gmaxdragon/Seizo-Screen/pcb-front.png

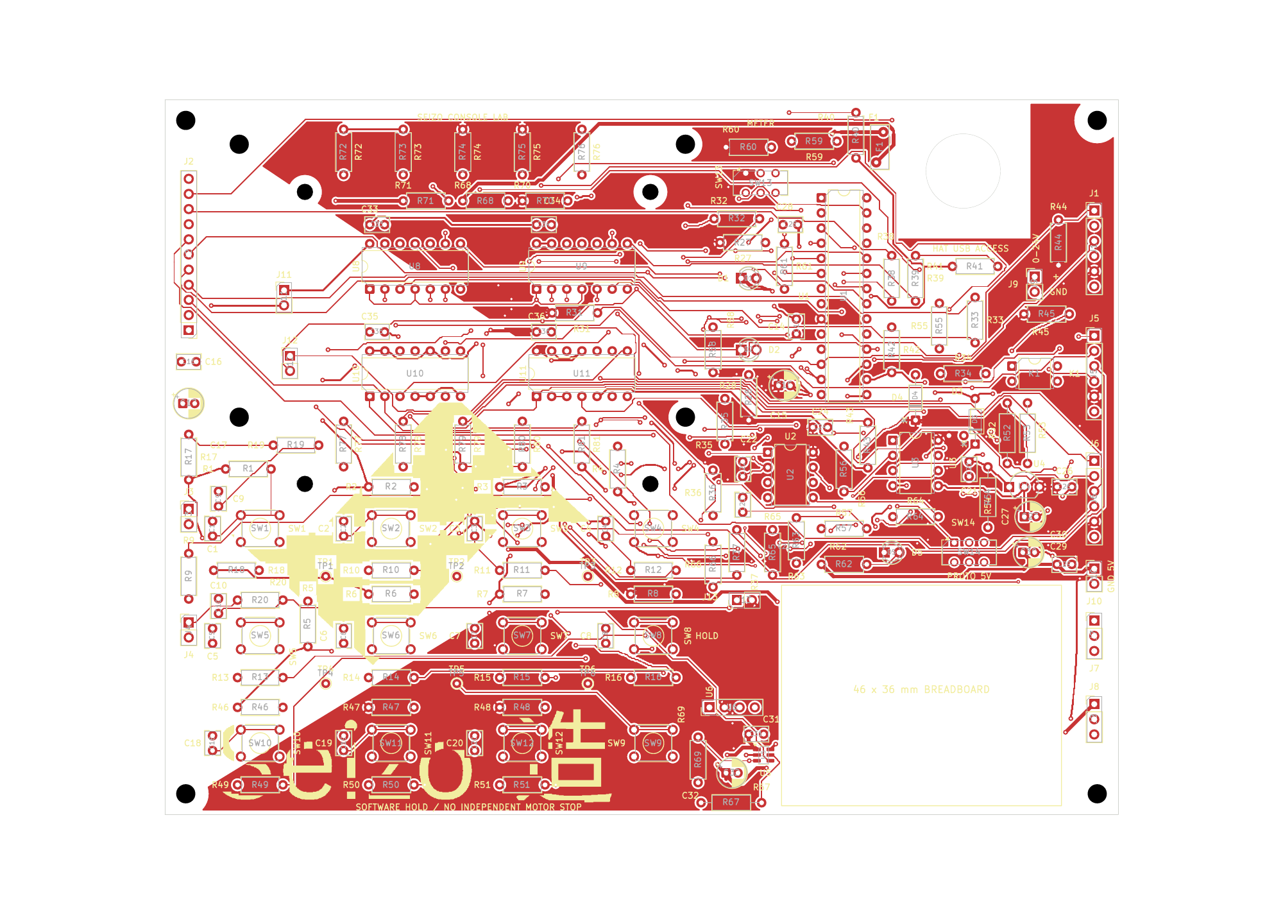
pcb-front.png
