gmaxdragon/Seizo-Screen/quotes/pcbway/preliminary-calculator.png

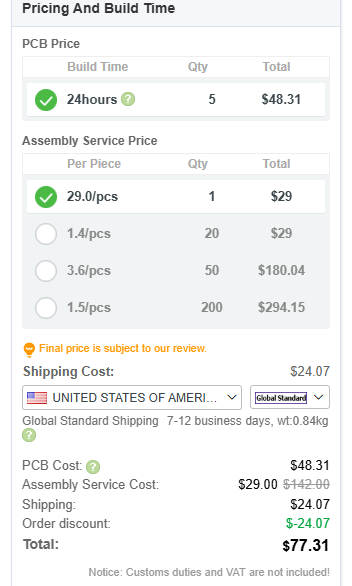
quotes/pcbway/preliminary-calculator.png
