gmaxdragon/Seizo-Screen/schematic-preview.png

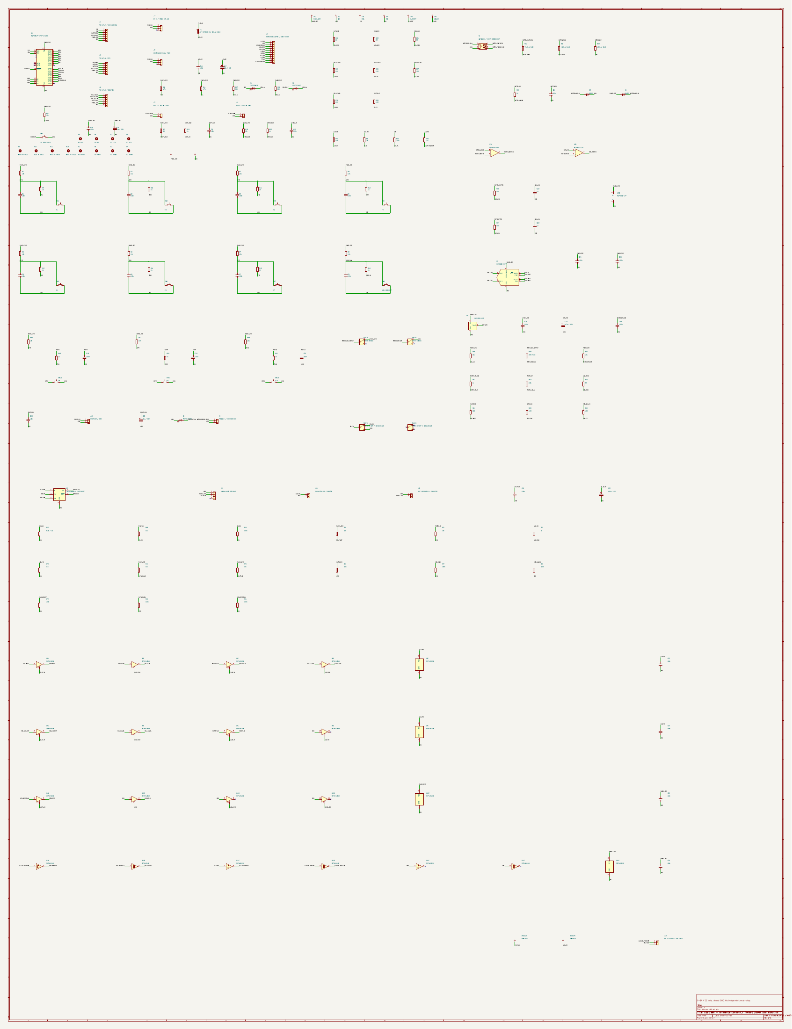
schematic-preview.png
