gmaxdragon/Seizo-Screen/Real_BOM.csv

NOTICE | Created because Half-Life's parts list had an 80-item (row) limit. Real_BOM.csv gives the complete ungrouped details; 00-bom-halflife.csv is the grouped 27-row submission import.
SCOPE | One assembled revision-23 panel: all 150 fitted components individually listed. The 48 fitted matching-HAT parts are separately identified dependencies outside the current panel quotation.
USE | Detailed reviewer/reference BOM. Keep assembly/BOM-PCBWay-panel.csv as the supplier assembly BOM. Do not import this detailed file into the 80-row funding form.
PRICES | Blank factory-price cells mean UNQUOTED. Historical references are dated 2026-10-31, not current offers. Preliminary PCB batch $48.31 plus assembly $29.00 excludes component supply. Shipping/tax go in the separate funding fields.
STATUS | Actual PCBWay panel RFQ submitted; supplier audit, exact cable/hardware sourcing, LCD tap qualification and physical tests pending. Independent arm stopping/gravity retention is a separate unresolved system.
QUANTITIES | Fitted-component quantities are for one board. Bare-PCB batch quantity is five; assembled-panel quantity is one. Zero-quantity features/DNP/owned-service checks are not new component orders.
Line | Section | Board | Reference | Description | Value | Quantity | Unit | Procurement scope | Manufacturer | Manufacturer part number | Distributor part number | KiCad footprint | Assembly process | PCB side | Factory quoted unit USD | Factory quoted line USD | Price status | Historical reference unit USD | Historical reference line USD | Price checked date | Product or reference source | Primary datasheet | Fit and assembly notes | Remaining confirmation | Source record
1 | Fitted component | Panel | C1 | 100n | 100n | 1 | piece | Panel assembly: new component supply | KEMET | C315C104K5R5TA | 399-C315C104K5R5TA-ND | Capacitor_THT:C_Rect_L4.0mm_W2.5mm_P2.50mm | THT | Top |  |  | Factory component price unquoted; historical price is a reference only | 0.488 | 0.488 | 2026-10-31 | https://www.digikey.com/en/products/detail/kemet/C315C104K5R5TA/12701330 | https://search.kemet.com/component-documentation/download/specsheet/C315C104K5R5TA | X7R 50V +/-10%; do not replace with large 5.08 mm-pitch discs. C25 is BACK; exact maximum envelope must be included in final opposite-side solder clearance check. No unapproved substitutions. L<=3.81 mm; T<=2.54 mm; H<=3.14 mm; coating below body<=1.52 mm; seated envelope<=4.66 mm; lead 0.51 +0.10/-0.025 mm; spacing 2.54 +/-0.78 mm; formed to PCB 2.50 mm | Final supplier sourcing/price and physical assembly/functional tests pending. | assembly/BOM-PCBWay-panel.csv; group 1; reports/panel-netlist.xml
2 | Fitted component | Panel | C2 | 100n | 100n | 1 | piece | Panel assembly: new component supply | KEMET | C315C104K5R5TA | 399-C315C104K5R5TA-ND | Capacitor_THT:C_Rect_L4.0mm_W2.5mm_P2.50mm | THT | Top |  |  | Factory component price unquoted; historical price is a reference only | 0.488 | 0.488 | 2026-10-31 | https://www.digikey.com/en/products/detail/kemet/C315C104K5R5TA/12701330 | https://search.kemet.com/component-documentation/download/specsheet/C315C104K5R5TA | X7R 50V +/-10%; do not replace with large 5.08 mm-pitch discs. C25 is BACK; exact maximum envelope must be included in final opposite-side solder clearance check. No unapproved substitutions. L<=3.81 mm; T<=2.54 mm; H<=3.14 mm; coating below body<=1.52 mm; seated envelope<=4.66 mm; lead 0.51 +0.10/-0.025 mm; spacing 2.54 +/-0.78 mm; formed to PCB 2.50 mm | Final supplier sourcing/price and physical assembly/functional tests pending. | assembly/BOM-PCBWay-panel.csv; group 1; reports/panel-netlist.xml
3 | Fitted component | Panel | C3 | 100n | 100n | 1 | piece | Panel assembly: new component supply | KEMET | C315C104K5R5TA | 399-C315C104K5R5TA-ND | Capacitor_THT:C_Rect_L4.0mm_W2.5mm_P2.50mm | THT | Top |  |  | Factory component price unquoted; historical price is a reference only | 0.488 | 0.488 | 2026-10-31 | https://www.digikey.com/en/products/detail/kemet/C315C104K5R5TA/12701330 | https://search.kemet.com/component-documentation/download/specsheet/C315C104K5R5TA | X7R 50V +/-10%; do not replace with large 5.08 mm-pitch discs. C25 is BACK; exact maximum envelope must be included in final opposite-side solder clearance check. No unapproved substitutions. L<=3.81 mm; T<=2.54 mm; H<=3.14 mm; coating below body<=1.52 mm; seated envelope<=4.66 mm; lead 0.51 +0.10/-0.025 mm; spacing 2.54 +/-0.78 mm; formed to PCB 2.50 mm | Final supplier sourcing/price and physical assembly/functional tests pending. | assembly/BOM-PCBWay-panel.csv; group 1; reports/panel-netlist.xml
4 | Fitted component | Panel | C4 | 100n | 100n | 1 | piece | Panel assembly: new component supply | KEMET | C315C104K5R5TA | 399-C315C104K5R5TA-ND | Capacitor_THT:C_Rect_L4.0mm_W2.5mm_P2.50mm | THT | Top |  |  | Factory component price unquoted; historical price is a reference only | 0.488 | 0.488 | 2026-10-31 | https://www.digikey.com/en/products/detail/kemet/C315C104K5R5TA/12701330 | https://search.kemet.com/component-documentation/download/specsheet/C315C104K5R5TA | X7R 50V +/-10%; do not replace with large 5.08 mm-pitch discs. C25 is BACK; exact maximum envelope must be included in final opposite-side solder clearance check. No unapproved substitutions. L<=3.81 mm; T<=2.54 mm; H<=3.14 mm; coating below body<=1.52 mm; seated envelope<=4.66 mm; lead 0.51 +0.10/-0.025 mm; spacing 2.54 +/-0.78 mm; formed to PCB 2.50 mm | Final supplier sourcing/price and physical assembly/functional tests pending. | assembly/BOM-PCBWay-panel.csv; group 1; reports/panel-netlist.xml
5 | Fitted component | Panel | C5 | 100n | 100n | 1 | piece | Panel assembly: new component supply | KEMET | C315C104K5R5TA | 399-C315C104K5R5TA-ND | Capacitor_THT:C_Rect_L4.0mm_W2.5mm_P2.50mm | THT | Top |  |  | Factory component price unquoted; historical price is a reference only | 0.488 | 0.488 | 2026-10-31 | https://www.digikey.com/en/products/detail/kemet/C315C104K5R5TA/12701330 | https://search.kemet.com/component-documentation/download/specsheet/C315C104K5R5TA | X7R 50V +/-10%; do not replace with large 5.08 mm-pitch discs. C25 is BACK; exact maximum envelope must be included in final opposite-side solder clearance check. No unapproved substitutions. L<=3.81 mm; T<=2.54 mm; H<=3.14 mm; coating below body<=1.52 mm; seated envelope<=4.66 mm; lead 0.51 +0.10/-0.025 mm; spacing 2.54 +/-0.78 mm; formed to PCB 2.50 mm | Final supplier sourcing/price and physical assembly/functional tests pending. | assembly/BOM-PCBWay-panel.csv; group 1; reports/panel-netlist.xml
6 | Fitted component | Panel | C6 | 100n | 100n | 1 | piece | Panel assembly: new component supply | KEMET | C315C104K5R5TA | 399-C315C104K5R5TA-ND | Capacitor_THT:C_Rect_L4.0mm_W2.5mm_P2.50mm | THT | Top |  |  | Factory component price unquoted; historical price is a reference only | 0.488 | 0.488 | 2026-10-31 | https://www.digikey.com/en/products/detail/kemet/C315C104K5R5TA/12701330 | https://search.kemet.com/component-documentation/download/specsheet/C315C104K5R5TA | X7R 50V +/-10%; do not replace with large 5.08 mm-pitch discs. C25 is BACK; exact maximum envelope must be included in final opposite-side solder clearance check. No unapproved substitutions. L<=3.81 mm; T<=2.54 mm; H<=3.14 mm; coating below body<=1.52 mm; seated envelope<=4.66 mm; lead 0.51 +0.10/-0.025 mm; spacing 2.54 +/-0.78 mm; formed to PCB 2.50 mm | Final supplier sourcing/price and physical assembly/functional tests pending. | assembly/BOM-PCBWay-panel.csv; group 1; reports/panel-netlist.xml
7 | Fitted component | Panel | C7 | 100n | 100n | 1 | piece | Panel assembly: new component supply | KEMET | C315C104K5R5TA | 399-C315C104K5R5TA-ND | Capacitor_THT:C_Rect_L4.0mm_W2.5mm_P2.50mm | THT | Top |  |  | Factory component price unquoted; historical price is a reference only | 0.488 | 0.488 | 2026-10-31 | https://www.digikey.com/en/products/detail/kemet/C315C104K5R5TA/12701330 | https://search.kemet.com/component-documentation/download/specsheet/C315C104K5R5TA | X7R 50V +/-10%; do not replace with large 5.08 mm-pitch discs. C25 is BACK; exact maximum envelope must be included in final opposite-side solder clearance check. No unapproved substitutions. L<=3.81 mm; T<=2.54 mm; H<=3.14 mm; coating below body<=1.52 mm; seated envelope<=4.66 mm; lead 0.51 +0.10/-0.025 mm; spacing 2.54 +/-0.78 mm; formed to PCB 2.50 mm | Final supplier sourcing/price and physical assembly/functional tests pending. | assembly/BOM-PCBWay-panel.csv; group 1; reports/panel-netlist.xml
8 | Fitted component | Panel | C8 | 100n | 100n | 1 | piece | Panel assembly: new component supply | KEMET | C315C104K5R5TA | 399-C315C104K5R5TA-ND | Capacitor_THT:C_Rect_L4.0mm_W2.5mm_P2.50mm | THT | Top |  |  | Factory component price unquoted; historical price is a reference only | 0.488 | 0.488 | 2026-10-31 | https://www.digikey.com/en/products/detail/kemet/C315C104K5R5TA/12701330 | https://search.kemet.com/component-documentation/download/specsheet/C315C104K5R5TA | X7R 50V +/-10%; do not replace with large 5.08 mm-pitch discs. C25 is BACK; exact maximum envelope must be included in final opposite-side solder clearance check. No unapproved substitutions. L<=3.81 mm; T<=2.54 mm; H<=3.14 mm; coating below body<=1.52 mm; seated envelope<=4.66 mm; lead 0.51 +0.10/-0.025 mm; spacing 2.54 +/-0.78 mm; formed to PCB 2.50 mm | Final supplier sourcing/price and physical assembly/functional tests pending. | assembly/BOM-PCBWay-panel.csv; group 1; reports/panel-netlist.xml
9 | Fitted component | Panel | C9 | 100n | 100n | 1 | piece | Panel assembly: new component supply | KEMET | C315C104K5R5TA | 399-C315C104K5R5TA-ND | Capacitor_THT:C_Rect_L4.0mm_W2.5mm_P2.50mm | THT | Top |  |  | Factory component price unquoted; historical price is a reference only | 0.488 | 0.488 | 2026-10-31 | https://www.digikey.com/en/products/detail/kemet/C315C104K5R5TA/12701330 | https://search.kemet.com/component-documentation/download/specsheet/C315C104K5R5TA | X7R 50V +/-10%; do not replace with large 5.08 mm-pitch discs. C25 is BACK; exact maximum envelope must be included in final opposite-side solder clearance check. No unapproved substitutions. L<=3.81 mm; T<=2.54 mm; H<=3.14 mm; coating below body<=1.52 mm; seated envelope<=4.66 mm; lead 0.51 +0.10/-0.025 mm; spacing 2.54 +/-0.78 mm; formed to PCB 2.50 mm | Final supplier sourcing/price and physical assembly/functional tests pending. | assembly/BOM-PCBWay-panel.csv; group 1; reports/panel-netlist.xml
10 | Fitted component | Panel | C10 | 100n | 100n | 1 | piece | Panel assembly: new component supply | KEMET | C315C104K5R5TA | 399-C315C104K5R5TA-ND | Capacitor_THT:C_Rect_L4.0mm_W2.5mm_P2.50mm | THT | Top |  |  | Factory component price unquoted; historical price is a reference only | 0.488 | 0.488 | 2026-10-31 | https://www.digikey.com/en/products/detail/kemet/C315C104K5R5TA/12701330 | https://search.kemet.com/component-documentation/download/specsheet/C315C104K5R5TA | X7R 50V +/-10%; do not replace with large 5.08 mm-pitch discs. C25 is BACK; exact maximum envelope must be included in final opposite-side solder clearance check. No unapproved substitutions. L<=3.81 mm; T<=2.54 mm; H<=3.14 mm; coating below body<=1.52 mm; seated envelope<=4.66 mm; lead 0.51 +0.10/-0.025 mm; spacing 2.54 +/-0.78 mm; formed to PCB 2.50 mm | Final supplier sourcing/price and physical assembly/functional tests pending. | assembly/BOM-PCBWay-panel.csv; group 1; reports/panel-netlist.xml
11 | Fitted component | Panel | C14 | 100n | 100n | 1 | piece | Panel assembly: new component supply | KEMET | C315C104K5R5TA | 399-C315C104K5R5TA-ND | Capacitor_THT:C_Rect_L4.0mm_W2.5mm_P2.50mm | THT | Top |  |  | Factory component price unquoted; historical price is a reference only | 0.488 | 0.488 | 2026-10-31 | https://www.digikey.com/en/products/detail/kemet/C315C104K5R5TA/12701330 | https://search.kemet.com/component-documentation/download/specsheet/C315C104K5R5TA | X7R 50V +/-10%; do not replace with large 5.08 mm-pitch discs. C25 is BACK; exact maximum envelope must be included in final opposite-side solder clearance check. No unapproved substitutions. L<=3.81 mm; T<=2.54 mm; H<=3.14 mm; coating below body<=1.52 mm; seated envelope<=4.66 mm; lead 0.51 +0.10/-0.025 mm; spacing 2.54 +/-0.78 mm; formed to PCB 2.50 mm | Final supplier sourcing/price and physical assembly/functional tests pending. | assembly/BOM-PCBWay-panel.csv; group 1; reports/panel-netlist.xml
12 | Fitted component | Panel | C16 | 100n | 100n | 1 | piece | Panel assembly: new component supply | KEMET | C315C104K5R5TA | 399-C315C104K5R5TA-ND | Capacitor_THT:C_Rect_L4.0mm_W2.5mm_P2.50mm | THT | Top |  |  | Factory component price unquoted; historical price is a reference only | 0.488 | 0.488 | 2026-10-31 | https://www.digikey.com/en/products/detail/kemet/C315C104K5R5TA/12701330 | https://search.kemet.com/component-documentation/download/specsheet/C315C104K5R5TA | X7R 50V +/-10%; do not replace with large 5.08 mm-pitch discs. C25 is BACK; exact maximum envelope must be included in final opposite-side solder clearance check. No unapproved substitutions. L<=3.81 mm; T<=2.54 mm; H<=3.14 mm; coating below body<=1.52 mm; seated envelope<=4.66 mm; lead 0.51 +0.10/-0.025 mm; spacing 2.54 +/-0.78 mm; formed to PCB 2.50 mm | Final supplier sourcing/price and physical assembly/functional tests pending. | assembly/BOM-PCBWay-panel.csv; group 1; reports/panel-netlist.xml
13 | Fitted component | Panel | C18 | 100n | 100n | 1 | piece | Panel assembly: new component supply | KEMET | C315C104K5R5TA | 399-C315C104K5R5TA-ND | Capacitor_THT:C_Rect_L4.0mm_W2.5mm_P2.50mm | THT | Top |  |  | Factory component price unquoted; historical price is a reference only | 0.488 | 0.488 | 2026-10-31 | https://www.digikey.com/en/products/detail/kemet/C315C104K5R5TA/12701330 | https://search.kemet.com/component-documentation/download/specsheet/C315C104K5R5TA | X7R 50V +/-10%; do not replace with large 5.08 mm-pitch discs. C25 is BACK; exact maximum envelope must be included in final opposite-side solder clearance check. No unapproved substitutions. L<=3.81 mm; T<=2.54 mm; H<=3.14 mm; coating below body<=1.52 mm; seated envelope<=4.66 mm; lead 0.51 +0.10/-0.025 mm; spacing 2.54 +/-0.78 mm; formed to PCB 2.50 mm | Final supplier sourcing/price and physical assembly/functional tests pending. | assembly/BOM-PCBWay-panel.csv; group 1; reports/panel-netlist.xml
14 | Fitted component | Panel | C19 | 100n | 100n | 1 | piece | Panel assembly: new component supply | KEMET | C315C104K5R5TA | 399-C315C104K5R5TA-ND | Capacitor_THT:C_Rect_L4.0mm_W2.5mm_P2.50mm | THT | Top |  |  | Factory component price unquoted; historical price is a reference only | 0.488 | 0.488 | 2026-10-31 | https://www.digikey.com/en/products/detail/kemet/C315C104K5R5TA/12701330 | https://search.kemet.com/component-documentation/download/specsheet/C315C104K5R5TA | X7R 50V +/-10%; do not replace with large 5.08 mm-pitch discs. C25 is BACK; exact maximum envelope must be included in final opposite-side solder clearance check. No unapproved substitutions. L<=3.81 mm; T<=2.54 mm; H<=3.14 mm; coating below body<=1.52 mm; seated envelope<=4.66 mm; lead 0.51 +0.10/-0.025 mm; spacing 2.54 +/-0.78 mm; formed to PCB 2.50 mm | Final supplier sourcing/price and physical assembly/functional tests pending. | assembly/BOM-PCBWay-panel.csv; group 1; reports/panel-netlist.xml
15 | Fitted component | Panel | C20 | 100n | 100n | 1 | piece | Panel assembly: new component supply | KEMET | C315C104K5R5TA | 399-C315C104K5R5TA-ND | Capacitor_THT:C_Rect_L4.0mm_W2.5mm_P2.50mm | THT | Top |  |  | Factory component price unquoted; historical price is a reference only | 0.488 | 0.488 | 2026-10-31 | https://www.digikey.com/en/products/detail/kemet/C315C104K5R5TA/12701330 | https://search.kemet.com/component-documentation/download/specsheet/C315C104K5R5TA | X7R 50V +/-10%; do not replace with large 5.08 mm-pitch discs. C25 is BACK; exact maximum envelope must be included in final opposite-side solder clearance check. No unapproved substitutions. L<=3.81 mm; T<=2.54 mm; H<=3.14 mm; coating below body<=1.52 mm; seated envelope<=4.66 mm; lead 0.51 +0.10/-0.025 mm; spacing 2.54 +/-0.78 mm; formed to PCB 2.50 mm | Final supplier sourcing/price and physical assembly/functional tests pending. | assembly/BOM-PCBWay-panel.csv; group 1; reports/panel-netlist.xml
16 | Fitted component | Panel | C21 | 100n | 100n | 1 | piece | Panel assembly: new component supply | KEMET | C315C104K5R5TA | 399-C315C104K5R5TA-ND | Capacitor_THT:C_Rect_L4.0mm_W2.5mm_P2.50mm | THT | Top |  |  | Factory component price unquoted; historical price is a reference only | 0.488 | 0.488 | 2026-10-31 | https://www.digikey.com/en/products/detail/kemet/C315C104K5R5TA/12701330 | https://search.kemet.com/component-documentation/download/specsheet/C315C104K5R5TA | X7R 50V +/-10%; do not replace with large 5.08 mm-pitch discs. C25 is BACK; exact maximum envelope must be included in final opposite-side solder clearance check. No unapproved substitutions. L<=3.81 mm; T<=2.54 mm; H<=3.14 mm; coating below body<=1.52 mm; seated envelope<=4.66 mm; lead 0.51 +0.10/-0.025 mm; spacing 2.54 +/-0.78 mm; formed to PCB 2.50 mm | Final supplier sourcing/price and physical assembly/functional tests pending. | assembly/BOM-PCBWay-panel.csv; group 1; reports/panel-netlist.xml
17 | Fitted component | Panel | C24 | 100n | 100n | 1 | piece | Panel assembly: new component supply | KEMET | C315C104K5R5TA | 399-C315C104K5R5TA-ND | Capacitor_THT:C_Rect_L4.0mm_W2.5mm_P2.50mm | THT | Top |  |  | Factory component price unquoted; historical price is a reference only | 0.488 | 0.488 | 2026-10-31 | https://www.digikey.com/en/products/detail/kemet/C315C104K5R5TA/12701330 | https://search.kemet.com/component-documentation/download/specsheet/C315C104K5R5TA | X7R 50V +/-10%; do not replace with large 5.08 mm-pitch discs. C25 is BACK; exact maximum envelope must be included in final opposite-side solder clearance check. No unapproved substitutions. L<=3.81 mm; T<=2.54 mm; H<=3.14 mm; coating below body<=1.52 mm; seated envelope<=4.66 mm; lead 0.51 +0.10/-0.025 mm; spacing 2.54 +/-0.78 mm; formed to PCB 2.50 mm | Final supplier sourcing/price and physical assembly/functional tests pending. | assembly/BOM-PCBWay-panel.csv; group 1; reports/panel-netlist.xml
18 | Fitted component | Panel | C26 | 100n | 100n | 1 | piece | Panel assembly: new component supply | KEMET | C315C104K5R5TA | 399-C315C104K5R5TA-ND | Capacitor_THT:C_Rect_L4.0mm_W2.5mm_P2.50mm | THT | Top |  |  | Factory component price unquoted; historical price is a reference only | 0.488 | 0.488 | 2026-10-31 | https://www.digikey.com/en/products/detail/kemet/C315C104K5R5TA/12701330 | https://search.kemet.com/component-documentation/download/specsheet/C315C104K5R5TA | X7R 50V +/-10%; do not replace with large 5.08 mm-pitch discs. C25 is BACK; exact maximum envelope must be included in final opposite-side solder clearance check. No unapproved substitutions. L<=3.81 mm; T<=2.54 mm; H<=3.14 mm; coating below body<=1.52 mm; seated envelope<=4.66 mm; lead 0.51 +0.10/-0.025 mm; spacing 2.54 +/-0.78 mm; formed to PCB 2.50 mm | Final supplier sourcing/price and physical assembly/functional tests pending. | assembly/BOM-PCBWay-panel.csv; group 1; reports/panel-netlist.xml
19 | Fitted component | Panel | C28 | 100n | 100n | 1 | piece | Panel assembly: new component supply | KEMET | C315C104K5R5TA | 399-C315C104K5R5TA-ND | Capacitor_THT:C_Rect_L4.0mm_W2.5mm_P2.50mm | THT | Top |  |  | Factory component price unquoted; historical price is a reference only | 0.488 | 0.488 | 2026-10-31 | https://www.digikey.com/en/products/detail/kemet/C315C104K5R5TA/12701330 | https://search.kemet.com/component-documentation/download/specsheet/C315C104K5R5TA | X7R 50V +/-10%; do not replace with large 5.08 mm-pitch discs. C25 is BACK; exact maximum envelope must be included in final opposite-side solder clearance check. No unapproved substitutions. L<=3.81 mm; T<=2.54 mm; H<=3.14 mm; coating below body<=1.52 mm; seated envelope<=4.66 mm; lead 0.51 +0.10/-0.025 mm; spacing 2.54 +/-0.78 mm; formed to PCB 2.50 mm | Final supplier sourcing/price and physical assembly/functional tests pending. | assembly/BOM-PCBWay-panel.csv; group 1; reports/panel-netlist.xml
20 | Fitted component | Panel | C29 | 100n | 100n | 1 | piece | Panel assembly: new component supply | KEMET | C315C104K5R5TA | 399-C315C104K5R5TA-ND | Capacitor_THT:C_Rect_L4.0mm_W2.5mm_P2.50mm | THT | Top |  |  | Factory component price unquoted; historical price is a reference only | 0.488 | 0.488 | 2026-10-31 | https://www.digikey.com/en/products/detail/kemet/C315C104K5R5TA/12701330 | https://search.kemet.com/component-documentation/download/specsheet/C315C104K5R5TA | X7R 50V +/-10%; do not replace with large 5.08 mm-pitch discs. C25 is BACK; exact maximum envelope must be included in final opposite-side solder clearance check. No unapproved substitutions. L<=3.81 mm; T<=2.54 mm; H<=3.14 mm; coating below body<=1.52 mm; seated envelope<=4.66 mm; lead 0.51 +0.10/-0.025 mm; spacing 2.54 +/-0.78 mm; formed to PCB 2.50 mm | Final supplier sourcing/price and physical assembly/functional tests pending. | assembly/BOM-PCBWay-panel.csv; group 1; reports/panel-netlist.xml
21 | Fitted component | Panel | C31 | 100n | 100n | 1 | piece | Panel assembly: new component supply | KEMET | C315C104K5R5TA | 399-C315C104K5R5TA-ND | Capacitor_THT:C_Rect_L4.0mm_W2.5mm_P2.50mm | THT | Top |  |  | Factory component price unquoted; historical price is a reference only | 0.488 | 0.488 | 2026-10-31 | https://www.digikey.com/en/products/detail/kemet/C315C104K5R5TA/12701330 | https://search.kemet.com/component-documentation/download/specsheet/C315C104K5R5TA | X7R 50V +/-10%; do not replace with large 5.08 mm-pitch discs. C25 is BACK; exact maximum envelope must be included in final opposite-side solder clearance check. No unapproved substitutions. L<=3.81 mm; T<=2.54 mm; H<=3.14 mm; coating below body<=1.52 mm; seated envelope<=4.66 mm; lead 0.51 +0.10/-0.025 mm; spacing 2.54 +/-0.78 mm; formed to PCB 2.50 mm | Final supplier sourcing/price and physical assembly/functional tests pending. | assembly/BOM-PCBWay-panel.csv; group 1; reports/panel-netlist.xml
22 | Fitted component | Panel | C33 | 100n | 100n | 1 | piece | Panel assembly: new component supply | KEMET | C315C104K5R5TA | 399-C315C104K5R5TA-ND | Capacitor_THT:C_Rect_L4.0mm_W2.5mm_P2.50mm | THT | Top |  |  | Factory component price unquoted; historical price is a reference only | 0.488 | 0.488 | 2026-10-31 | https://www.digikey.com/en/products/detail/kemet/C315C104K5R5TA/12701330 | https://search.kemet.com/component-documentation/download/specsheet/C315C104K5R5TA | X7R 50V +/-10%; do not replace with large 5.08 mm-pitch discs. C25 is BACK; exact maximum envelope must be included in final opposite-side solder clearance check. No unapproved substitutions. L<=3.81 mm; T<=2.54 mm; H<=3.14 mm; coating below body<=1.52 mm; seated envelope<=4.66 mm; lead 0.51 +0.10/-0.025 mm; spacing 2.54 +/-0.78 mm; formed to PCB 2.50 mm | Final supplier sourcing/price and physical assembly/functional tests pending. | assembly/BOM-PCBWay-panel.csv; group 1; reports/panel-netlist.xml
23 | Fitted component | Panel | C34 | 100n | 100n | 1 | piece | Panel assembly: new component supply | KEMET | C315C104K5R5TA | 399-C315C104K5R5TA-ND | Capacitor_THT:C_Rect_L4.0mm_W2.5mm_P2.50mm | THT | Top |  |  | Factory component price unquoted; historical price is a reference only | 0.488 | 0.488 | 2026-10-31 | https://www.digikey.com/en/products/detail/kemet/C315C104K5R5TA/12701330 | https://search.kemet.com/component-documentation/download/specsheet/C315C104K5R5TA | X7R 50V +/-10%; do not replace with large 5.08 mm-pitch discs. C25 is BACK; exact maximum envelope must be included in final opposite-side solder clearance check. No unapproved substitutions. L<=3.81 mm; T<=2.54 mm; H<=3.14 mm; coating below body<=1.52 mm; seated envelope<=4.66 mm; lead 0.51 +0.10/-0.025 mm; spacing 2.54 +/-0.78 mm; formed to PCB 2.50 mm | Final supplier sourcing/price and physical assembly/functional tests pending. | assembly/BOM-PCBWay-panel.csv; group 1; reports/panel-netlist.xml
24 | Fitted component | Panel | C35 | 100n | 100n | 1 | piece | Panel assembly: new component supply | KEMET | C315C104K5R5TA | 399-C315C104K5R5TA-ND | Capacitor_THT:C_Rect_L4.0mm_W2.5mm_P2.50mm | THT | Top |  |  | Factory component price unquoted; historical price is a reference only | 0.488 | 0.488 | 2026-10-31 | https://www.digikey.com/en/products/detail/kemet/C315C104K5R5TA/12701330 | https://search.kemet.com/component-documentation/download/specsheet/C315C104K5R5TA | X7R 50V +/-10%; do not replace with large 5.08 mm-pitch discs. C25 is BACK; exact maximum envelope must be included in final opposite-side solder clearance check. No unapproved substitutions. L<=3.81 mm; T<=2.54 mm; H<=3.14 mm; coating below body<=1.52 mm; seated envelope<=4.66 mm; lead 0.51 +0.10/-0.025 mm; spacing 2.54 +/-0.78 mm; formed to PCB 2.50 mm | Final supplier sourcing/price and physical assembly/functional tests pending. | assembly/BOM-PCBWay-panel.csv; group 1; reports/panel-netlist.xml
25 | Fitted component | Panel | C36 | 100n | 100n | 1 | piece | Panel assembly: new component supply | KEMET | C315C104K5R5TA | 399-C315C104K5R5TA-ND | Capacitor_THT:C_Rect_L4.0mm_W2.5mm_P2.50mm | THT | Top |  |  | Factory component price unquoted; historical price is a reference only | 0.488 | 0.488 | 2026-10-31 | https://www.digikey.com/en/products/detail/kemet/C315C104K5R5TA/12701330 | https://search.kemet.com/component-documentation/download/specsheet/C315C104K5R5TA | X7R 50V +/-10%; do not replace with large 5.08 mm-pitch discs. C25 is BACK; exact maximum envelope must be included in final opposite-side solder clearance check. No unapproved substitutions. L<=3.81 mm; T<=2.54 mm; H<=3.14 mm; coating below body<=1.52 mm; seated envelope<=4.66 mm; lead 0.51 +0.10/-0.025 mm; spacing 2.54 +/-0.78 mm; formed to PCB 2.50 mm | Final supplier sourcing/price and physical assembly/functional tests pending. | assembly/BOM-PCBWay-panel.csv; group 1; reports/panel-netlist.xml
26 | Fitted component | Panel | C25 | 100n | 100n | 1 | piece | Panel assembly: new component supply | KEMET | C315C104K5R5TA | 399-C315C104K5R5TA-ND | Capacitor_THT:C_Rect_L4.0mm_W2.5mm_P2.50mm | THT | Bottom |  |  | Factory component price unquoted; historical price is a reference only | 0.488 | 0.488 | 2026-10-31 | https://www.digikey.com/en/products/detail/kemet/C315C104K5R5TA/12701330 | https://search.kemet.com/component-documentation/download/specsheet/C315C104K5R5TA | X7R 50V +/-10%; do not replace with large 5.08 mm-pitch discs. C25 is BACK; exact maximum envelope must be included in final opposite-side solder clearance check. Install body at least 1.5mm above rear PCB face; nearby clipped rear lead ends at most 1.0mm; no solder spikes. No unapproved substitutions. L<=3.81 mm; T<=2.54 mm; H<=3.14 mm; coating below body<=1.52 mm; seated envelope<=4.66 mm; lead 0.51 +0.10/-0.025 mm; spacing 2.54 +/-0.78 mm; formed to PCB 2.50 mm | Final supplier sourcing/price and physical assembly/functional tests pending. Check rear body clearance >=1.5 mm and clipped adjacent leads <=1.0 mm. | assembly/BOM-PCBWay-panel.csv; group 2; reports/panel-netlist.xml
27 | Fitted component | Panel | C22 | 1n | 1n | 1 | piece | Panel assembly: new component supply | KEMET | C315C102J1G5TA | 399-4143-ND | Capacitor_THT:C_Rect_L4.0mm_W2.5mm_P2.50mm | THT | Top |  |  | Factory component price unquoted; historical price is a reference only | 0.77 | 0.77 | 2026-10-31 | https://www.digikey.com/en/products/detail/kemet/C315C102J1G5TA/817919 | https://yageogroup.com/content/datasheet/asset/file/KEM_C1049_GOLDMAX_C0G | C0G 100V +/-5%; retain low-loss dielectric. No unapproved substitutions. L<=3.81 mm; T<=2.54 mm; H<=3.14 mm; coating below body<=1.52 mm; seated envelope<=4.66 mm; lead 0.51 +0.10/-0.025 mm; spacing 2.54 +/-0.78 mm; formed to PCB 2.50 mm | Final supplier sourcing/price and physical assembly/functional tests pending. | assembly/BOM-PCBWay-panel.csv; group 3; reports/panel-netlist.xml
28 | Fitted component | Panel | C23 | 1n | 1n | 1 | piece | Panel assembly: new component supply | KEMET | C315C102J1G5TA | 399-4143-ND | Capacitor_THT:C_Rect_L4.0mm_W2.5mm_P2.50mm | THT | Top |  |  | Factory component price unquoted; historical price is a reference only | 0.77 | 0.77 | 2026-10-31 | https://www.digikey.com/en/products/detail/kemet/C315C102J1G5TA/817919 | https://yageogroup.com/content/datasheet/asset/file/KEM_C1049_GOLDMAX_C0G | C0G 100V +/-5%; retain low-loss dielectric. No unapproved substitutions. L<=3.81 mm; T<=2.54 mm; H<=3.14 mm; coating below body<=1.52 mm; seated envelope<=4.66 mm; lead 0.51 +0.10/-0.025 mm; spacing 2.54 +/-0.78 mm; formed to PCB 2.50 mm | Final supplier sourcing/price and physical assembly/functional tests pending. | assembly/BOM-PCBWay-panel.csv; group 3; reports/panel-netlist.xml
29 | Fitted component | Panel | C15 | 10u / 50V | 10u / 50V | 1 | piece | Panel assembly: new component supply | Panasonic | EEU-FR1H100 | P124233-ND | Capacitor_THT:CP_Radial_D5.0mm_P2.00mm | THT | Top |  |  | Factory component price unquoted; historical price is a reference only | 0.41 | 0.41 | 2026-10-31 | https://www.digikey.com/en/products/detail/panasonic-industry/EEU-FR1H100/9921028 | https://industrial.panasonic.com/cdbs/www-data/pdf/RDF0000/ABA0000C1259.pdf | Polarized; lead pitch is 2 mm, not 2.5 mm. Manufacturer model dimensions also available at Panasonic product page. No unapproved substitutions. Body sleeveD5.0+/-0.5=>5.5MAX, L11+/-1.5=>12.5MAX mm; P2.0+/-0.5 mm; lead0.50+/-0.05=>0.55MAX mm | Final supplier sourcing/price and physical assembly/functional tests pending. | assembly/BOM-PCBWay-panel.csv; group 4; reports/panel-netlist.xml
30 | Fitted component | Panel | C17 | 10u / 50V | 10u / 50V | 1 | piece | Panel assembly: new component supply | Panasonic | EEU-FR1H100 | P124233-ND | Capacitor_THT:CP_Radial_D5.0mm_P2.00mm | THT | Top |  |  | Factory component price unquoted; historical price is a reference only | 0.41 | 0.41 | 2026-10-31 | https://www.digikey.com/en/products/detail/panasonic-industry/EEU-FR1H100/9921028 | https://industrial.panasonic.com/cdbs/www-data/pdf/RDF0000/ABA0000C1259.pdf | Polarized; lead pitch is 2 mm, not 2.5 mm. Manufacturer model dimensions also available at Panasonic product page. No unapproved substitutions. Body sleeveD5.0+/-0.5=>5.5MAX, L11+/-1.5=>12.5MAX mm; P2.0+/-0.5 mm; lead0.50+/-0.05=>0.55MAX mm | Final supplier sourcing/price and physical assembly/functional tests pending. | assembly/BOM-PCBWay-panel.csv; group 4; reports/panel-netlist.xml
31 | Fitted component | Panel | C30 | 10u / 50V | 10u / 50V | 1 | piece | Panel assembly: new component supply | Panasonic | EEU-FR1H100 | P124233-ND | Capacitor_THT:CP_Radial_D5.0mm_P2.00mm | THT | Top |  |  | Factory component price unquoted; historical price is a reference only | 0.41 | 0.41 | 2026-10-31 | https://www.digikey.com/en/products/detail/panasonic-industry/EEU-FR1H100/9921028 | https://industrial.panasonic.com/cdbs/www-data/pdf/RDF0000/ABA0000C1259.pdf | Polarized; lead pitch is 2 mm, not 2.5 mm. Manufacturer model dimensions also available at Panasonic product page. No unapproved substitutions. Body sleeveD5.0+/-0.5=>5.5MAX, L11+/-1.5=>12.5MAX mm; P2.0+/-0.5 mm; lead0.50+/-0.05=>0.55MAX mm | Final supplier sourcing/price and physical assembly/functional tests pending. | assembly/BOM-PCBWay-panel.csv; group 4; reports/panel-netlist.xml
32 | Fitted component | Panel | C27 | 4.7u / 50V | 4.7u / 50V | 1 | piece | Panel assembly: new component supply | Rubycon | 50YXJ4.7M5X11 | 50YXJ4.7M5X11-ND | Capacitor_THT:CP_Radial_D5.0mm_P2.00mm | THT | Top |  |  | Factory component price unquoted; historical price is a reference only | 0.28 | 0.28 | 2026-10-31 | https://www.digikey.com/en/products/detail/rubycon/50YXJ4-7M5X11/3562902 | https://www.rubycon.co.jp/wp-content/uploads/catalog-aluminum/YXJ.pdf | Selected replacement removes separate Mouser shipment. 4.7u+/-20%=3.76..5.64u meets MCP1525 CL1..10u. 50V rating exceeds2.5V rail;5000h105C; leakage<=3uA; impedance1.9ohmMAX@100kHz/20C. MCP1525 datasheet states no numericESRwindow; assembledstartup/noise/stabilityremainprototypechecks. Matchstripe/minus to pad2/GND, positivepad1/REF_2V5. No unapproved substitutions. SleeveD5+0.5=>5.5MAX mm; seatedL11+1.5=>12.5MAX mm; pitch2.0+/-0.5mm; leadD0.5nominal (seriesdrawingdoesnotstateabsolutemax); nativeP2.0/drill0.8mm | Final supplier sourcing/price and physical assembly/functional tests pending. | assembly/BOM-PCBWay-panel.csv; group 5; reports/panel-netlist.xml
33 | Fitted component | Panel | R35 | 100 | 100 | 1 | piece | Panel assembly: new component supply | Yageo | MFR-12FTF52-100R | 13-MFR-12FTF52-100RCT-ND | Resistor_THT:R_Axial_DIN0207_L6.3mm_D2.5mm_P7.62mm_Horizontal | THT | Top |  |  | Factory component price unquoted; historical price is a reference only | 0.038 | 0.038 | 2026-10-31 | https://www.digikey.com/en/products/detail/yageo/MFR-12FTF52-100R/9133808 | https://yageogroup.com/content/Resource%20Library/Datasheet/YAGEO-MFR_DATASHEET.pdf | 100ohm1%,1/6W@70C,100ppm/K; FTF means box-packed straight leads, not preformed M-type. Same logic-series resistance.8mA continuous design current dissipates6.4mW; not a fuse or independent stop. Slightly wider body than oldMRS16 passed independent native max-envelope audit without any PCB movement. No unapproved substitutions. MFR-12 bodyL3.4+/-0.3=>3.7MAX xD1.9+/-0.2=>2.1MAX mm; leadD0.45+/-0.05=>0.50MAX; straight52.4mm tape spacing, manually formed to native7.62mm lead pitch | Final supplier sourcing/price and physical assembly/functional tests pending. | assembly/BOM-PCBWay-panel.csv; group 6; reports/panel-netlist.xml
34 | Fitted component | Panel | R36 | 100 | 100 | 1 | piece | Panel assembly: new component supply | Yageo | MFR-12FTF52-100R | 13-MFR-12FTF52-100RCT-ND | Resistor_THT:R_Axial_DIN0207_L6.3mm_D2.5mm_P7.62mm_Horizontal | THT | Top |  |  | Factory component price unquoted; historical price is a reference only | 0.038 | 0.038 | 2026-10-31 | https://www.digikey.com/en/products/detail/yageo/MFR-12FTF52-100R/9133808 | https://yageogroup.com/content/Resource%20Library/Datasheet/YAGEO-MFR_DATASHEET.pdf | 100ohm1%,1/6W@70C,100ppm/K; FTF means box-packed straight leads, not preformed M-type. Same logic-series resistance.8mA continuous design current dissipates6.4mW; not a fuse or independent stop. Slightly wider body than oldMRS16 passed independent native max-envelope audit without any PCB movement. No unapproved substitutions. MFR-12 bodyL3.4+/-0.3=>3.7MAX xD1.9+/-0.2=>2.1MAX mm; leadD0.45+/-0.05=>0.50MAX; straight52.4mm tape spacing, manually formed to native7.62mm lead pitch | Final supplier sourcing/price and physical assembly/functional tests pending. | assembly/BOM-PCBWay-panel.csv; group 6; reports/panel-netlist.xml
35 | Fitted component | Panel | R37 | 100 | 100 | 1 | piece | Panel assembly: new component supply | Yageo | MFR-12FTF52-100R | 13-MFR-12FTF52-100RCT-ND | Resistor_THT:R_Axial_DIN0207_L6.3mm_D2.5mm_P7.62mm_Horizontal | THT | Top |  |  | Factory component price unquoted; historical price is a reference only | 0.038 | 0.038 | 2026-10-31 | https://www.digikey.com/en/products/detail/yageo/MFR-12FTF52-100R/9133808 | https://yageogroup.com/content/Resource%20Library/Datasheet/YAGEO-MFR_DATASHEET.pdf | 100ohm1%,1/6W@70C,100ppm/K; FTF means box-packed straight leads, not preformed M-type. Same logic-series resistance.8mA continuous design current dissipates6.4mW; not a fuse or independent stop. Slightly wider body than oldMRS16 passed independent native max-envelope audit without any PCB movement. No unapproved substitutions. MFR-12 bodyL3.4+/-0.3=>3.7MAX xD1.9+/-0.2=>2.1MAX mm; leadD0.45+/-0.05=>0.50MAX; straight52.4mm tape spacing, manually formed to native7.62mm lead pitch | Final supplier sourcing/price and physical assembly/functional tests pending. | assembly/BOM-PCBWay-panel.csv; group 6; reports/panel-netlist.xml
36 | Fitted component | Panel | R38 | 100 | 100 | 1 | piece | Panel assembly: new component supply | Yageo | MFR-12FTF52-100R | 13-MFR-12FTF52-100RCT-ND | Resistor_THT:R_Axial_DIN0207_L6.3mm_D2.5mm_P7.62mm_Horizontal | THT | Top |  |  | Factory component price unquoted; historical price is a reference only | 0.038 | 0.038 | 2026-10-31 | https://www.digikey.com/en/products/detail/yageo/MFR-12FTF52-100R/9133808 | https://yageogroup.com/content/Resource%20Library/Datasheet/YAGEO-MFR_DATASHEET.pdf | 100ohm1%,1/6W@70C,100ppm/K; FTF means box-packed straight leads, not preformed M-type. Same logic-series resistance.8mA continuous design current dissipates6.4mW; not a fuse or independent stop. Slightly wider body than oldMRS16 passed independent native max-envelope audit without any PCB movement. No unapproved substitutions. MFR-12 bodyL3.4+/-0.3=>3.7MAX xD1.9+/-0.2=>2.1MAX mm; leadD0.45+/-0.05=>0.50MAX; straight52.4mm tape spacing, manually formed to native7.62mm lead pitch | Final supplier sourcing/price and physical assembly/functional tests pending. | assembly/BOM-PCBWay-panel.csv; group 6; reports/panel-netlist.xml
37 | Fitted component | Panel | R39 | 100 | 100 | 1 | piece | Panel assembly: new component supply | Yageo | MFR-12FTF52-100R | 13-MFR-12FTF52-100RCT-ND | Resistor_THT:R_Axial_DIN0207_L6.3mm_D2.5mm_P7.62mm_Horizontal | THT | Top |  |  | Factory component price unquoted; historical price is a reference only | 0.038 | 0.038 | 2026-10-31 | https://www.digikey.com/en/products/detail/yageo/MFR-12FTF52-100R/9133808 | https://yageogroup.com/content/Resource%20Library/Datasheet/YAGEO-MFR_DATASHEET.pdf | 100ohm1%,1/6W@70C,100ppm/K; FTF means box-packed straight leads, not preformed M-type. Same logic-series resistance.8mA continuous design current dissipates6.4mW; not a fuse or independent stop. Slightly wider body than oldMRS16 passed independent native max-envelope audit without any PCB movement. No unapproved substitutions. MFR-12 bodyL3.4+/-0.3=>3.7MAX xD1.9+/-0.2=>2.1MAX mm; leadD0.45+/-0.05=>0.50MAX; straight52.4mm tape spacing, manually formed to native7.62mm lead pitch | Final supplier sourcing/price and physical assembly/functional tests pending. | assembly/BOM-PCBWay-panel.csv; group 6; reports/panel-netlist.xml
38 | Fitted component | Panel | R56 | 100 | 100 | 1 | piece | Panel assembly: new component supply | Yageo | MFR-12FTF52-100R | 13-MFR-12FTF52-100RCT-ND | Resistor_THT:R_Axial_DIN0207_L6.3mm_D2.5mm_P7.62mm_Horizontal | THT | Top |  |  | Factory component price unquoted; historical price is a reference only | 0.038 | 0.038 | 2026-10-31 | https://www.digikey.com/en/products/detail/yageo/MFR-12FTF52-100R/9133808 | https://yageogroup.com/content/Resource%20Library/Datasheet/YAGEO-MFR_DATASHEET.pdf | 100ohm1%,1/6W@70C,100ppm/K; FTF means box-packed straight leads, not preformed M-type. Same logic-series resistance.8mA continuous design current dissipates6.4mW; not a fuse or independent stop. Slightly wider body than oldMRS16 passed independent native max-envelope audit without any PCB movement. No unapproved substitutions. MFR-12 bodyL3.4+/-0.3=>3.7MAX xD1.9+/-0.2=>2.1MAX mm; leadD0.45+/-0.05=>0.50MAX; straight52.4mm tape spacing, manually formed to native7.62mm lead pitch | Final supplier sourcing/price and physical assembly/functional tests pending. | assembly/BOM-PCBWay-panel.csv; group 6; reports/panel-netlist.xml
39 | Fitted component | Panel | R57 | 100 | 100 | 1 | piece | Panel assembly: new component supply | Yageo | MFR-12FTF52-100R | 13-MFR-12FTF52-100RCT-ND | Resistor_THT:R_Axial_DIN0207_L6.3mm_D2.5mm_P7.62mm_Horizontal | THT | Top |  |  | Factory component price unquoted; historical price is a reference only | 0.038 | 0.038 | 2026-10-31 | https://www.digikey.com/en/products/detail/yageo/MFR-12FTF52-100R/9133808 | https://yageogroup.com/content/Resource%20Library/Datasheet/YAGEO-MFR_DATASHEET.pdf | 100ohm1%,1/6W@70C,100ppm/K; FTF means box-packed straight leads, not preformed M-type. Same logic-series resistance.8mA continuous design current dissipates6.4mW; not a fuse or independent stop. Slightly wider body than oldMRS16 passed independent native max-envelope audit without any PCB movement. No unapproved substitutions. MFR-12 bodyL3.4+/-0.3=>3.7MAX xD1.9+/-0.2=>2.1MAX mm; leadD0.45+/-0.05=>0.50MAX; straight52.4mm tape spacing, manually formed to native7.62mm lead pitch | Final supplier sourcing/price and physical assembly/functional tests pending. | assembly/BOM-PCBWay-panel.csv; group 6; reports/panel-netlist.xml
40 | Fitted component | Panel | R64 | 100 | 100 | 1 | piece | Panel assembly: new component supply | Yageo | MFR-12FTF52-100R | 13-MFR-12FTF52-100RCT-ND | Resistor_THT:R_Axial_DIN0207_L6.3mm_D2.5mm_P7.62mm_Horizontal | THT | Top |  |  | Factory component price unquoted; historical price is a reference only | 0.038 | 0.038 | 2026-10-31 | https://www.digikey.com/en/products/detail/yageo/MFR-12FTF52-100R/9133808 | https://yageogroup.com/content/Resource%20Library/Datasheet/YAGEO-MFR_DATASHEET.pdf | 100ohm1%,1/6W@70C,100ppm/K; FTF means box-packed straight leads, not preformed M-type. Same logic-series resistance.8mA continuous design current dissipates6.4mW; not a fuse or independent stop. Slightly wider body than oldMRS16 passed independent native max-envelope audit without any PCB movement. No unapproved substitutions. MFR-12 bodyL3.4+/-0.3=>3.7MAX xD1.9+/-0.2=>2.1MAX mm; leadD0.45+/-0.05=>0.50MAX; straight52.4mm tape spacing, manually formed to native7.62mm lead pitch | Final supplier sourcing/price and physical assembly/functional tests pending. | assembly/BOM-PCBWay-panel.csv; group 6; reports/panel-netlist.xml
41 | Fitted component | Panel | R65 | 100 | 100 | 1 | piece | Panel assembly: new component supply | Yageo | MFR-12FTF52-100R | 13-MFR-12FTF52-100RCT-ND | Resistor_THT:R_Axial_DIN0207_L6.3mm_D2.5mm_P7.62mm_Horizontal | THT | Top |  |  | Factory component price unquoted; historical price is a reference only | 0.038 | 0.038 | 2026-10-31 | https://www.digikey.com/en/products/detail/yageo/MFR-12FTF52-100R/9133808 | https://yageogroup.com/content/Resource%20Library/Datasheet/YAGEO-MFR_DATASHEET.pdf | 100ohm1%,1/6W@70C,100ppm/K; FTF means box-packed straight leads, not preformed M-type. Same logic-series resistance.8mA continuous design current dissipates6.4mW; not a fuse or independent stop. Slightly wider body than oldMRS16 passed independent native max-envelope audit without any PCB movement. No unapproved substitutions. MFR-12 bodyL3.4+/-0.3=>3.7MAX xD1.9+/-0.2=>2.1MAX mm; leadD0.45+/-0.05=>0.50MAX; straight52.4mm tape spacing, manually formed to native7.62mm lead pitch | Final supplier sourcing/price and physical assembly/functional tests pending. | assembly/BOM-PCBWay-panel.csv; group 6; reports/panel-netlist.xml
42 | Fitted component | Panel | R66 | 100 | 100 | 1 | piece | Panel assembly: new component supply | Yageo | MFR-12FTF52-100R | 13-MFR-12FTF52-100RCT-ND | Resistor_THT:R_Axial_DIN0207_L6.3mm_D2.5mm_P7.62mm_Horizontal | THT | Top |  |  | Factory component price unquoted; historical price is a reference only | 0.038 | 0.038 | 2026-10-31 | https://www.digikey.com/en/products/detail/yageo/MFR-12FTF52-100R/9133808 | https://yageogroup.com/content/Resource%20Library/Datasheet/YAGEO-MFR_DATASHEET.pdf | 100ohm1%,1/6W@70C,100ppm/K; FTF means box-packed straight leads, not preformed M-type. Same logic-series resistance.8mA continuous design current dissipates6.4mW; not a fuse or independent stop. Slightly wider body than oldMRS16 passed independent native max-envelope audit without any PCB movement. No unapproved substitutions. MFR-12 bodyL3.4+/-0.3=>3.7MAX xD1.9+/-0.2=>2.1MAX mm; leadD0.45+/-0.05=>0.50MAX; straight52.4mm tape spacing, manually formed to native7.62mm lead pitch | Final supplier sourcing/price and physical assembly/functional tests pending. | assembly/BOM-PCBWay-panel.csv; group 6; reports/panel-netlist.xml
43 | Fitted component | Panel | R32 | 33 | 33 | 1 | piece | Panel assembly: new component supply | Vishay | MRS16000C3309FCT00 | 56-MRS16000C3309FCT00CT-ND | Resistor_THT:R_Axial_DIN0207_L6.3mm_D2.5mm_P7.62mm_Horizontal | THT | Top |  |  | Factory component price unquoted; historical price is a reference only | 0.22 | 0.22 | 2026-10-31 | https://www.digikey.com/en/products/detail/vishay-beyschlag-draloric-bc-components/MRS16000C3309FCT00/5063865 | https://www.vishay.com/docs/28724/mrs16m25.pdf | 1%,0.4W,50ppm/K. Smaller body than existing DIN0207 outline; P7.62 exceeds specified Mmin5.0. Primary does not state lead diameter maximum, so do not claim fully bounded lead tolerance. Cut tape only; groups>=10 priced at quantity10 break. Exact values unchanged. No unapproved substitutions. L3.6 MAX x D1.6 MAX mm; lead0.50 nominal; manufacturer Mmin5.0mm; form horizontal to PCB P7.62mm | Final supplier sourcing/price and physical assembly/functional tests pending. | assembly/BOM-PCBWay-panel.csv; group 7; reports/panel-netlist.xml
44 | Fitted component | Panel | R33 | 33 | 33 | 1 | piece | Panel assembly: new component supply | Vishay | MRS16000C3309FCT00 | 56-MRS16000C3309FCT00CT-ND | Resistor_THT:R_Axial_DIN0207_L6.3mm_D2.5mm_P7.62mm_Horizontal | THT | Top |  |  | Factory component price unquoted; historical price is a reference only | 0.22 | 0.22 | 2026-10-31 | https://www.digikey.com/en/products/detail/vishay-beyschlag-draloric-bc-components/MRS16000C3309FCT00/5063865 | https://www.vishay.com/docs/28724/mrs16m25.pdf | 1%,0.4W,50ppm/K. Smaller body than existing DIN0207 outline; P7.62 exceeds specified Mmin5.0. Primary does not state lead diameter maximum, so do not claim fully bounded lead tolerance. Cut tape only; groups>=10 priced at quantity10 break. Exact values unchanged. No unapproved substitutions. L3.6 MAX x D1.6 MAX mm; lead0.50 nominal; manufacturer Mmin5.0mm; form horizontal to PCB P7.62mm | Final supplier sourcing/price and physical assembly/functional tests pending. | assembly/BOM-PCBWay-panel.csv; group 7; reports/panel-netlist.xml
45 | Fitted component | Panel | R34 | 33 | 33 | 1 | piece | Panel assembly: new component supply | Vishay | MRS16000C3309FCT00 | 56-MRS16000C3309FCT00CT-ND | Resistor_THT:R_Axial_DIN0207_L6.3mm_D2.5mm_P7.62mm_Horizontal | THT | Top |  |  | Factory component price unquoted; historical price is a reference only | 0.22 | 0.22 | 2026-10-31 | https://www.digikey.com/en/products/detail/vishay-beyschlag-draloric-bc-components/MRS16000C3309FCT00/5063865 | https://www.vishay.com/docs/28724/mrs16m25.pdf | 1%,0.4W,50ppm/K. Smaller body than existing DIN0207 outline; P7.62 exceeds specified Mmin5.0. Primary does not state lead diameter maximum, so do not claim fully bounded lead tolerance. Cut tape only; groups>=10 priced at quantity10 break. Exact values unchanged. No unapproved substitutions. L3.6 MAX x D1.6 MAX mm; lead0.50 nominal; manufacturer Mmin5.0mm; form horizontal to PCB P7.62mm | Final supplier sourcing/price and physical assembly/functional tests pending. | assembly/BOM-PCBWay-panel.csv; group 7; reports/panel-netlist.xml
46 | Fitted component | Panel | R63 | 33 | 33 | 1 | piece | Panel assembly: new component supply | Vishay | MRS16000C3309FCT00 | 56-MRS16000C3309FCT00CT-ND | Resistor_THT:R_Axial_DIN0207_L6.3mm_D2.5mm_P7.62mm_Horizontal | THT | Top |  |  | Factory component price unquoted; historical price is a reference only | 0.22 | 0.22 | 2026-10-31 | https://www.digikey.com/en/products/detail/vishay-beyschlag-draloric-bc-components/MRS16000C3309FCT00/5063865 | https://www.vishay.com/docs/28724/mrs16m25.pdf | 1%,0.4W,50ppm/K. Smaller body than existing DIN0207 outline; P7.62 exceeds specified Mmin5.0. Primary does not state lead diameter maximum, so do not claim fully bounded lead tolerance. Cut tape only; groups>=10 priced at quantity10 break. Exact values unchanged. No unapproved substitutions. L3.6 MAX x D1.6 MAX mm; lead0.50 nominal; manufacturer Mmin5.0mm; form horizontal to PCB P7.62mm | Final supplier sourcing/price and physical assembly/functional tests pending. | assembly/BOM-PCBWay-panel.csv; group 7; reports/panel-netlist.xml
47 | Fitted component | Panel | R27 | 2.2k | 2.2k | 1 | piece | Panel assembly: new component supply | Vishay | MRS16000C2201FCT00 | BC3931CT-ND | Resistor_THT:R_Axial_DIN0207_L6.3mm_D2.5mm_P7.62mm_Horizontal | THT | Top |  |  | Factory component price unquoted; historical price is a reference only | 0.22 | 0.22 | 2026-10-31 | https://www.digikey.com/en/products/detail/vishay-beyschlag-draloric-bc-components/MRS16000C2201FCT00/5063816 | https://www.vishay.com/docs/28724/mrs16m25.pdf | 1%,0.4W,50ppm/K. Smaller body than existing DIN0207 outline; P7.62 exceeds specified Mmin5.0. Primary does not state lead diameter maximum, so do not claim fully bounded lead tolerance. Cut tape only; groups>=10 priced at quantity10 break. Exact values unchanged. No unapproved substitutions. L3.6 MAX x D1.6 MAX mm; lead0.50 nominal; manufacturer Mmin5.0mm; form horizontal to PCB P7.62mm | Final supplier sourcing/price and physical assembly/functional tests pending. | assembly/BOM-PCBWay-panel.csv; group 8; reports/panel-netlist.xml
48 | Fitted component | Panel | R28 | 2.2k | 2.2k | 1 | piece | Panel assembly: new component supply | Vishay | MRS16000C2201FCT00 | BC3931CT-ND | Resistor_THT:R_Axial_DIN0207_L6.3mm_D2.5mm_P7.62mm_Horizontal | THT | Top |  |  | Factory component price unquoted; historical price is a reference only | 0.22 | 0.22 | 2026-10-31 | https://www.digikey.com/en/products/detail/vishay-beyschlag-draloric-bc-components/MRS16000C2201FCT00/5063816 | https://www.vishay.com/docs/28724/mrs16m25.pdf | 1%,0.4W,50ppm/K. Smaller body than existing DIN0207 outline; P7.62 exceeds specified Mmin5.0. Primary does not state lead diameter maximum, so do not claim fully bounded lead tolerance. Cut tape only; groups>=10 priced at quantity10 break. Exact values unchanged. No unapproved substitutions. L3.6 MAX x D1.6 MAX mm; lead0.50 nominal; manufacturer Mmin5.0mm; form horizontal to PCB P7.62mm | Final supplier sourcing/price and physical assembly/functional tests pending. | assembly/BOM-PCBWay-panel.csv; group 8; reports/panel-netlist.xml
49 | Fitted component | Panel | R62 | 2.2k | 2.2k | 1 | piece | Panel assembly: new component supply | Vishay | MRS16000C2201FCT00 | BC3931CT-ND | Resistor_THT:R_Axial_DIN0207_L6.3mm_D2.5mm_P7.62mm_Horizontal | THT | Top |  |  | Factory component price unquoted; historical price is a reference only | 0.22 | 0.22 | 2026-10-31 | https://www.digikey.com/en/products/detail/vishay-beyschlag-draloric-bc-components/MRS16000C2201FCT00/5063816 | https://www.vishay.com/docs/28724/mrs16m25.pdf | 1%,0.4W,50ppm/K. Smaller body than existing DIN0207 outline; P7.62 exceeds specified Mmin5.0. Primary does not state lead diameter maximum, so do not claim fully bounded lead tolerance. Cut tape only; groups>=10 priced at quantity10 break. Exact values unchanged. No unapproved substitutions. L3.6 MAX x D1.6 MAX mm; lead0.50 nominal; manufacturer Mmin5.0mm; form horizontal to PCB P7.62mm | Final supplier sourcing/price and physical assembly/functional tests pending. | assembly/BOM-PCBWay-panel.csv; group 8; reports/panel-netlist.xml
50 | Fitted component | Panel | R59 | 330 / 1% | 330 / 1% | 1 | piece | Panel assembly: new component supply | Vishay | MRS16000C3300FCT00 | BC3933CT-ND | Resistor_THT:R_Axial_DIN0207_L6.3mm_D2.5mm_P7.62mm_Horizontal | THT | Top |  |  | Factory component price unquoted; historical price is a reference only | 0.22 | 0.22 | 2026-10-31 | https://www.digikey.com/en/products/detail/vishay-beyschlag-draloric-bc-components/MRS16000C3300FCT00/5063859 | https://www.vishay.com/docs/28724/mrs16m25.pdf | 1%,0.4W,50ppm/K. Smaller body than existing DIN0207 outline; P7.62 exceeds specified Mmin5.0. Primary does not state lead diameter maximum, so do not claim fully bounded lead tolerance. Cut tape only; groups>=10 priced at quantity10 break. Exact values unchanged. No unapproved substitutions. L3.6 MAX x D1.6 MAX mm; lead0.50 nominal; manufacturer Mmin5.0mm; form horizontal to PCB P7.62mm | Final supplier sourcing/price and physical assembly/functional tests pending. | assembly/BOM-PCBWay-panel.csv; group 9; reports/panel-netlist.xml
51 | Fitted component | Panel | R52 | 49.9k / 0.1% | 49.9k / 0.1% | 1 | piece | Panel assembly: new component supply | Vishay | CMF5549K900BEEA | CMF49.9KHLCT-ND | Resistor_THT:R_Axial_DIN0207_L6.3mm_D2.5mm_P10.16mm_Horizontal | THT | Top |  |  | Factory component price unquoted; historical price is a reference only | 1.57 | 1.57 | 2026-10-31 | https://www.digikey.com/en/products/detail/vishay-dale/CMF5549K900BEEA/3622041 | https://www.vishay.com/doc?31018= | 49.9k +/-0.1%, 25ppm/C. Vendor nominal L6.10 x D2.29 is smaller than primary max; use primary max for clearance. Rev21 7.62 mm pitch was not qualified. Final rev22 stock 10.16 mm footprint and native routing/DRC were checked; no forced lead bends are needed. No unapproved substitutions. Primary CMF55 L6.5 MAX x D2.5 MAX mm; lead0.60 nominal; manufacturer Mmin10mm; final rev22 PCB P10.16mm meets manufacturer Mmin10mm | Final supplier sourcing/price and physical assembly/functional tests pending. | assembly/BOM-PCBWay-panel.csv; group 10; reports/panel-netlist.xml
52 | Fitted component | Panel | R53 | 49.9k / 0.1% | 49.9k / 0.1% | 1 | piece | Panel assembly: new component supply | Vishay | CMF5549K900BEEA | CMF49.9KHLCT-ND | Resistor_THT:R_Axial_DIN0207_L6.3mm_D2.5mm_P10.16mm_Horizontal | THT | Top |  |  | Factory component price unquoted; historical price is a reference only | 1.57 | 1.57 | 2026-10-31 | https://www.digikey.com/en/products/detail/vishay-dale/CMF5549K900BEEA/3622041 | https://www.vishay.com/doc?31018= | 49.9k +/-0.1%, 25ppm/C. Vendor nominal L6.10 x D2.29 is smaller than primary max; use primary max for clearance. Rev21 7.62 mm pitch was not qualified. Final rev22 stock 10.16 mm footprint and native routing/DRC were checked; no forced lead bends are needed. No unapproved substitutions. Primary CMF55 L6.5 MAX x D2.5 MAX mm; lead0.60 nominal; manufacturer Mmin10mm; final rev22 PCB P10.16mm meets manufacturer Mmin10mm | Final supplier sourcing/price and physical assembly/functional tests pending. | assembly/BOM-PCBWay-panel.csv; group 10; reports/panel-netlist.xml
53 | Fitted component | Panel | R54 | 10.0k / 0.1% | 10.0k / 0.1% | 1 | piece | Panel assembly: new component supply | Vishay | CMF5510K000BEEA | CMF10.0KHLCT-ND | Resistor_THT:R_Axial_DIN0207_L6.3mm_D2.5mm_P10.16mm_Horizontal | THT | Top |  |  | Factory component price unquoted; historical price is a reference only | 1.75 | 1.75 | 2026-10-31 | https://www.digikey.com/en/products/detail/vishay-dale/CMF5510K000BEEA/3622035 | https://www.vishay.com/doc?31018= | 10.0k +/-0.1%, 25ppm/C. Use cut tape. TE H8 alternatives are longer and not approved here. Rev21 7.62 mm pitch was not qualified. Final rev22 stock 10.16 mm footprint and native routing/DRC were checked; no forced lead bends are needed. No unapproved substitutions. Primary CMF55 L6.5 MAX x D2.5 MAX mm; lead0.60 nominal; manufacturer Mmin10mm; final rev22 PCB P10.16mm meets manufacturer Mmin10mm | Final supplier sourcing/price and physical assembly/functional tests pending. | assembly/BOM-PCBWay-panel.csv; group 11; reports/panel-netlist.xml
54 | Fitted component | Panel | D1 | 3V3 POWER / PROTO POWER | 3V3 POWER | 1 | piece | Panel assembly: new component supply | Kingbright | WP3A8GD | 754-1217-ND | LED_THT:LED_D3.0mm | THT | Top |  |  | Factory component price unquoted; historical price is a reference only | 0.25 | 0.25 | 2026-10-31 | https://www.digikey.com/en/products/detail/kingbright/WP3A8GD/1747616 | https://www.kingbrightusa.com/images/catalog/SPEC/WP3A8GD.pdf | Green diffused; exact shaft MAX0.50x0.45mm diagonal0.67268; native0.90mm hole minimum0.82mm at JLCPCB -0.08 tolerance. Keep0.7MAX stamping shoulders ABOVE PCB; do not force lens flush. Brightness is not hardware-tested. Match cathode K/pad1. No unapproved substitutions. T-1 lensD3+/-0.25 mm, flangeD4+/-0.25=>4.25MAX mm, height5+/-0.25=>5.25MAX; P2.54 mm; lead(0.45+/-0.05)x(0.4+/-0.05)=>0.673MAX diagonal fits0.9nativehole | Final supplier sourcing/price and physical assembly/functional tests pending. | assembly/BOM-PCBWay-panel.csv; group 12; reports/panel-netlist.xml
55 | Fitted component | Panel | D5 | 3V3 POWER / PROTO POWER | PROTO POWER | 1 | piece | Panel assembly: new component supply | Kingbright | WP3A8GD | 754-1217-ND | LED_THT:LED_D3.0mm | THT | Top |  |  | Factory component price unquoted; historical price is a reference only | 0.25 | 0.25 | 2026-10-31 | https://www.digikey.com/en/products/detail/kingbright/WP3A8GD/1747616 | https://www.kingbrightusa.com/images/catalog/SPEC/WP3A8GD.pdf | Green diffused; exact shaft MAX0.50x0.45mm diagonal0.67268; native0.90mm hole minimum0.82mm at JLCPCB -0.08 tolerance. Keep0.7MAX stamping shoulders ABOVE PCB; do not force lens flush. Brightness is not hardware-tested. Match cathode K/pad1. No unapproved substitutions. T-1 lensD3+/-0.25 mm, flangeD4+/-0.25=>4.25MAX mm, height5+/-0.25=>5.25MAX; P2.54 mm; lead(0.45+/-0.05)x(0.4+/-0.05)=>0.673MAX diagonal fits0.9nativehole | Final supplier sourcing/price and physical assembly/functional tests pending. | assembly/BOM-PCBWay-panel.csv; group 12; reports/panel-netlist.xml
56 | Fitted component | Panel | D2 | PROTO FAULT | PROTO FAULT | 1 | piece | Panel assembly: new component supply | Kingbright | WP3A8ID | 754-1219-ND | LED_THT:LED_D3.0mm | THT | Top |  |  | Factory component price unquoted; historical price is a reference only | 0.27 | 0.27 | 2026-10-31 | https://www.digikey.com/en/products/detail/kingbright/WP3A8ID/1747618 | https://www.kingbrightusa.com/images/catalog/SPEC/WP3A8ID.pdf | Red diffused. This exact current RED drawing differs from the older GREEN drawing: do not reuse green lead tolerances. Native D2 has an intentional local stock-footprint drill override. Manufacturer recommends0.9mm but that does not cover simultaneous rectangular maxima plus negative hole tolerance. Keep stamping shoulders abovePCB; match cathode K/pad1. Final native hash/DRC must include D2 correction. No unapproved substitutions. CURRENT Rev5A2026-02-26: leadwidth0.45+0.25/-0.10=>0.70MAX; thickness0.40+0.25/-0.10=>0.65MAX; rectangular diagonal0.95525mm. Root correction requires BOTH D2 drills1.10mm, finishedminimum1.02mm at JLCPCB -0.08 tolerance, margin0.06475mm. P2.54mm; lensD3+/-0.25/flangeD4+/-0.25/height5+/-0.25mm | Final supplier sourcing/price and physical assembly/functional tests pending. | assembly/BOM-PCBWay-panel.csv; group 13; reports/panel-netlist.xml
57 | Fitted component | Panel | D3 | BAT85 | BAT85 | 1 | piece | Panel assembly: new component supply | Vishay | BAT85S-TAP | BAT85S-TAPCT-ND | Diode_THT:D_DO-35_SOD27_P7.62mm_Horizontal | THT | Top |  |  | Factory component price unquoted; historical price is a reference only | 0.5 | 0.5 | 2026-10-31 | https://www.digikey.com/en/products/detail/vishay-general-semiconductor-diodes-division/BAT85S-TAP/3104127 | https://www.vishay.com/docs/85513/bat85s.pdf | BAT85 family single Schottky, 30V. Not BAT54 in SOT23. Reverse leakage is not zero; accuracy remains subject to calibration/temperature testing. No unapproved substitutions. DO-35 / DO-204AH; bodyL3.9MAX x D1.7MAX; leadD0.6MAX fits0.8nativehole; P7.62mm axial forming | Final supplier sourcing/price and physical assembly/functional tests pending. | assembly/BOM-PCBWay-panel.csv; group 14; reports/panel-netlist.xml
58 | Fitted component | Panel | D4 | BAT85 | BAT85 | 1 | piece | Panel assembly: new component supply | Vishay | BAT85S-TAP | BAT85S-TAPCT-ND | Diode_THT:D_DO-35_SOD27_P7.62mm_Horizontal | THT | Top |  |  | Factory component price unquoted; historical price is a reference only | 0.5 | 0.5 | 2026-10-31 | https://www.digikey.com/en/products/detail/vishay-general-semiconductor-diodes-division/BAT85S-TAP/3104127 | https://www.vishay.com/docs/85513/bat85s.pdf | BAT85 family single Schottky, 30V. Not BAT54 in SOT23. Reverse leakage is not zero; accuracy remains subject to calibration/temperature testing. No unapproved substitutions. DO-35 / DO-204AH; bodyL3.9MAX x D1.7MAX; leadD0.6MAX fits0.8nativehole; P7.62mm axial forming | Final supplier sourcing/price and physical assembly/functional tests pending. | assembly/BOM-PCBWay-panel.csv; group 14; reports/panel-netlist.xml
59 | Fitted component | Panel | F1 | MF-RHT050-0 / 500mA HOLD | MF-RHT050-0 / 500mA HOLD | 1 | piece | Panel assembly: new component supply | Bourns | MF-RHT050-0 | MF-RHT050-0-ND | Fuse:Fuse_Bourns_MF-RHT050 | THT | Top |  |  | Factory component price unquoted; historical price is a reference only | 0.89 | 0.89 | 2026-10-31 | https://www.digikey.com/en/products/detail/bourns-inc/MF-RHT050-0/6229412 | https://www.bourns.com/docs/product-datasheets/mf-rht.pdf | 500mA HOLD at23C only; at50C hold0.40A, at70C0.34A. Rinitial>=0.48ohm and posttrip<=1.10ohm. A PTC is slow and cannot guarantee no Pi reset on a short. No unapproved substitutions. A7.40 MAX, B12.7 MAX, T3.0 MAX mm; pitch5.1 +/-0.7 mm, lead0.51 nominal | Final supplier sourcing/price and physical assembly/functional tests pending. | assembly/BOM-PCBWay-panel.csv; group 15; reports/panel-netlist.xml
60 | Fitted component | Panel | SW1 | F1 / F10 / F2 / F3 / F4 / F5 / F6 / F7 / F8 / F9 / HOLD REQUEST / I/O RESET ONLY | F1 | 1 | piece | Panel assembly: new component supply | Omron | B3F-1000 | SW400-ND | Button_Switch_THT:SW_TH_Tactile_Omron_B3F-100x | THT | Top |  |  | Factory component price unquoted; historical price is a reference only | 0.299 | 0.299 | 2026-10-31 | https://www.digikey.com/en/products/detail/omron-electronics-inc-emc-div/B3F-1000/33150 | https://omronfs.omron.com/en_US/ecb/products/pdf/en-b3f.pdf | Tactile momentary. These are NOT latching emergency-stop switches. Do not buy side-actuated, 12mm or other pin-grid variants. No unapproved substitutions. Body6.0 +/-0.2 square mm; height4.3 +/-0.2 mm; PCB holegrid6.5 x4.5 mm, 1mm recommended hole | Final supplier sourcing/price and physical assembly/functional tests pending. | assembly/BOM-PCBWay-panel.csv; group 16; reports/panel-netlist.xml
61 | Fitted component | Panel | SW2 | F1 / F10 / F2 / F3 / F4 / F5 / F6 / F7 / F8 / F9 / HOLD REQUEST / I/O RESET ONLY | F2 | 1 | piece | Panel assembly: new component supply | Omron | B3F-1000 | SW400-ND | Button_Switch_THT:SW_TH_Tactile_Omron_B3F-100x | THT | Top |  |  | Factory component price unquoted; historical price is a reference only | 0.299 | 0.299 | 2026-10-31 | https://www.digikey.com/en/products/detail/omron-electronics-inc-emc-div/B3F-1000/33150 | https://omronfs.omron.com/en_US/ecb/products/pdf/en-b3f.pdf | Tactile momentary. These are NOT latching emergency-stop switches. Do not buy side-actuated, 12mm or other pin-grid variants. No unapproved substitutions. Body6.0 +/-0.2 square mm; height4.3 +/-0.2 mm; PCB holegrid6.5 x4.5 mm, 1mm recommended hole | Final supplier sourcing/price and physical assembly/functional tests pending. | assembly/BOM-PCBWay-panel.csv; group 16; reports/panel-netlist.xml
62 | Fitted component | Panel | SW3 | F1 / F10 / F2 / F3 / F4 / F5 / F6 / F7 / F8 / F9 / HOLD REQUEST / I/O RESET ONLY | F3 | 1 | piece | Panel assembly: new component supply | Omron | B3F-1000 | SW400-ND | Button_Switch_THT:SW_TH_Tactile_Omron_B3F-100x | THT | Top |  |  | Factory component price unquoted; historical price is a reference only | 0.299 | 0.299 | 2026-10-31 | https://www.digikey.com/en/products/detail/omron-electronics-inc-emc-div/B3F-1000/33150 | https://omronfs.omron.com/en_US/ecb/products/pdf/en-b3f.pdf | Tactile momentary. These are NOT latching emergency-stop switches. Do not buy side-actuated, 12mm or other pin-grid variants. No unapproved substitutions. Body6.0 +/-0.2 square mm; height4.3 +/-0.2 mm; PCB holegrid6.5 x4.5 mm, 1mm recommended hole | Final supplier sourcing/price and physical assembly/functional tests pending. | assembly/BOM-PCBWay-panel.csv; group 16; reports/panel-netlist.xml
63 | Fitted component | Panel | SW4 | F1 / F10 / F2 / F3 / F4 / F5 / F6 / F7 / F8 / F9 / HOLD REQUEST / I/O RESET ONLY | F4 | 1 | piece | Panel assembly: new component supply | Omron | B3F-1000 | SW400-ND | Button_Switch_THT:SW_TH_Tactile_Omron_B3F-100x | THT | Top |  |  | Factory component price unquoted; historical price is a reference only | 0.299 | 0.299 | 2026-10-31 | https://www.digikey.com/en/products/detail/omron-electronics-inc-emc-div/B3F-1000/33150 | https://omronfs.omron.com/en_US/ecb/products/pdf/en-b3f.pdf | Tactile momentary. These are NOT latching emergency-stop switches. Do not buy side-actuated, 12mm or other pin-grid variants. No unapproved substitutions. Body6.0 +/-0.2 square mm; height4.3 +/-0.2 mm; PCB holegrid6.5 x4.5 mm, 1mm recommended hole | Final supplier sourcing/price and physical assembly/functional tests pending. | assembly/BOM-PCBWay-panel.csv; group 16; reports/panel-netlist.xml
64 | Fitted component | Panel | SW5 | F1 / F10 / F2 / F3 / F4 / F5 / F6 / F7 / F8 / F9 / HOLD REQUEST / I/O RESET ONLY | F5 | 1 | piece | Panel assembly: new component supply | Omron | B3F-1000 | SW400-ND | Button_Switch_THT:SW_TH_Tactile_Omron_B3F-100x | THT | Top |  |  | Factory component price unquoted; historical price is a reference only | 0.299 | 0.299 | 2026-10-31 | https://www.digikey.com/en/products/detail/omron-electronics-inc-emc-div/B3F-1000/33150 | https://omronfs.omron.com/en_US/ecb/products/pdf/en-b3f.pdf | Tactile momentary. These are NOT latching emergency-stop switches. Do not buy side-actuated, 12mm or other pin-grid variants. No unapproved substitutions. Body6.0 +/-0.2 square mm; height4.3 +/-0.2 mm; PCB holegrid6.5 x4.5 mm, 1mm recommended hole | Final supplier sourcing/price and physical assembly/functional tests pending. | assembly/BOM-PCBWay-panel.csv; group 16; reports/panel-netlist.xml
65 | Fitted component | Panel | SW6 | F1 / F10 / F2 / F3 / F4 / F5 / F6 / F7 / F8 / F9 / HOLD REQUEST / I/O RESET ONLY | F6 | 1 | piece | Panel assembly: new component supply | Omron | B3F-1000 | SW400-ND | Button_Switch_THT:SW_TH_Tactile_Omron_B3F-100x | THT | Top |  |  | Factory component price unquoted; historical price is a reference only | 0.299 | 0.299 | 2026-10-31 | https://www.digikey.com/en/products/detail/omron-electronics-inc-emc-div/B3F-1000/33150 | https://omronfs.omron.com/en_US/ecb/products/pdf/en-b3f.pdf | Tactile momentary. These are NOT latching emergency-stop switches. Do not buy side-actuated, 12mm or other pin-grid variants. No unapproved substitutions. Body6.0 +/-0.2 square mm; height4.3 +/-0.2 mm; PCB holegrid6.5 x4.5 mm, 1mm recommended hole | Final supplier sourcing/price and physical assembly/functional tests pending. | assembly/BOM-PCBWay-panel.csv; group 16; reports/panel-netlist.xml
66 | Fitted component | Panel | SW7 | F1 / F10 / F2 / F3 / F4 / F5 / F6 / F7 / F8 / F9 / HOLD REQUEST / I/O RESET ONLY | F7 | 1 | piece | Panel assembly: new component supply | Omron | B3F-1000 | SW400-ND | Button_Switch_THT:SW_TH_Tactile_Omron_B3F-100x | THT | Top |  |  | Factory component price unquoted; historical price is a reference only | 0.299 | 0.299 | 2026-10-31 | https://www.digikey.com/en/products/detail/omron-electronics-inc-emc-div/B3F-1000/33150 | https://omronfs.omron.com/en_US/ecb/products/pdf/en-b3f.pdf | Tactile momentary. These are NOT latching emergency-stop switches. Do not buy side-actuated, 12mm or other pin-grid variants. No unapproved substitutions. Body6.0 +/-0.2 square mm; height4.3 +/-0.2 mm; PCB holegrid6.5 x4.5 mm, 1mm recommended hole | Final supplier sourcing/price and physical assembly/functional tests pending. | assembly/BOM-PCBWay-panel.csv; group 16; reports/panel-netlist.xml
67 | Fitted component | Panel | SW8 | F1 / F10 / F2 / F3 / F4 / F5 / F6 / F7 / F8 / F9 / HOLD REQUEST / I/O RESET ONLY | HOLD REQUEST | 1 | piece | Panel assembly: new component supply | Omron | B3F-1000 | SW400-ND | Button_Switch_THT:SW_TH_Tactile_Omron_B3F-100x | THT | Top |  |  | Factory component price unquoted; historical price is a reference only | 0.299 | 0.299 | 2026-10-31 | https://www.digikey.com/en/products/detail/omron-electronics-inc-emc-div/B3F-1000/33150 | https://omronfs.omron.com/en_US/ecb/products/pdf/en-b3f.pdf | Tactile momentary. These are NOT latching emergency-stop switches. Do not buy side-actuated, 12mm or other pin-grid variants. No unapproved substitutions. Body6.0 +/-0.2 square mm; height4.3 +/-0.2 mm; PCB holegrid6.5 x4.5 mm, 1mm recommended hole | Final supplier sourcing/price and physical assembly/functional tests pending. | assembly/BOM-PCBWay-panel.csv; group 16; reports/panel-netlist.xml
68 | Fitted component | Panel | SW9 | F1 / F10 / F2 / F3 / F4 / F5 / F6 / F7 / F8 / F9 / HOLD REQUEST / I/O RESET ONLY | I/O RESET ONLY | 1 | piece | Panel assembly: new component supply | Omron | B3F-1000 | SW400-ND | Button_Switch_THT:SW_TH_Tactile_Omron_B3F-100x | THT | Top |  |  | Factory component price unquoted; historical price is a reference only | 0.299 | 0.299 | 2026-10-31 | https://www.digikey.com/en/products/detail/omron-electronics-inc-emc-div/B3F-1000/33150 | https://omronfs.omron.com/en_US/ecb/products/pdf/en-b3f.pdf | Tactile momentary. These are NOT latching emergency-stop switches. Do not buy side-actuated, 12mm or other pin-grid variants. No unapproved substitutions. Body6.0 +/-0.2 square mm; height4.3 +/-0.2 mm; PCB holegrid6.5 x4.5 mm, 1mm recommended hole | Final supplier sourcing/price and physical assembly/functional tests pending. | assembly/BOM-PCBWay-panel.csv; group 16; reports/panel-netlist.xml
69 | Fitted component | Panel | SW10 | F1 / F10 / F2 / F3 / F4 / F5 / F6 / F7 / F8 / F9 / HOLD REQUEST / I/O RESET ONLY | F8 | 1 | piece | Panel assembly: new component supply | Omron | B3F-1000 | SW400-ND | Button_Switch_THT:SW_TH_Tactile_Omron_B3F-100x | THT | Top |  |  | Factory component price unquoted; historical price is a reference only | 0.299 | 0.299 | 2026-10-31 | https://www.digikey.com/en/products/detail/omron-electronics-inc-emc-div/B3F-1000/33150 | https://omronfs.omron.com/en_US/ecb/products/pdf/en-b3f.pdf | Tactile momentary. These are NOT latching emergency-stop switches. Do not buy side-actuated, 12mm or other pin-grid variants. No unapproved substitutions. Body6.0 +/-0.2 square mm; height4.3 +/-0.2 mm; PCB holegrid6.5 x4.5 mm, 1mm recommended hole | Final supplier sourcing/price and physical assembly/functional tests pending. | assembly/BOM-PCBWay-panel.csv; group 16; reports/panel-netlist.xml
70 | Fitted component | Panel | SW11 | F1 / F10 / F2 / F3 / F4 / F5 / F6 / F7 / F8 / F9 / HOLD REQUEST / I/O RESET ONLY | F9 | 1 | piece | Panel assembly: new component supply | Omron | B3F-1000 | SW400-ND | Button_Switch_THT:SW_TH_Tactile_Omron_B3F-100x | THT | Top |  |  | Factory component price unquoted; historical price is a reference only | 0.299 | 0.299 | 2026-10-31 | https://www.digikey.com/en/products/detail/omron-electronics-inc-emc-div/B3F-1000/33150 | https://omronfs.omron.com/en_US/ecb/products/pdf/en-b3f.pdf | Tactile momentary. These are NOT latching emergency-stop switches. Do not buy side-actuated, 12mm or other pin-grid variants. No unapproved substitutions. Body6.0 +/-0.2 square mm; height4.3 +/-0.2 mm; PCB holegrid6.5 x4.5 mm, 1mm recommended hole | Final supplier sourcing/price and physical assembly/functional tests pending. | assembly/BOM-PCBWay-panel.csv; group 16; reports/panel-netlist.xml
71 | Fitted component | Panel | SW12 | F1 / F10 / F2 / F3 / F4 / F5 / F6 / F7 / F8 / F9 / HOLD REQUEST / I/O RESET ONLY | F10 | 1 | piece | Panel assembly: new component supply | Omron | B3F-1000 | SW400-ND | Button_Switch_THT:SW_TH_Tactile_Omron_B3F-100x | THT | Top |  |  | Factory component price unquoted; historical price is a reference only | 0.299 | 0.299 | 2026-10-31 | https://www.digikey.com/en/products/detail/omron-electronics-inc-emc-div/B3F-1000/33150 | https://omronfs.omron.com/en_US/ecb/products/pdf/en-b3f.pdf | Tactile momentary. These are NOT latching emergency-stop switches. Do not buy side-actuated, 12mm or other pin-grid variants. No unapproved substitutions. Body6.0 +/-0.2 square mm; height4.3 +/-0.2 mm; PCB holegrid6.5 x4.5 mm, 1mm recommended hole | Final supplier sourcing/price and physical assembly/functional tests pending. | assembly/BOM-PCBWay-panel.csv; group 16; reports/panel-netlist.xml
72 | Fitted component | Panel | SW13 | METER ENABLE / PROTO 5V OFF / ON (100mA) | METER ENABLE | 1 | piece | Panel assembly: new component supply | C&K | JS202011CQN | 401-2001-ND | Button_Switch_THT:SW_CK_JS202011CQN_DPDT_Straight | THT | Top |  |  | Factory component price unquoted; historical price is a reference only | 0.84 | 0.84 | 2026-10-31 | https://www.digikey.com/en/products/detail/c-k/JS202011CQN/1640097 | https://www.littelfuse.com/assetdocs/littelfuse-c-k-slide-js-series-datasheet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 | DPDT through-hole. SW13 selects meter input disconnect/enable; SW14 drives TPS2553-1 EN only and provides manual OFF/ON fault reset. Old relay-coil description is superseded. No unapproved substitutions. Straight THT DPDT; pitch2.5mm columns x3.3mm rows, 6 holes0.9mm; body9x3.6mm | Final supplier sourcing/price and physical assembly/functional tests pending. | assembly/BOM-PCBWay-panel.csv; group 17; reports/panel-netlist.xml
73 | Fitted component | Panel | SW14 | METER ENABLE / PROTO 5V OFF / ON (100mA) | PROTO 5V OFF / ON (100mA) | 1 | piece | Panel assembly: new component supply | C&K | JS202011CQN | 401-2001-ND | Button_Switch_THT:SW_CK_JS202011CQN_DPDT_Straight | THT | Top |  |  | Factory component price unquoted; historical price is a reference only | 0.84 | 0.84 | 2026-10-31 | https://www.digikey.com/en/products/detail/c-k/JS202011CQN/1640097 | https://www.littelfuse.com/assetdocs/littelfuse-c-k-slide-js-series-datasheet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 | DPDT through-hole. SW13 selects meter input disconnect/enable; SW14 drives TPS2553-1 EN only and provides manual OFF/ON fault reset. Old relay-coil description is superseded. No unapproved substitutions. Straight THT DPDT; pitch2.5mm columns x3.3mm rows, 6 holes0.9mm; body9x3.6mm | Final supplier sourcing/price and physical assembly/functional tests pending. | assembly/BOM-PCBWay-panel.csv; group 17; reports/panel-netlist.xml
74 | Fitted component | Panel | K1 | AQY212EH / INPUT DISCONNECT | AQY212EH / INPUT DISCONNECT | 1 | piece | Panel assembly: new component supply | Panasonic | AQY212EH | 255-2963-ND | Package_DIP:DIP-4_W7.62mm | THT | Top |  |  | Factory component price unquoted; historical price is a reference only | 1.84 | 1.84 | 2026-10-31 | https://www.digikey.com/en/products/detail/panasonic-industry/AQY212EH/512405 | https://mediap.industry.panasonic.eu/assets/imported/industrial.panasonic.com/ac/cdn/e/control/relay/photomos/catalog/semi_eng_ge1a_aqy21_e.pdf | Order EH through-hole, not EHA surface mount. Stock symbol says AQY280EH but actual selected device is AQY212EH. 2026 manufacturer outline PDFpage7/printed6 visually checked; final board clearance must use maximum body dimensions. No unapproved substitutions. DIP4 P2.54mm x7.62mm rows; bodyL6.4+0.3/-0.1=>6.7MAX,W4.78+0.3/-0.1=>5.08MAX,H3.2+/-0.2=>3.4MAX mm; lead0.47x0.20 nominal withgeneral+/-0.1=>0.644MAX diagonal; manufacturerrecommended0.8mm holes | Final supplier sourcing/price and physical assembly/functional tests pending. | assembly/BOM-PCBWay-panel.csv; group 18; reports/panel-netlist.xml
75 | Fitted component | Panel | U1 | MCP23017-E/SP / 0x20 | MCP23017-E/SP / 0x20 | 1 | piece | Panel assembly: new component supply | Microchip | MCP23017-E/SP | MCP23017-E/SP-ND | Package_DIP:DIP-28_W7.62mm | THT | Top |  |  | Factory component price unquoted; historical price is a reference only | 1.69 | 1.69 | 2026-10-31 | https://www.digikey.com/en/products/detail/microchip-technology/MCP23017-E-SP/894272 | https://ww1.microchip.com/downloads/aemDocuments/documents/APID/ProductDocuments/DataSheets/MCP23017-Data-Sheet-DS20001952.pdf | Current DS20001952D: GPA7/GPB7 are output-only and NC in corrected panel. Firmware must use IODIRA/B0x7F and zero output latches. LCD_VIO_PRESENT/BB_FAULT are direct ESP GPIO6/7 through panelJ12/revisedHATJ4, not expander inputs. Exact SP28package/pin1 required; physical assembly/test remains pending. No unapproved substitutions. SPDIP28P2.54mm/W7.62mm;maxbodyL35.56/W7.493mm plus0.254mmflashperend=>36.068x8.001MAXenvelope;maxheight5.08mm;lowerlead0.5588x0.381MAX,diagonal0.6762fits0.8hole;formrowsgentlyto7.62. NOTMCP23S17SPI | Final supplier sourcing/price and physical assembly/functional tests pending. | assembly/BOM-PCBWay-panel.csv; group 19; reports/panel-netlist.xml
76 | Fitted component | Panel | U2 | MCP3202-BI/P | MCP3202-BI/P | 1 | piece | Panel assembly: new component supply | Microchip | MCP3202-BI/P | MCP3202-BI/P-ND | Package_DIP:DIP-8_W7.62mm | THT | Top |  |  | Factory component price unquoted; historical price is a reference only | 4.12 | 4.12 | 2026-10-31 | https://www.digikey.com/en/products/detail/microchip-technology/MCP3202-BI-P/319431 | https://ww1.microchip.com/downloads/en/DeviceDoc/21034F.pdf | Match exact suffix/package and pin1. U4 pin1GND/pin2VOUT/pin3VIN; mount per actual component markings, not generic transistor pinout. IC socket procurement/added height is optional and excluded. No unapproved substitutions. PDIP8P2.54mm/W7.62mm;maxbodyL10.16/W7.112mm plus0.254flashperend=>10.668x7.620MAXenvelope;maxheight5.334mm;lowerlead0.5588x0.381MAX,diagonal0.6762fits0.8hole;formrowsgentlyto7.62;Bgrade | Final supplier sourcing/price and physical assembly/functional tests pending. | assembly/BOM-PCBWay-panel.csv; group 20; reports/panel-netlist.xml
77 | Fitted component | Panel | U3 | MCP6002-I/P | MCP6002-I/P | 1 | piece | Panel assembly: new component supply | Microchip | MCP6002-I/P | MCP6002-I/P-ND | Package_DIP:DIP-8_W7.62mm | THT | Top |  |  | Factory component price unquoted; historical price is a reference only | 0.45 | 0.45 | 2026-10-31 | https://www.digikey.com/en/products/detail/microchip-technology/MCP6002-I-P/500875 | https://ww1.microchip.com/downloads/en/DeviceDoc/MCP6001-1R-1U-2-4-1-MHz-Low-Power-Op-Amp-DS20001733L.pdf | Match exact suffix/package and pin1. U4 pin1GND/pin2VOUT/pin3VIN; mount per actual component markings, not generic transistor pinout. IC socket procurement/added height is optional and excluded. No unapproved substitutions. PDIP8P2.54mm/W7.62mm;maxbodyL10.16/W7.112mm plus0.254flashperend=>10.668x7.620MAXenvelope;maxheight5.334mm;lowerlead0.5588x0.381MAX,diagonal0.6762fits0.8hole;formrowsgentlyto7.62 | Final supplier sourcing/price and physical assembly/functional tests pending. | assembly/BOM-PCBWay-panel.csv; group 21; reports/panel-netlist.xml
78 | Fitted component | Panel | U4 | MCP1525-I/TO | MCP1525-I/TO | 1 | piece | Panel assembly: new component supply | Microchip | MCP1525-I/TO | MCP1525-I/TO-ND | Package_TO_SOT_THT:TO-92_Inline_Wide | THT | Top |  |  | Factory component price unquoted; historical price is a reference only | 1.15 | 1.15 | 2026-10-31 | https://www.digikey.com/en/products/detail/microchip-technology/MCP1525-I-TO/443708 | https://ww1.microchip.com/downloads/en/DeviceDoc/21653C.pdf | Match exact suffix/package and pin1. U4 pin1GND/pin2VOUT/pin3VIN; mount per actual component markings, not generic transistor pinout. IC socket procurement/added height is optional and excluded. No unapproved substitutions. TO92: bodywidth/height4.95MAX excluding0.254flashperside=>5.458MAX; depth3.94MAX; lead0.56x0.51MAX diagonal0.758mm fitsnative1.0drill; originalpitch1.27formedto2.54mm; heightrequiresleadformingstandoff | Final supplier sourcing/price and physical assembly/functional tests pending. | assembly/BOM-PCBWay-panel.csv; group 22; reports/panel-netlist.xml
79 | Fitted component | Panel | R1 | 10k | 10k | 1 | piece | Panel assembly: new component supply | Yageo | MFR-12FRF52-10K | 13-MFR-12FRF52-10KCT-ND | Resistor_THT:R_Axial_DIN0207_L6.3mm_D2.5mm_P7.62mm_Horizontal | THT | Top |  |  | Factory component price unquoted; historical price is a reference only | 0.038 | 0.038 | 2026-10-31 | https://www.digikey.com/en/products/detail/yageo/MFR-12FRF52-10K/9133128 | https://yageogroup.com/content/Resource%20Library/Datasheet/YAGEO-MFR_DATASHEET.pdf | 1%,1/6W,100ppm/K; replaces MRS16 only at ordinary logic resistors, never precision R52–R54. At5.25V the1k dissipation27.6mW is below1/6W. Final placement envelopes must use MFR12 maximum, not the smaller old MRS16 body. No unapproved substitutions. MAX body L3.7xD2.1mm; MAX leadD0.50mm; straight FRF52 cut-tape leads manually formed to native7.62mm pitch. Do not buy preformed M-type6mm pitch. | Final supplier sourcing/price and physical assembly/functional tests pending. | assembly/BOM-PCBWay-panel.csv; group 23; reports/panel-netlist.xml
80 | Fitted component | Panel | R2 | 10k | 10k | 1 | piece | Panel assembly: new component supply | Yageo | MFR-12FRF52-10K | 13-MFR-12FRF52-10KCT-ND | Resistor_THT:R_Axial_DIN0207_L6.3mm_D2.5mm_P7.62mm_Horizontal | THT | Top |  |  | Factory component price unquoted; historical price is a reference only | 0.038 | 0.038 | 2026-10-31 | https://www.digikey.com/en/products/detail/yageo/MFR-12FRF52-10K/9133128 | https://yageogroup.com/content/Resource%20Library/Datasheet/YAGEO-MFR_DATASHEET.pdf | 1%,1/6W,100ppm/K; replaces MRS16 only at ordinary logic resistors, never precision R52–R54. At5.25V the1k dissipation27.6mW is below1/6W. Final placement envelopes must use MFR12 maximum, not the smaller old MRS16 body. No unapproved substitutions. MAX body L3.7xD2.1mm; MAX leadD0.50mm; straight FRF52 cut-tape leads manually formed to native7.62mm pitch. Do not buy preformed M-type6mm pitch. | Final supplier sourcing/price and physical assembly/functional tests pending. | assembly/BOM-PCBWay-panel.csv; group 23; reports/panel-netlist.xml
81 | Fitted component | Panel | R3 | 10k | 10k | 1 | piece | Panel assembly: new component supply | Yageo | MFR-12FRF52-10K | 13-MFR-12FRF52-10KCT-ND | Resistor_THT:R_Axial_DIN0207_L6.3mm_D2.5mm_P7.62mm_Horizontal | THT | Top |  |  | Factory component price unquoted; historical price is a reference only | 0.038 | 0.038 | 2026-10-31 | https://www.digikey.com/en/products/detail/yageo/MFR-12FRF52-10K/9133128 | https://yageogroup.com/content/Resource%20Library/Datasheet/YAGEO-MFR_DATASHEET.pdf | 1%,1/6W,100ppm/K; replaces MRS16 only at ordinary logic resistors, never precision R52–R54. At5.25V the1k dissipation27.6mW is below1/6W. Final placement envelopes must use MFR12 maximum, not the smaller old MRS16 body. No unapproved substitutions. MAX body L3.7xD2.1mm; MAX leadD0.50mm; straight FRF52 cut-tape leads manually formed to native7.62mm pitch. Do not buy preformed M-type6mm pitch. | Final supplier sourcing/price and physical assembly/functional tests pending. | assembly/BOM-PCBWay-panel.csv; group 23; reports/panel-netlist.xml
82 | Fitted component | Panel | R4 | 10k | 10k | 1 | piece | Panel assembly: new component supply | Yageo | MFR-12FRF52-10K | 13-MFR-12FRF52-10KCT-ND | Resistor_THT:R_Axial_DIN0207_L6.3mm_D2.5mm_P7.62mm_Horizontal | THT | Top |  |  | Factory component price unquoted; historical price is a reference only | 0.038 | 0.038 | 2026-10-31 | https://www.digikey.com/en/products/detail/yageo/MFR-12FRF52-10K/9133128 | https://yageogroup.com/content/Resource%20Library/Datasheet/YAGEO-MFR_DATASHEET.pdf | 1%,1/6W,100ppm/K; replaces MRS16 only at ordinary logic resistors, never precision R52–R54. At5.25V the1k dissipation27.6mW is below1/6W. Final placement envelopes must use MFR12 maximum, not the smaller old MRS16 body. No unapproved substitutions. MAX body L3.7xD2.1mm; MAX leadD0.50mm; straight FRF52 cut-tape leads manually formed to native7.62mm pitch. Do not buy preformed M-type6mm pitch. | Final supplier sourcing/price and physical assembly/functional tests pending. | assembly/BOM-PCBWay-panel.csv; group 23; reports/panel-netlist.xml
83 | Fitted component | Panel | R5 | 10k | 10k | 1 | piece | Panel assembly: new component supply | Yageo | MFR-12FRF52-10K | 13-MFR-12FRF52-10KCT-ND | Resistor_THT:R_Axial_DIN0207_L6.3mm_D2.5mm_P7.62mm_Horizontal | THT | Top |  |  | Factory component price unquoted; historical price is a reference only | 0.038 | 0.038 | 2026-10-31 | https://www.digikey.com/en/products/detail/yageo/MFR-12FRF52-10K/9133128 | https://yageogroup.com/content/Resource%20Library/Datasheet/YAGEO-MFR_DATASHEET.pdf | 1%,1/6W,100ppm/K; replaces MRS16 only at ordinary logic resistors, never precision R52–R54. At5.25V the1k dissipation27.6mW is below1/6W. Final placement envelopes must use MFR12 maximum, not the smaller old MRS16 body. No unapproved substitutions. MAX body L3.7xD2.1mm; MAX leadD0.50mm; straight FRF52 cut-tape leads manually formed to native7.62mm pitch. Do not buy preformed M-type6mm pitch. | Final supplier sourcing/price and physical assembly/functional tests pending. | assembly/BOM-PCBWay-panel.csv; group 23; reports/panel-netlist.xml
84 | Fitted component | Panel | R6 | 10k | 10k | 1 | piece | Panel assembly: new component supply | Yageo | MFR-12FRF52-10K | 13-MFR-12FRF52-10KCT-ND | Resistor_THT:R_Axial_DIN0207_L6.3mm_D2.5mm_P7.62mm_Horizontal | THT | Top |  |  | Factory component price unquoted; historical price is a reference only | 0.038 | 0.038 | 2026-10-31 | https://www.digikey.com/en/products/detail/yageo/MFR-12FRF52-10K/9133128 | https://yageogroup.com/content/Resource%20Library/Datasheet/YAGEO-MFR_DATASHEET.pdf | 1%,1/6W,100ppm/K; replaces MRS16 only at ordinary logic resistors, never precision R52–R54. At5.25V the1k dissipation27.6mW is below1/6W. Final placement envelopes must use MFR12 maximum, not the smaller old MRS16 body. No unapproved substitutions. MAX body L3.7xD2.1mm; MAX leadD0.50mm; straight FRF52 cut-tape leads manually formed to native7.62mm pitch. Do not buy preformed M-type6mm pitch. | Final supplier sourcing/price and physical assembly/functional tests pending. | assembly/BOM-PCBWay-panel.csv; group 23; reports/panel-netlist.xml
85 | Fitted component | Panel | R7 | 10k | 10k | 1 | piece | Panel assembly: new component supply | Yageo | MFR-12FRF52-10K | 13-MFR-12FRF52-10KCT-ND | Resistor_THT:R_Axial_DIN0207_L6.3mm_D2.5mm_P7.62mm_Horizontal | THT | Top |  |  | Factory component price unquoted; historical price is a reference only | 0.038 | 0.038 | 2026-10-31 | https://www.digikey.com/en/products/detail/yageo/MFR-12FRF52-10K/9133128 | https://yageogroup.com/content/Resource%20Library/Datasheet/YAGEO-MFR_DATASHEET.pdf | 1%,1/6W,100ppm/K; replaces MRS16 only at ordinary logic resistors, never precision R52–R54. At5.25V the1k dissipation27.6mW is below1/6W. Final placement envelopes must use MFR12 maximum, not the smaller old MRS16 body. No unapproved substitutions. MAX body L3.7xD2.1mm; MAX leadD0.50mm; straight FRF52 cut-tape leads manually formed to native7.62mm pitch. Do not buy preformed M-type6mm pitch. | Final supplier sourcing/price and physical assembly/functional tests pending. | assembly/BOM-PCBWay-panel.csv; group 23; reports/panel-netlist.xml
86 | Fitted component | Panel | R8 | 10k | 10k | 1 | piece | Panel assembly: new component supply | Yageo | MFR-12FRF52-10K | 13-MFR-12FRF52-10KCT-ND | Resistor_THT:R_Axial_DIN0207_L6.3mm_D2.5mm_P7.62mm_Horizontal | THT | Top |  |  | Factory component price unquoted; historical price is a reference only | 0.038 | 0.038 | 2026-10-31 | https://www.digikey.com/en/products/detail/yageo/MFR-12FRF52-10K/9133128 | https://yageogroup.com/content/Resource%20Library/Datasheet/YAGEO-MFR_DATASHEET.pdf | 1%,1/6W,100ppm/K; replaces MRS16 only at ordinary logic resistors, never precision R52–R54. At5.25V the1k dissipation27.6mW is below1/6W. Final placement envelopes must use MFR12 maximum, not the smaller old MRS16 body. No unapproved substitutions. MAX body L3.7xD2.1mm; MAX leadD0.50mm; straight FRF52 cut-tape leads manually formed to native7.62mm pitch. Do not buy preformed M-type6mm pitch. | Final supplier sourcing/price and physical assembly/functional tests pending. | assembly/BOM-PCBWay-panel.csv; group 23; reports/panel-netlist.xml
87 | Fitted component | Panel | R17 | 10k | 10k | 1 | piece | Panel assembly: new component supply | Yageo | MFR-12FRF52-10K | 13-MFR-12FRF52-10KCT-ND | Resistor_THT:R_Axial_DIN0207_L6.3mm_D2.5mm_P7.62mm_Horizontal | THT | Top |  |  | Factory component price unquoted; historical price is a reference only | 0.038 | 0.038 | 2026-10-31 | https://www.digikey.com/en/products/detail/yageo/MFR-12FRF52-10K/9133128 | https://yageogroup.com/content/Resource%20Library/Datasheet/YAGEO-MFR_DATASHEET.pdf | 1%,1/6W,100ppm/K; replaces MRS16 only at ordinary logic resistors, never precision R52–R54. At5.25V the1k dissipation27.6mW is below1/6W. Final placement envelopes must use MFR12 maximum, not the smaller old MRS16 body. No unapproved substitutions. MAX body L3.7xD2.1mm; MAX leadD0.50mm; straight FRF52 cut-tape leads manually formed to native7.62mm pitch. Do not buy preformed M-type6mm pitch. | Final supplier sourcing/price and physical assembly/functional tests pending. | assembly/BOM-PCBWay-panel.csv; group 23; reports/panel-netlist.xml
88 | Fitted component | Panel | R18 | 10k | 10k | 1 | piece | Panel assembly: new component supply | Yageo | MFR-12FRF52-10K | 13-MFR-12FRF52-10KCT-ND | Resistor_THT:R_Axial_DIN0207_L6.3mm_D2.5mm_P7.62mm_Horizontal | THT | Top |  |  | Factory component price unquoted; historical price is a reference only | 0.038 | 0.038 | 2026-10-31 | https://www.digikey.com/en/products/detail/yageo/MFR-12FRF52-10K/9133128 | https://yageogroup.com/content/Resource%20Library/Datasheet/YAGEO-MFR_DATASHEET.pdf | 1%,1/6W,100ppm/K; replaces MRS16 only at ordinary logic resistors, never precision R52–R54. At5.25V the1k dissipation27.6mW is below1/6W. Final placement envelopes must use MFR12 maximum, not the smaller old MRS16 body. No unapproved substitutions. MAX body L3.7xD2.1mm; MAX leadD0.50mm; straight FRF52 cut-tape leads manually formed to native7.62mm pitch. Do not buy preformed M-type6mm pitch. | Final supplier sourcing/price and physical assembly/functional tests pending. | assembly/BOM-PCBWay-panel.csv; group 23; reports/panel-netlist.xml
89 | Fitted component | Panel | R31 | 10k | 10k | 1 | piece | Panel assembly: new component supply | Yageo | MFR-12FRF52-10K | 13-MFR-12FRF52-10KCT-ND | Resistor_THT:R_Axial_DIN0207_L6.3mm_D2.5mm_P7.62mm_Horizontal | THT | Top |  |  | Factory component price unquoted; historical price is a reference only | 0.038 | 0.038 | 2026-10-31 | https://www.digikey.com/en/products/detail/yageo/MFR-12FRF52-10K/9133128 | https://yageogroup.com/content/Resource%20Library/Datasheet/YAGEO-MFR_DATASHEET.pdf | 1%,1/6W,100ppm/K; replaces MRS16 only at ordinary logic resistors, never precision R52–R54. At5.25V the1k dissipation27.6mW is below1/6W. Final placement envelopes must use MFR12 maximum, not the smaller old MRS16 body. No unapproved substitutions. MAX body L3.7xD2.1mm; MAX leadD0.50mm; straight FRF52 cut-tape leads manually formed to native7.62mm pitch. Do not buy preformed M-type6mm pitch. | Final supplier sourcing/price and physical assembly/functional tests pending. | assembly/BOM-PCBWay-panel.csv; group 23; reports/panel-netlist.xml
90 | Fitted component | Panel | R40 | 10k | 10k | 1 | piece | Panel assembly: new component supply | Yageo | MFR-12FRF52-10K | 13-MFR-12FRF52-10KCT-ND | Resistor_THT:R_Axial_DIN0207_L6.3mm_D2.5mm_P7.62mm_Horizontal | THT | Top |  |  | Factory component price unquoted; historical price is a reference only | 0.038 | 0.038 | 2026-10-31 | https://www.digikey.com/en/products/detail/yageo/MFR-12FRF52-10K/9133128 | https://yageogroup.com/content/Resource%20Library/Datasheet/YAGEO-MFR_DATASHEET.pdf | 1%,1/6W,100ppm/K; replaces MRS16 only at ordinary logic resistors, never precision R52–R54. At5.25V the1k dissipation27.6mW is below1/6W. Final placement envelopes must use MFR12 maximum, not the smaller old MRS16 body. No unapproved substitutions. MAX body L3.7xD2.1mm; MAX leadD0.50mm; straight FRF52 cut-tape leads manually formed to native7.62mm pitch. Do not buy preformed M-type6mm pitch. | Final supplier sourcing/price and physical assembly/functional tests pending. | assembly/BOM-PCBWay-panel.csv; group 23; reports/panel-netlist.xml
91 | Fitted component | Panel | R41 | 10k | 10k | 1 | piece | Panel assembly: new component supply | Yageo | MFR-12FRF52-10K | 13-MFR-12FRF52-10KCT-ND | Resistor_THT:R_Axial_DIN0207_L6.3mm_D2.5mm_P7.62mm_Horizontal | THT | Top |  |  | Factory component price unquoted; historical price is a reference only | 0.038 | 0.038 | 2026-10-31 | https://www.digikey.com/en/products/detail/yageo/MFR-12FRF52-10K/9133128 | https://yageogroup.com/content/Resource%20Library/Datasheet/YAGEO-MFR_DATASHEET.pdf | 1%,1/6W,100ppm/K; replaces MRS16 only at ordinary logic resistors, never precision R52–R54. At5.25V the1k dissipation27.6mW is below1/6W. Final placement envelopes must use MFR12 maximum, not the smaller old MRS16 body. No unapproved substitutions. MAX body L3.7xD2.1mm; MAX leadD0.50mm; straight FRF52 cut-tape leads manually formed to native7.62mm pitch. Do not buy preformed M-type6mm pitch. | Final supplier sourcing/price and physical assembly/functional tests pending. | assembly/BOM-PCBWay-panel.csv; group 23; reports/panel-netlist.xml
92 | Fitted component | Panel | R46 | 10k | 10k | 1 | piece | Panel assembly: new component supply | Yageo | MFR-12FRF52-10K | 13-MFR-12FRF52-10KCT-ND | Resistor_THT:R_Axial_DIN0207_L6.3mm_D2.5mm_P7.62mm_Horizontal | THT | Top |  |  | Factory component price unquoted; historical price is a reference only | 0.038 | 0.038 | 2026-10-31 | https://www.digikey.com/en/products/detail/yageo/MFR-12FRF52-10K/9133128 | https://yageogroup.com/content/Resource%20Library/Datasheet/YAGEO-MFR_DATASHEET.pdf | 1%,1/6W,100ppm/K; replaces MRS16 only at ordinary logic resistors, never precision R52–R54. At5.25V the1k dissipation27.6mW is below1/6W. Final placement envelopes must use MFR12 maximum, not the smaller old MRS16 body. No unapproved substitutions. MAX body L3.7xD2.1mm; MAX leadD0.50mm; straight FRF52 cut-tape leads manually formed to native7.62mm pitch. Do not buy preformed M-type6mm pitch. | Final supplier sourcing/price and physical assembly/functional tests pending. | assembly/BOM-PCBWay-panel.csv; group 23; reports/panel-netlist.xml
93 | Fitted component | Panel | R47 | 10k | 10k | 1 | piece | Panel assembly: new component supply | Yageo | MFR-12FRF52-10K | 13-MFR-12FRF52-10KCT-ND | Resistor_THT:R_Axial_DIN0207_L6.3mm_D2.5mm_P7.62mm_Horizontal | THT | Top |  |  | Factory component price unquoted; historical price is a reference only | 0.038 | 0.038 | 2026-10-31 | https://www.digikey.com/en/products/detail/yageo/MFR-12FRF52-10K/9133128 | https://yageogroup.com/content/Resource%20Library/Datasheet/YAGEO-MFR_DATASHEET.pdf | 1%,1/6W,100ppm/K; replaces MRS16 only at ordinary logic resistors, never precision R52–R54. At5.25V the1k dissipation27.6mW is below1/6W. Final placement envelopes must use MFR12 maximum, not the smaller old MRS16 body. No unapproved substitutions. MAX body L3.7xD2.1mm; MAX leadD0.50mm; straight FRF52 cut-tape leads manually formed to native7.62mm pitch. Do not buy preformed M-type6mm pitch. | Final supplier sourcing/price and physical assembly/functional tests pending. | assembly/BOM-PCBWay-panel.csv; group 23; reports/panel-netlist.xml
94 | Fitted component | Panel | R48 | 10k | 10k | 1 | piece | Panel assembly: new component supply | Yageo | MFR-12FRF52-10K | 13-MFR-12FRF52-10KCT-ND | Resistor_THT:R_Axial_DIN0207_L6.3mm_D2.5mm_P7.62mm_Horizontal | THT | Top |  |  | Factory component price unquoted; historical price is a reference only | 0.038 | 0.038 | 2026-10-31 | https://www.digikey.com/en/products/detail/yageo/MFR-12FRF52-10K/9133128 | https://yageogroup.com/content/Resource%20Library/Datasheet/YAGEO-MFR_DATASHEET.pdf | 1%,1/6W,100ppm/K; replaces MRS16 only at ordinary logic resistors, never precision R52–R54. At5.25V the1k dissipation27.6mW is below1/6W. Final placement envelopes must use MFR12 maximum, not the smaller old MRS16 body. No unapproved substitutions. MAX body L3.7xD2.1mm; MAX leadD0.50mm; straight FRF52 cut-tape leads manually formed to native7.62mm pitch. Do not buy preformed M-type6mm pitch. | Final supplier sourcing/price and physical assembly/functional tests pending. | assembly/BOM-PCBWay-panel.csv; group 23; reports/panel-netlist.xml
95 | Fitted component | Panel | R58 | 10k | 10k | 1 | piece | Panel assembly: new component supply | Yageo | MFR-12FRF52-10K | 13-MFR-12FRF52-10KCT-ND | Resistor_THT:R_Axial_DIN0207_L6.3mm_D2.5mm_P7.62mm_Horizontal | THT | Top |  |  | Factory component price unquoted; historical price is a reference only | 0.038 | 0.038 | 2026-10-31 | https://www.digikey.com/en/products/detail/yageo/MFR-12FRF52-10K/9133128 | https://yageogroup.com/content/Resource%20Library/Datasheet/YAGEO-MFR_DATASHEET.pdf | 1%,1/6W,100ppm/K; replaces MRS16 only at ordinary logic resistors, never precision R52–R54. At5.25V the1k dissipation27.6mW is below1/6W. Final placement envelopes must use MFR12 maximum, not the smaller old MRS16 body. No unapproved substitutions. MAX body L3.7xD2.1mm; MAX leadD0.50mm; straight FRF52 cut-tape leads manually formed to native7.62mm pitch. Do not buy preformed M-type6mm pitch. | Final supplier sourcing/price and physical assembly/functional tests pending. | assembly/BOM-PCBWay-panel.csv; group 23; reports/panel-netlist.xml
96 | Fitted component | Panel | R60 | 10k | 10k | 1 | piece | Panel assembly: new component supply | Yageo | MFR-12FRF52-10K | 13-MFR-12FRF52-10KCT-ND | Resistor_THT:R_Axial_DIN0207_L6.3mm_D2.5mm_P7.62mm_Horizontal | THT | Top |  |  | Factory component price unquoted; historical price is a reference only | 0.038 | 0.038 | 2026-10-31 | https://www.digikey.com/en/products/detail/yageo/MFR-12FRF52-10K/9133128 | https://yageogroup.com/content/Resource%20Library/Datasheet/YAGEO-MFR_DATASHEET.pdf | 1%,1/6W,100ppm/K; replaces MRS16 only at ordinary logic resistors, never precision R52–R54. At5.25V the1k dissipation27.6mW is below1/6W. Final placement envelopes must use MFR12 maximum, not the smaller old MRS16 body. No unapproved substitutions. MAX body L3.7xD2.1mm; MAX leadD0.50mm; straight FRF52 cut-tape leads manually formed to native7.62mm pitch. Do not buy preformed M-type6mm pitch. | Final supplier sourcing/price and physical assembly/functional tests pending. | assembly/BOM-PCBWay-panel.csv; group 23; reports/panel-netlist.xml
97 | Fitted component | Panel | R68 | 10k | 10k | 1 | piece | Panel assembly: new component supply | Yageo | MFR-12FRF52-10K | 13-MFR-12FRF52-10KCT-ND | Resistor_THT:R_Axial_DIN0207_L6.3mm_D2.5mm_P7.62mm_Horizontal | THT | Top |  |  | Factory component price unquoted; historical price is a reference only | 0.038 | 0.038 | 2026-10-31 | https://www.digikey.com/en/products/detail/yageo/MFR-12FRF52-10K/9133128 | https://yageogroup.com/content/Resource%20Library/Datasheet/YAGEO-MFR_DATASHEET.pdf | 1%,1/6W,100ppm/K; replaces MRS16 only at ordinary logic resistors, never precision R52–R54. At5.25V the1k dissipation27.6mW is below1/6W. Final placement envelopes must use MFR12 maximum, not the smaller old MRS16 body. No unapproved substitutions. MAX body L3.7xD2.1mm; MAX leadD0.50mm; straight FRF52 cut-tape leads manually formed to native7.62mm pitch. Do not buy preformed M-type6mm pitch. | Final supplier sourcing/price and physical assembly/functional tests pending. | assembly/BOM-PCBWay-panel.csv; group 23; reports/panel-netlist.xml
98 | Fitted component | Panel | R70 | 10k | 10k | 1 | piece | Panel assembly: new component supply | Yageo | MFR-12FRF52-10K | 13-MFR-12FRF52-10KCT-ND | Resistor_THT:R_Axial_DIN0207_L6.3mm_D2.5mm_P7.62mm_Horizontal | THT | Top |  |  | Factory component price unquoted; historical price is a reference only | 0.038 | 0.038 | 2026-10-31 | https://www.digikey.com/en/products/detail/yageo/MFR-12FRF52-10K/9133128 | https://yageogroup.com/content/Resource%20Library/Datasheet/YAGEO-MFR_DATASHEET.pdf | 1%,1/6W,100ppm/K; replaces MRS16 only at ordinary logic resistors, never precision R52–R54. At5.25V the1k dissipation27.6mW is below1/6W. Final placement envelopes must use MFR12 maximum, not the smaller old MRS16 body. No unapproved substitutions. MAX body L3.7xD2.1mm; MAX leadD0.50mm; straight FRF52 cut-tape leads manually formed to native7.62mm pitch. Do not buy preformed M-type6mm pitch. | Final supplier sourcing/price and physical assembly/functional tests pending. | assembly/BOM-PCBWay-panel.csv; group 23; reports/panel-netlist.xml
99 | Fitted component | Panel | R71 | 10k | 10k | 1 | piece | Panel assembly: new component supply | Yageo | MFR-12FRF52-10K | 13-MFR-12FRF52-10KCT-ND | Resistor_THT:R_Axial_DIN0207_L6.3mm_D2.5mm_P7.62mm_Horizontal | THT | Top |  |  | Factory component price unquoted; historical price is a reference only | 0.038 | 0.038 | 2026-10-31 | https://www.digikey.com/en/products/detail/yageo/MFR-12FRF52-10K/9133128 | https://yageogroup.com/content/Resource%20Library/Datasheet/YAGEO-MFR_DATASHEET.pdf | 1%,1/6W,100ppm/K; replaces MRS16 only at ordinary logic resistors, never precision R52–R54. At5.25V the1k dissipation27.6mW is below1/6W. Final placement envelopes must use MFR12 maximum, not the smaller old MRS16 body. No unapproved substitutions. MAX body L3.7xD2.1mm; MAX leadD0.50mm; straight FRF52 cut-tape leads manually formed to native7.62mm pitch. Do not buy preformed M-type6mm pitch. | Final supplier sourcing/price and physical assembly/functional tests pending. | assembly/BOM-PCBWay-panel.csv; group 23; reports/panel-netlist.xml
100 | Fitted component | Panel | R74 | 10k | 10k | 1 | piece | Panel assembly: new component supply | Yageo | MFR-12FRF52-10K | 13-MFR-12FRF52-10KCT-ND | Resistor_THT:R_Axial_DIN0207_L6.3mm_D2.5mm_P7.62mm_Horizontal | THT | Top |  |  | Factory component price unquoted; historical price is a reference only | 0.038 | 0.038 | 2026-10-31 | https://www.digikey.com/en/products/detail/yageo/MFR-12FRF52-10K/9133128 | https://yageogroup.com/content/Resource%20Library/Datasheet/YAGEO-MFR_DATASHEET.pdf | 1%,1/6W,100ppm/K; replaces MRS16 only at ordinary logic resistors, never precision R52–R54. At5.25V the1k dissipation27.6mW is below1/6W. Final placement envelopes must use MFR12 maximum, not the smaller old MRS16 body. No unapproved substitutions. MAX body L3.7xD2.1mm; MAX leadD0.50mm; straight FRF52 cut-tape leads manually formed to native7.62mm pitch. Do not buy preformed M-type6mm pitch. | Final supplier sourcing/price and physical assembly/functional tests pending. | assembly/BOM-PCBWay-panel.csv; group 23; reports/panel-netlist.xml
101 | Fitted component | Panel | R75 | 10k | 10k | 1 | piece | Panel assembly: new component supply | Yageo | MFR-12FRF52-10K | 13-MFR-12FRF52-10KCT-ND | Resistor_THT:R_Axial_DIN0207_L6.3mm_D2.5mm_P7.62mm_Horizontal | THT | Top |  |  | Factory component price unquoted; historical price is a reference only | 0.038 | 0.038 | 2026-10-31 | https://www.digikey.com/en/products/detail/yageo/MFR-12FRF52-10K/9133128 | https://yageogroup.com/content/Resource%20Library/Datasheet/YAGEO-MFR_DATASHEET.pdf | 1%,1/6W,100ppm/K; replaces MRS16 only at ordinary logic resistors, never precision R52–R54. At5.25V the1k dissipation27.6mW is below1/6W. Final placement envelopes must use MFR12 maximum, not the smaller old MRS16 body. No unapproved substitutions. MAX body L3.7xD2.1mm; MAX leadD0.50mm; straight FRF52 cut-tape leads manually formed to native7.62mm pitch. Do not buy preformed M-type6mm pitch. | Final supplier sourcing/price and physical assembly/functional tests pending. | assembly/BOM-PCBWay-panel.csv; group 23; reports/panel-netlist.xml
102 | Fitted component | Panel | R9 | 1k | 1k | 1 | piece | Panel assembly: new component supply | Yageo | MFR-12FRF52-1K | 13-MFR-12FRF52-1KCT-ND | Resistor_THT:R_Axial_DIN0207_L6.3mm_D2.5mm_P7.62mm_Horizontal | THT | Top |  |  | Factory component price unquoted; historical price is a reference only | 0.038 | 0.038 | 2026-10-31 | https://www.digikey.com/en/products/detail/yageo/MFR-12FRF52-1K/9133248 | https://yageogroup.com/content/Resource%20Library/Datasheet/YAGEO-MFR_DATASHEET.pdf | 1%,1/6W,100ppm/K; replaces MRS16 only at ordinary logic resistors, never precision R52–R54. At5.25V the1k dissipation27.6mW is below1/6W. Final placement envelopes must use MFR12 maximum, not the smaller old MRS16 body. No unapproved substitutions. MAX body L3.7xD2.1mm; MAX leadD0.50mm; straight FRF52 cut-tape leads manually formed to native7.62mm pitch. Do not buy preformed M-type6mm pitch. | Final supplier sourcing/price and physical assembly/functional tests pending. | assembly/BOM-PCBWay-panel.csv; group 24; reports/panel-netlist.xml
103 | Fitted component | Panel | R10 | 1k | 1k | 1 | piece | Panel assembly: new component supply | Yageo | MFR-12FRF52-1K | 13-MFR-12FRF52-1KCT-ND | Resistor_THT:R_Axial_DIN0207_L6.3mm_D2.5mm_P7.62mm_Horizontal | THT | Top |  |  | Factory component price unquoted; historical price is a reference only | 0.038 | 0.038 | 2026-10-31 | https://www.digikey.com/en/products/detail/yageo/MFR-12FRF52-1K/9133248 | https://yageogroup.com/content/Resource%20Library/Datasheet/YAGEO-MFR_DATASHEET.pdf | 1%,1/6W,100ppm/K; replaces MRS16 only at ordinary logic resistors, never precision R52–R54. At5.25V the1k dissipation27.6mW is below1/6W. Final placement envelopes must use MFR12 maximum, not the smaller old MRS16 body. No unapproved substitutions. MAX body L3.7xD2.1mm; MAX leadD0.50mm; straight FRF52 cut-tape leads manually formed to native7.62mm pitch. Do not buy preformed M-type6mm pitch. | Final supplier sourcing/price and physical assembly/functional tests pending. | assembly/BOM-PCBWay-panel.csv; group 24; reports/panel-netlist.xml
104 | Fitted component | Panel | R11 | 1k | 1k | 1 | piece | Panel assembly: new component supply | Yageo | MFR-12FRF52-1K | 13-MFR-12FRF52-1KCT-ND | Resistor_THT:R_Axial_DIN0207_L6.3mm_D2.5mm_P7.62mm_Horizontal | THT | Top |  |  | Factory component price unquoted; historical price is a reference only | 0.038 | 0.038 | 2026-10-31 | https://www.digikey.com/en/products/detail/yageo/MFR-12FRF52-1K/9133248 | https://yageogroup.com/content/Resource%20Library/Datasheet/YAGEO-MFR_DATASHEET.pdf | 1%,1/6W,100ppm/K; replaces MRS16 only at ordinary logic resistors, never precision R52–R54. At5.25V the1k dissipation27.6mW is below1/6W. Final placement envelopes must use MFR12 maximum, not the smaller old MRS16 body. No unapproved substitutions. MAX body L3.7xD2.1mm; MAX leadD0.50mm; straight FRF52 cut-tape leads manually formed to native7.62mm pitch. Do not buy preformed M-type6mm pitch. | Final supplier sourcing/price and physical assembly/functional tests pending. | assembly/BOM-PCBWay-panel.csv; group 24; reports/panel-netlist.xml
105 | Fitted component | Panel | R12 | 1k | 1k | 1 | piece | Panel assembly: new component supply | Yageo | MFR-12FRF52-1K | 13-MFR-12FRF52-1KCT-ND | Resistor_THT:R_Axial_DIN0207_L6.3mm_D2.5mm_P7.62mm_Horizontal | THT | Top |  |  | Factory component price unquoted; historical price is a reference only | 0.038 | 0.038 | 2026-10-31 | https://www.digikey.com/en/products/detail/yageo/MFR-12FRF52-1K/9133248 | https://yageogroup.com/content/Resource%20Library/Datasheet/YAGEO-MFR_DATASHEET.pdf | 1%,1/6W,100ppm/K; replaces MRS16 only at ordinary logic resistors, never precision R52–R54. At5.25V the1k dissipation27.6mW is below1/6W. Final placement envelopes must use MFR12 maximum, not the smaller old MRS16 body. No unapproved substitutions. MAX body L3.7xD2.1mm; MAX leadD0.50mm; straight FRF52 cut-tape leads manually formed to native7.62mm pitch. Do not buy preformed M-type6mm pitch. | Final supplier sourcing/price and physical assembly/functional tests pending. | assembly/BOM-PCBWay-panel.csv; group 24; reports/panel-netlist.xml
106 | Fitted component | Panel | R13 | 1k | 1k | 1 | piece | Panel assembly: new component supply | Yageo | MFR-12FRF52-1K | 13-MFR-12FRF52-1KCT-ND | Resistor_THT:R_Axial_DIN0207_L6.3mm_D2.5mm_P7.62mm_Horizontal | THT | Top |  |  | Factory component price unquoted; historical price is a reference only | 0.038 | 0.038 | 2026-10-31 | https://www.digikey.com/en/products/detail/yageo/MFR-12FRF52-1K/9133248 | https://yageogroup.com/content/Resource%20Library/Datasheet/YAGEO-MFR_DATASHEET.pdf | 1%,1/6W,100ppm/K; replaces MRS16 only at ordinary logic resistors, never precision R52–R54. At5.25V the1k dissipation27.6mW is below1/6W. Final placement envelopes must use MFR12 maximum, not the smaller old MRS16 body. No unapproved substitutions. MAX body L3.7xD2.1mm; MAX leadD0.50mm; straight FRF52 cut-tape leads manually formed to native7.62mm pitch. Do not buy preformed M-type6mm pitch. | Final supplier sourcing/price and physical assembly/functional tests pending. | assembly/BOM-PCBWay-panel.csv; group 24; reports/panel-netlist.xml
107 | Fitted component | Panel | R14 | 1k | 1k | 1 | piece | Panel assembly: new component supply | Yageo | MFR-12FRF52-1K | 13-MFR-12FRF52-1KCT-ND | Resistor_THT:R_Axial_DIN0207_L6.3mm_D2.5mm_P7.62mm_Horizontal | THT | Top |  |  | Factory component price unquoted; historical price is a reference only | 0.038 | 0.038 | 2026-10-31 | https://www.digikey.com/en/products/detail/yageo/MFR-12FRF52-1K/9133248 | https://yageogroup.com/content/Resource%20Library/Datasheet/YAGEO-MFR_DATASHEET.pdf | 1%,1/6W,100ppm/K; replaces MRS16 only at ordinary logic resistors, never precision R52–R54. At5.25V the1k dissipation27.6mW is below1/6W. Final placement envelopes must use MFR12 maximum, not the smaller old MRS16 body. No unapproved substitutions. MAX body L3.7xD2.1mm; MAX leadD0.50mm; straight FRF52 cut-tape leads manually formed to native7.62mm pitch. Do not buy preformed M-type6mm pitch. | Final supplier sourcing/price and physical assembly/functional tests pending. | assembly/BOM-PCBWay-panel.csv; group 24; reports/panel-netlist.xml
108 | Fitted component | Panel | R15 | 1k | 1k | 1 | piece | Panel assembly: new component supply | Yageo | MFR-12FRF52-1K | 13-MFR-12FRF52-1KCT-ND | Resistor_THT:R_Axial_DIN0207_L6.3mm_D2.5mm_P7.62mm_Horizontal | THT | Top |  |  | Factory component price unquoted; historical price is a reference only | 0.038 | 0.038 | 2026-10-31 | https://www.digikey.com/en/products/detail/yageo/MFR-12FRF52-1K/9133248 | https://yageogroup.com/content/Resource%20Library/Datasheet/YAGEO-MFR_DATASHEET.pdf | 1%,1/6W,100ppm/K; replaces MRS16 only at ordinary logic resistors, never precision R52–R54. At5.25V the1k dissipation27.6mW is below1/6W. Final placement envelopes must use MFR12 maximum, not the smaller old MRS16 body. No unapproved substitutions. MAX body L3.7xD2.1mm; MAX leadD0.50mm; straight FRF52 cut-tape leads manually formed to native7.62mm pitch. Do not buy preformed M-type6mm pitch. | Final supplier sourcing/price and physical assembly/functional tests pending. | assembly/BOM-PCBWay-panel.csv; group 24; reports/panel-netlist.xml
109 | Fitted component | Panel | R16 | 1k | 1k | 1 | piece | Panel assembly: new component supply | Yageo | MFR-12FRF52-1K | 13-MFR-12FRF52-1KCT-ND | Resistor_THT:R_Axial_DIN0207_L6.3mm_D2.5mm_P7.62mm_Horizontal | THT | Top |  |  | Factory component price unquoted; historical price is a reference only | 0.038 | 0.038 | 2026-10-31 | https://www.digikey.com/en/products/detail/yageo/MFR-12FRF52-1K/9133248 | https://yageogroup.com/content/Resource%20Library/Datasheet/YAGEO-MFR_DATASHEET.pdf | 1%,1/6W,100ppm/K; replaces MRS16 only at ordinary logic resistors, never precision R52–R54. At5.25V the1k dissipation27.6mW is below1/6W. Final placement envelopes must use MFR12 maximum, not the smaller old MRS16 body. No unapproved substitutions. MAX body L3.7xD2.1mm; MAX leadD0.50mm; straight FRF52 cut-tape leads manually formed to native7.62mm pitch. Do not buy preformed M-type6mm pitch. | Final supplier sourcing/price and physical assembly/functional tests pending. | assembly/BOM-PCBWay-panel.csv; group 24; reports/panel-netlist.xml
110 | Fitted component | Panel | R19 | 1k | 1k | 1 | piece | Panel assembly: new component supply | Yageo | MFR-12FRF52-1K | 13-MFR-12FRF52-1KCT-ND | Resistor_THT:R_Axial_DIN0207_L6.3mm_D2.5mm_P7.62mm_Horizontal | THT | Top |  |  | Factory component price unquoted; historical price is a reference only | 0.038 | 0.038 | 2026-10-31 | https://www.digikey.com/en/products/detail/yageo/MFR-12FRF52-1K/9133248 | https://yageogroup.com/content/Resource%20Library/Datasheet/YAGEO-MFR_DATASHEET.pdf | 1%,1/6W,100ppm/K; replaces MRS16 only at ordinary logic resistors, never precision R52–R54. At5.25V the1k dissipation27.6mW is below1/6W. Final placement envelopes must use MFR12 maximum, not the smaller old MRS16 body. No unapproved substitutions. MAX body L3.7xD2.1mm; MAX leadD0.50mm; straight FRF52 cut-tape leads manually formed to native7.62mm pitch. Do not buy preformed M-type6mm pitch. | Final supplier sourcing/price and physical assembly/functional tests pending. | assembly/BOM-PCBWay-panel.csv; group 24; reports/panel-netlist.xml
111 | Fitted component | Panel | R20 | 1k | 1k | 1 | piece | Panel assembly: new component supply | Yageo | MFR-12FRF52-1K | 13-MFR-12FRF52-1KCT-ND | Resistor_THT:R_Axial_DIN0207_L6.3mm_D2.5mm_P7.62mm_Horizontal | THT | Top |  |  | Factory component price unquoted; historical price is a reference only | 0.038 | 0.038 | 2026-10-31 | https://www.digikey.com/en/products/detail/yageo/MFR-12FRF52-1K/9133248 | https://yageogroup.com/content/Resource%20Library/Datasheet/YAGEO-MFR_DATASHEET.pdf | 1%,1/6W,100ppm/K; replaces MRS16 only at ordinary logic resistors, never precision R52–R54. At5.25V the1k dissipation27.6mW is below1/6W. Final placement envelopes must use MFR12 maximum, not the smaller old MRS16 body. No unapproved substitutions. MAX body L3.7xD2.1mm; MAX leadD0.50mm; straight FRF52 cut-tape leads manually formed to native7.62mm pitch. Do not buy preformed M-type6mm pitch. | Final supplier sourcing/price and physical assembly/functional tests pending. | assembly/BOM-PCBWay-panel.csv; group 24; reports/panel-netlist.xml
112 | Fitted component | Panel | R49 | 1k | 1k | 1 | piece | Panel assembly: new component supply | Yageo | MFR-12FRF52-1K | 13-MFR-12FRF52-1KCT-ND | Resistor_THT:R_Axial_DIN0207_L6.3mm_D2.5mm_P7.62mm_Horizontal | THT | Top |  |  | Factory component price unquoted; historical price is a reference only | 0.038 | 0.038 | 2026-10-31 | https://www.digikey.com/en/products/detail/yageo/MFR-12FRF52-1K/9133248 | https://yageogroup.com/content/Resource%20Library/Datasheet/YAGEO-MFR_DATASHEET.pdf | 1%,1/6W,100ppm/K; replaces MRS16 only at ordinary logic resistors, never precision R52–R54. At5.25V the1k dissipation27.6mW is below1/6W. Final placement envelopes must use MFR12 maximum, not the smaller old MRS16 body. No unapproved substitutions. MAX body L3.7xD2.1mm; MAX leadD0.50mm; straight FRF52 cut-tape leads manually formed to native7.62mm pitch. Do not buy preformed M-type6mm pitch. | Final supplier sourcing/price and physical assembly/functional tests pending. | assembly/BOM-PCBWay-panel.csv; group 24; reports/panel-netlist.xml
113 | Fitted component | Panel | R50 | 1k | 1k | 1 | piece | Panel assembly: new component supply | Yageo | MFR-12FRF52-1K | 13-MFR-12FRF52-1KCT-ND | Resistor_THT:R_Axial_DIN0207_L6.3mm_D2.5mm_P7.62mm_Horizontal | THT | Top |  |  | Factory component price unquoted; historical price is a reference only | 0.038 | 0.038 | 2026-10-31 | https://www.digikey.com/en/products/detail/yageo/MFR-12FRF52-1K/9133248 | https://yageogroup.com/content/Resource%20Library/Datasheet/YAGEO-MFR_DATASHEET.pdf | 1%,1/6W,100ppm/K; replaces MRS16 only at ordinary logic resistors, never precision R52–R54. At5.25V the1k dissipation27.6mW is below1/6W. Final placement envelopes must use MFR12 maximum, not the smaller old MRS16 body. No unapproved substitutions. MAX body L3.7xD2.1mm; MAX leadD0.50mm; straight FRF52 cut-tape leads manually formed to native7.62mm pitch. Do not buy preformed M-type6mm pitch. | Final supplier sourcing/price and physical assembly/functional tests pending. | assembly/BOM-PCBWay-panel.csv; group 24; reports/panel-netlist.xml
114 | Fitted component | Panel | R51 | 1k | 1k | 1 | piece | Panel assembly: new component supply | Yageo | MFR-12FRF52-1K | 13-MFR-12FRF52-1KCT-ND | Resistor_THT:R_Axial_DIN0207_L6.3mm_D2.5mm_P7.62mm_Horizontal | THT | Top |  |  | Factory component price unquoted; historical price is a reference only | 0.038 | 0.038 | 2026-10-31 | https://www.digikey.com/en/products/detail/yageo/MFR-12FRF52-1K/9133248 | https://yageogroup.com/content/Resource%20Library/Datasheet/YAGEO-MFR_DATASHEET.pdf | 1%,1/6W,100ppm/K; replaces MRS16 only at ordinary logic resistors, never precision R52–R54. At5.25V the1k dissipation27.6mW is below1/6W. Final placement envelopes must use MFR12 maximum, not the smaller old MRS16 body. No unapproved substitutions. MAX body L3.7xD2.1mm; MAX leadD0.50mm; straight FRF52 cut-tape leads manually formed to native7.62mm pitch. Do not buy preformed M-type6mm pitch. | Final supplier sourcing/price and physical assembly/functional tests pending. | assembly/BOM-PCBWay-panel.csv; group 24; reports/panel-netlist.xml
115 | Fitted component | Panel | R55 | 1k | 1k | 1 | piece | Panel assembly: new component supply | Yageo | MFR-12FRF52-1K | 13-MFR-12FRF52-1KCT-ND | Resistor_THT:R_Axial_DIN0207_L6.3mm_D2.5mm_P7.62mm_Horizontal | THT | Top |  |  | Factory component price unquoted; historical price is a reference only | 0.038 | 0.038 | 2026-10-31 | https://www.digikey.com/en/products/detail/yageo/MFR-12FRF52-1K/9133248 | https://yageogroup.com/content/Resource%20Library/Datasheet/YAGEO-MFR_DATASHEET.pdf | 1%,1/6W,100ppm/K; replaces MRS16 only at ordinary logic resistors, never precision R52–R54. At5.25V the1k dissipation27.6mW is below1/6W. Final placement envelopes must use MFR12 maximum, not the smaller old MRS16 body. No unapproved substitutions. MAX body L3.7xD2.1mm; MAX leadD0.50mm; straight FRF52 cut-tape leads manually formed to native7.62mm pitch. Do not buy preformed M-type6mm pitch. | Final supplier sourcing/price and physical assembly/functional tests pending. | assembly/BOM-PCBWay-panel.csv; group 24; reports/panel-netlist.xml
116 | Fitted component | Panel | R61 | 1k | 1k | 1 | piece | Panel assembly: new component supply | Yageo | MFR-12FRF52-1K | 13-MFR-12FRF52-1KCT-ND | Resistor_THT:R_Axial_DIN0207_L6.3mm_D2.5mm_P7.62mm_Horizontal | THT | Top |  |  | Factory component price unquoted; historical price is a reference only | 0.038 | 0.038 | 2026-10-31 | https://www.digikey.com/en/products/detail/yageo/MFR-12FRF52-1K/9133248 | https://yageogroup.com/content/Resource%20Library/Datasheet/YAGEO-MFR_DATASHEET.pdf | 1%,1/6W,100ppm/K; replaces MRS16 only at ordinary logic resistors, never precision R52–R54. At5.25V the1k dissipation27.6mW is below1/6W. Final placement envelopes must use MFR12 maximum, not the smaller old MRS16 body. No unapproved substitutions. MAX body L3.7xD2.1mm; MAX leadD0.50mm; straight FRF52 cut-tape leads manually formed to native7.62mm pitch. Do not buy preformed M-type6mm pitch. | Final supplier sourcing/price and physical assembly/functional tests pending. | assembly/BOM-PCBWay-panel.csv; group 24; reports/panel-netlist.xml
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
