gmaxdragon/Seizo-Screen/00-bom-halflife.csv

Item | Purpose | Quantity | Unit Cost USD | Vendor | Link
Various capacitors | Quote pending; 0.00 is a placeholder for one complete lot of 33 panel parts. Exact values and packages remain in the factory BOM. | 1 | 0.00 | PCBWay | https://www.pcbway.com/quotesmt.aspx
Various resistors | Quote pending; 0.00 is a placeholder for one complete lot of 73 panel parts. Exact values and packages remain in the factory BOM. | 1 | 0.00 | PCBWay | https://www.pcbway.com/quotesmt.aspx
WP3A8GD (D1, D5) | Quote pending; 0.00 is a placeholder. 3V3 POWER / PROTO POWER. Exact placement and package remain in the panel factory BOM. | 2 | 0.00 | PCBWay | https://www.pcbway.com/quotesmt.aspx
WP3A8ID (D2) | Quote pending; 0.00 is a placeholder. PROTO FAULT. Exact placement and package remain in the panel factory BOM. | 1 | 0.00 | PCBWay | https://www.pcbway.com/quotesmt.aspx
BAT85S-TAP (D3, D4) | Quote pending; 0.00 is a placeholder. BAT85. Exact placement and package remain in the panel factory BOM. | 2 | 0.00 | PCBWay | https://www.pcbway.com/quotesmt.aspx
MF-RHT050-0 (F1) | Quote pending; 0.00 is a placeholder. MF-RHT050-0 / 500mA HOLD. Exact placement and package remain in the panel factory BOM. | 1 | 0.00 | PCBWay | https://www.pcbway.com/quotesmt.aspx
B3F-1000 (SW1, SW2, SW3, SW4, SW5, SW6, SW7, SW8, SW9, SW10, SW11, SW12) | Quote pending; 0.00 is a placeholder. F1 / F10 / F2 / F3 / F4 / F5 / F6 / F7 / F8 / F9 / HOLD REQUEST / I/O RESET ONLY. Exact placement and package remain in the panel factory BOM. | 12 | 0.00 | PCBWay | https://www.pcbway.com/quotesmt.aspx
JS202011CQN (SW13, SW14) | Quote pending; 0.00 is a placeholder. METER ENABLE / PROTO 5V OFF / ON (100mA). Exact placement and package remain in the panel factory BOM. | 2 | 0.00 | PCBWay | https://www.pcbway.com/quotesmt.aspx
AQY212EH (K1) | Quote pending; 0.00 is a placeholder. AQY212EH / INPUT DISCONNECT. Exact placement and package remain in the panel factory BOM. | 1 | 0.00 | PCBWay | https://www.pcbway.com/quotesmt.aspx
MCP23017-E/SP (U1) | Quote pending; 0.00 is a placeholder. MCP23017-E/SP / 0x20. Exact placement and package remain in the panel factory BOM. | 1 | 0.00 | PCBWay | https://www.pcbway.com/quotesmt.aspx
MCP3202-BI/P (U2) | Quote pending; 0.00 is a placeholder. MCP3202-BI/P. Exact placement and package remain in the panel factory BOM. | 1 | 0.00 | PCBWay | https://www.pcbway.com/quotesmt.aspx
MCP6002-I/P (U3) | Quote pending; 0.00 is a placeholder. MCP6002-I/P. Exact placement and package remain in the panel factory BOM. | 1 | 0.00 | PCBWay | https://www.pcbway.com/quotesmt.aspx
MCP1525-I/TO (U4) | Quote pending; 0.00 is a placeholder. MCP1525-I/TO. Exact placement and package remain in the panel factory BOM. | 1 | 0.00 | PCBWay | https://www.pcbway.com/quotesmt.aspx
TPS2553DBVR-1 (U5) | Quote pending; 0.00 is a placeholder. TPS2553DBVR-1 / LATCH OFF. Exact placement and package remain in the panel factory BOM. | 1 | 0.00 | PCBWay | https://www.pcbway.com/quotesmt.aspx
4683 (U6) | Quote pending; 0.00 is a placeholder. Adafruit 4683 3V3 BUCK. Exact placement and package remain in the panel factory BOM. | 1 | 0.00 | PCBWay | https://www.pcbway.com/quotesmt.aspx
SN74LV125AN (U8, U9, U10) | Quote pending; 0.00 is a placeholder. SN74LV125AN. Exact placement and package remain in the panel factory BOM. | 3 | 0.00 | PCBWay | https://www.pcbway.com/quotesmt.aspx
SN74AHC14N (U11) | Quote pending; 0.00 is a placeholder. SN74AHC14N. Exact placement and package remain in the panel factory BOM. | 1 | 0.00 | PCBWay | https://www.pcbway.com/quotesmt.aspx
PRPC002SAAN-RC (J3, J4, J9, J10, J11, J12, J13) | Quote pending; 0.00 is a placeholder. 2-position 2.54mm single-row male vertical header. Exact placement and package remain in the panel factory BOM. | 7 | 0.00 | PCBWay | https://www.pcbway.com/quotesmt.aspx
PRPC003SAAN-RC (J7, J8) | Quote pending; 0.00 is a placeholder. 3-position 2.54mm single-row male vertical header. Exact placement and package remain in the panel factory BOM. | 2 | 0.00 | PCBWay | https://www.pcbway.com/quotesmt.aspx
PRPC006SAAN-RC (J1, J5, J6) | Quote pending; 0.00 is a placeholder. 6-position 2.54mm single-row male vertical header. Exact placement and package remain in the panel factory BOM. | 3 | 0.00 | PCBWay | https://www.pcbway.com/quotesmt.aspx
PRPC011SAAN-RC (J2) | Quote pending; 0.00 is a placeholder. 11-position 2.54mm single-row male vertical header. Exact placement and package remain in the panel factory BOM. | 1 | 0.00 | PCBWay | https://www.pcbway.com/quotesmt.aspx
2.8-inch touchscreen — Waveshare 16446 | Quote pending; 0.00 is a placeholder. Main SPI touch display; actual internal LCD 3.3V tap and supplied module revision still need qualification. | 1 | 0.00 | PCBWay | https://www.pcbway.com/quotesmt.aspx
Mini breadboard — Adafruit 65 | Quote pending; 0.00 is a placeholder. 46x36mm breadboard for the panel prototype-power area. | 1 | 0.00 | PCBWay | https://www.pcbway.com/quotesmt.aspx
Connection wires and mating connectors | Quote pending; 0.00 is a placeholder. One kit for panel/HAT power, I2C, SPI, control, diagnostics, LCD/VIO, breadboard and meter leads; per connector pin map. | 1 | 0.00 | PCBWay | https://www.pcbway.com/quotesmt.aspx
Mounting hardware | Quote pending; 0.00 is a placeholder. One panel/display mounting kit with screws, spacers, washers and insulation; final lengths and clearances per assembly instructions. | 1 | 0.00 | PCBWay | https://www.pcbway.com/quotesmt.aspx
Panel PCB fabrication — 5-board batch | Preliminary calculator price for one batch of five bare panels. Final supplier review pending; excludes assembly, components and shipping. | 1 | 48.31 | PCBWay | https://www.pcbway.com/quotesmt.aspx
Factory assembly — 1 panel | Preliminary calculator assembly fee for one panel; excludes component supply and shipping. Final itemized turnkey quote pending. | 1 | 29.00 | PCBWay | https://www.pcbway.com/quotesmt.aspx
