gmaxdragon/Seizo-Screen/bom.csv

Category | Board | References | Quantity | Manufacturer | Manufacturer_Part_Number | Preferred_Vendor | Distributor_Part_Number | Factory_Quote_Unit_USD | Factory_Quote_Line_USD | Price_Status | Reference_Unit_USD | Reference_Source | Assembly_Status | Notes
PCB fitted component | Panel | C1, C2, C3, C4, C5, C6, C7, C8, C9, C10, C14, C16, C18, C19, C20, C21, C24, C26, C28, C29, C31, C33, C34, C35, C36 | 25 | KEMET | C315C104K5R5TA | PCBWay turnkey quotation | 399-C315C104K5R5TA-ND |  |  | AWAITING ITEMIZED FACTORY QUOTE | 0.488 | https://www.digikey.com/en/products/detail/kemet/C315C104K5R5TA/12701330 | THT; Top | 100n. X7R 50V +/-10%; do not replace with large 5.08 mm-pitch discs. C25 is BACK; exact maximum envelope must be included in final opposite-side solder clearance check. No unapproved substitutions. Reference unit prices are historical distributor observations, not factory or delivered prices.
PCB fitted component | Panel | C25 | 1 | KEMET | C315C104K5R5TA | PCBWay turnkey quotation | 399-C315C104K5R5TA-ND |  |  | AWAITING ITEMIZED FACTORY QUOTE | 0.488 | https://www.digikey.com/en/products/detail/kemet/C315C104K5R5TA/12701330 | THT; Bottom | 100n. X7R 50V +/-10%; do not replace with large 5.08 mm-pitch discs. C25 is BACK; exact maximum envelope must be included in final opposite-side solder clearance check. Install body at least 1.5mm above rear PCB face; nearby clipped rear lead ends at most 1.0mm; no solder spikes. No unapproved substitutions. Reference unit prices are historical distributor observations, not factory or delivered prices.
PCB fitted component | Panel | C22, C23 | 2 | KEMET | C315C102J1G5TA | PCBWay turnkey quotation | 399-4143-ND |  |  | AWAITING ITEMIZED FACTORY QUOTE | 0.77 | https://www.digikey.com/en/products/detail/kemet/C315C102J1G5TA/817919 | THT; Top | 1n. C0G 100V +/-5%; retain low-loss dielectric. No unapproved substitutions. Reference unit prices are historical distributor observations, not factory or delivered prices.
PCB fitted component | Panel | C15, C17, C30 | 3 | Panasonic | EEU-FR1H100 | PCBWay turnkey quotation | P124233-ND |  |  | AWAITING ITEMIZED FACTORY QUOTE | 0.41 | https://www.digikey.com/en/products/detail/panasonic-industry/EEU-FR1H100/9921028 | THT; Top | 10u / 50V. Polarized; lead pitch is 2 mm, not 2.5 mm. Manufacturer model dimensions also available at Panasonic product page. No unapproved substitutions. Reference unit prices are historical distributor observations, not factory or delivered prices.
PCB fitted component | Panel | C27 | 1 | Rubycon | 50YXJ4.7M5X11 | PCBWay turnkey quotation | 50YXJ4.7M5X11-ND |  |  | AWAITING ITEMIZED FACTORY QUOTE | 0.28 | https://www.digikey.com/en/products/detail/rubycon/50YXJ4-7M5X11/3562902 | THT; Top | 4.7u / 50V. Selected replacement removes separate Mouser shipment. 4.7u+/-20%=3.76..5.64u meets MCP1525 CL1..10u. 50V rating exceeds2.5V rail;5000h105C; leakage<=3uA; impedance1.9ohmMAX@100kHz/20C. MCP1525 datasheet states no numericESRwindow; assembledstartup/noise/stabilityremainprototypechecks. Matchstripe/minus to pad2/GND, positivepad1/REF_2V5. No unapproved substitutions. Reference unit prices are historical distributor observations, not factory or delivered prices.
PCB fitted component | Panel | R35, R36, R37, R38, R39, R56, R57, R64, R65, R66 | 10 | Yageo | MFR-12FTF52-100R | PCBWay turnkey quotation | 13-MFR-12FTF52-100RCT-ND |  |  | AWAITING ITEMIZED FACTORY QUOTE | 0.038 | https://www.digikey.com/en/products/detail/yageo/MFR-12FTF52-100R/9133808 | THT; Top | 100. 100ohm1%,1/6W@70C,100ppm/K; FTF means box-packed straight leads, not preformed M-type. Same logic-series resistance.8mA continuous design current dissipates6.4mW; not a fuse or independent stop. Slightly wider body than oldMRS16 passed independent native max-envelope audit without any PCB movement. No unapproved substitutions. Reference unit prices are historical distributor observations, not factory or delivered prices.
PCB fitted component | Panel | R32, R33, R34, R63 | 4 | Vishay | MRS16000C3309FCT00 | PCBWay turnkey quotation | 56-MRS16000C3309FCT00CT-ND |  |  | AWAITING ITEMIZED FACTORY QUOTE | 0.22 | https://www.digikey.com/en/products/detail/vishay-beyschlag-draloric-bc-components/MRS16000C3309FCT00/5063865 | THT; Top | 33. 1%,0.4W,50ppm/K. Smaller body than existing DIN0207 outline; P7.62 exceeds specified Mmin5.0. Primary does not state lead diameter maximum, so do not claim fully bounded lead tolerance. Cut tape only; groups>=10 priced at quantity10 break. Exact values unchanged. No unapproved substitutions. Reference unit prices are historical distributor observations, not factory or delivered prices.
PCB fitted component | Panel | R27, R28, R62 | 3 | Vishay | MRS16000C2201FCT00 | PCBWay turnkey quotation | BC3931CT-ND |  |  | AWAITING ITEMIZED FACTORY QUOTE | 0.22 | https://www.digikey.com/en/products/detail/vishay-beyschlag-draloric-bc-components/MRS16000C2201FCT00/5063816 | THT; Top | 2.2k. 1%,0.4W,50ppm/K. Smaller body than existing DIN0207 outline; P7.62 exceeds specified Mmin5.0. Primary does not state lead diameter maximum, so do not claim fully bounded lead tolerance. Cut tape only; groups>=10 priced at quantity10 break. Exact values unchanged. No unapproved substitutions. Reference unit prices are historical distributor observations, not factory or delivered prices.
PCB fitted component | Panel | R59 | 1 | Vishay | MRS16000C3300FCT00 | PCBWay turnkey quotation | BC3933CT-ND |  |  | AWAITING ITEMIZED FACTORY QUOTE | 0.22 | https://www.digikey.com/en/products/detail/vishay-beyschlag-draloric-bc-components/MRS16000C3300FCT00/5063859 | THT; Top | 330 / 1%. 1%,0.4W,50ppm/K. Smaller body than existing DIN0207 outline; P7.62 exceeds specified Mmin5.0. Primary does not state lead diameter maximum, so do not claim fully bounded lead tolerance. Cut tape only; groups>=10 priced at quantity10 break. Exact values unchanged. No unapproved substitutions. Reference unit prices are historical distributor observations, not factory or delivered prices.
PCB fitted component | Panel | R52, R53 | 2 | Vishay | CMF5549K900BEEA | PCBWay turnkey quotation | CMF49.9KHLCT-ND |  |  | AWAITING ITEMIZED FACTORY QUOTE | 1.57 | https://www.digikey.com/en/products/detail/vishay-dale/CMF5549K900BEEA/3622041 | THT; Top | 49.9k / 0.1%. 49.9k +/-0.1%, 25ppm/C. Vendor nominal L6.10 x D2.29 is smaller than primary max; use primary max for clearance. Rev21 7.62 mm pitch was not qualified. Final rev22 stock 10.16 mm footprint and native routing/DRC were checked; no forced lead bends are needed. No unapproved substitutions. Reference unit prices are historical distributor observations, not factory or delivered prices.
PCB fitted component | Panel | R54 | 1 | Vishay | CMF5510K000BEEA | PCBWay turnkey quotation | CMF10.0KHLCT-ND |  |  | AWAITING ITEMIZED FACTORY QUOTE | 1.75 | https://www.digikey.com/en/products/detail/vishay-dale/CMF5510K000BEEA/3622035 | THT; Top | 10.0k / 0.1%. 10.0k +/-0.1%, 25ppm/C. Use cut tape. TE H8 alternatives are longer and not approved here. Rev21 7.62 mm pitch was not qualified. Final rev22 stock 10.16 mm footprint and native routing/DRC were checked; no forced lead bends are needed. No unapproved substitutions. Reference unit prices are historical distributor observations, not factory or delivered prices.
PCB fitted component | Panel | D1, D5 | 2 | Kingbright | WP3A8GD | PCBWay turnkey quotation | 754-1217-ND |  |  | AWAITING ITEMIZED FACTORY QUOTE | 0.25 | https://www.digikey.com/en/products/detail/kingbright/WP3A8GD/1747616 | THT; Top | 3V3 POWER / PROTO POWER. Green diffused; exact shaft MAX0.50x0.45mm diagonal0.67268; native0.90mm hole minimum0.82mm at JLCPCB -0.08 tolerance. Keep0.7MAX stamping shoulders ABOVE PCB; do not force lens flush. Brightness is not hardware-tested. Match cathode K/pad1. No unapproved substitutions. Reference unit prices are historical distributor observations, not factory or delivered prices.
PCB fitted component | Panel | D2 | 1 | Kingbright | WP3A8ID | PCBWay turnkey quotation | 754-1219-ND |  |  | AWAITING ITEMIZED FACTORY QUOTE | 0.27 | https://www.digikey.com/en/products/detail/kingbright/WP3A8ID/1747618 | THT; Top | PROTO FAULT. Red diffused. This exact current RED drawing differs from the older GREEN drawing: do not reuse green lead tolerances. Native D2 has an intentional local stock-footprint drill override. Manufacturer recommends0.9mm but that does not cover simultaneous rectangular maxima plus negative hole tolerance. Keep stamping shoulders abovePCB; match cathode K/pad1. Final native hash/DRC must include D2 correction. No unapproved substitutions. Reference unit prices are historical distributor observations, not factory or delivered prices.
PCB fitted component | Panel | D3, D4 | 2 | Vishay | BAT85S-TAP | PCBWay turnkey quotation | BAT85S-TAPCT-ND |  |  | AWAITING ITEMIZED FACTORY QUOTE | 0.5 | https://www.digikey.com/en/products/detail/vishay-general-semiconductor-diodes-division/BAT85S-TAP/3104127 | THT; Top | BAT85. BAT85 family single Schottky, 30V. Not BAT54 in SOT23. Reverse leakage is not zero; accuracy remains subject to calibration/temperature testing. No unapproved substitutions. Reference unit prices are historical distributor observations, not factory or delivered prices.
PCB fitted component | Panel | F1 | 1 | Bourns | MF-RHT050-0 | PCBWay turnkey quotation | MF-RHT050-0-ND |  |  | AWAITING ITEMIZED FACTORY QUOTE | 0.89 | https://www.digikey.com/en/products/detail/bourns-inc/MF-RHT050-0/6229412 | THT; Top | MF-RHT050-0 / 500mA HOLD. 500mA HOLD at23C only; at50C hold0.40A, at70C0.34A. Rinitial>=0.48ohm and posttrip<=1.10ohm. A PTC is slow and cannot guarantee no Pi reset on a short. No unapproved substitutions. Reference unit prices are historical distributor observations, not factory or delivered prices.
PCB fitted component | Panel | SW1, SW2, SW3, SW4, SW5, SW6, SW7, SW8, SW9, SW10, SW11, SW12 | 12 | Omron | B3F-1000 | PCBWay turnkey quotation | SW400-ND |  |  | AWAITING ITEMIZED FACTORY QUOTE | 0.299 | https://www.digikey.com/en/products/detail/omron-electronics-inc-emc-div/B3F-1000/33150 | THT; Top | F1 / F10 / F2 / F3 / F4 / F5 / F6 / F7 / F8 / F9 / HOLD REQUEST / I/O RESET ONLY. Tactile momentary. These are NOT latching emergency-stop switches. Do not buy side-actuated, 12mm or other pin-grid variants. No unapproved substitutions. Reference unit prices are historical distributor observations, not factory or delivered prices.
PCB fitted component | Panel | SW13, SW14 | 2 | C&K | JS202011CQN | PCBWay turnkey quotation | 401-2001-ND |  |  | AWAITING ITEMIZED FACTORY QUOTE | 0.84 | https://www.digikey.com/en/products/detail/c-k/JS202011CQN/1640097 | THT; Top | METER ENABLE / PROTO 5V OFF / ON (100mA). DPDT through-hole. SW13 selects meter input disconnect/enable; SW14 drives TPS2553-1 EN only and provides manual OFF/ON fault reset. Old relay-coil description is superseded. No unapproved substitutions. Reference unit prices are historical distributor observations, not factory or delivered prices.
PCB fitted component | Panel | K1 | 1 | Panasonic | AQY212EH | PCBWay turnkey quotation | 255-2963-ND |  |  | AWAITING ITEMIZED FACTORY QUOTE | 1.84 | https://www.digikey.com/en/products/detail/panasonic-industry/AQY212EH/512405 | THT; Top | AQY212EH / INPUT DISCONNECT. Order EH through-hole, not EHA surface mount. Stock symbol says AQY280EH but actual selected device is AQY212EH. 2026 manufacturer outline PDFpage7/printed6 visually checked; final board clearance must use maximum body dimensions. No unapproved substitutions. Reference unit prices are historical distributor observations, not factory or delivered prices.
PCB fitted component | Panel | U1 | 1 | Microchip | MCP23017-E/SP | PCBWay turnkey quotation | MCP23017-E/SP-ND |  |  | AWAITING ITEMIZED FACTORY QUOTE | 1.69 | https://www.digikey.com/en/products/detail/microchip-technology/MCP23017-E-SP/894272 | THT; Top | MCP23017-E/SP / 0x20. Current DS20001952D: GPA7/GPB7 are output-only and NC in corrected panel. Firmware must use IODIRA/B0x7F and zero output latches. LCD_VIO_PRESENT/BB_FAULT are direct ESP GPIO6/7 through panelJ12/revisedHATJ4, not expander inputs. Exact SP28package/pin1 required; physical assembly/test remains pending. No unapproved substitutions. Reference unit prices are historical distributor observations, not factory or delivered prices.
PCB fitted component | Panel | U2 | 1 | Microchip | MCP3202-BI/P | PCBWay turnkey quotation | MCP3202-BI/P-ND |  |  | AWAITING ITEMIZED FACTORY QUOTE | 4.12 | https://www.digikey.com/en/products/detail/microchip-technology/MCP3202-BI-P/319431 | THT; Top | MCP3202-BI/P. Match exact suffix/package and pin1. U4 pin1GND/pin2VOUT/pin3VIN; mount per actual component markings, not generic transistor pinout. IC socket procurement/added height is optional and excluded. No unapproved substitutions. Reference unit prices are historical distributor observations, not factory or delivered prices.
PCB fitted component | Panel | U3 | 1 | Microchip | MCP6002-I/P | PCBWay turnkey quotation | MCP6002-I/P-ND |  |  | AWAITING ITEMIZED FACTORY QUOTE | 0.45 | https://www.digikey.com/en/products/detail/microchip-technology/MCP6002-I-P/500875 | THT; Top | MCP6002-I/P. Match exact suffix/package and pin1. U4 pin1GND/pin2VOUT/pin3VIN; mount per actual component markings, not generic transistor pinout. IC socket procurement/added height is optional and excluded. No unapproved substitutions. Reference unit prices are historical distributor observations, not factory or delivered prices.
PCB fitted component | Panel | U4 | 1 | Microchip | MCP1525-I/TO | PCBWay turnkey quotation | MCP1525-I/TO-ND |  |  | AWAITING ITEMIZED FACTORY QUOTE | 1.15 | https://www.digikey.com/en/products/detail/microchip-technology/MCP1525-I-TO/443708 | THT; Top | MCP1525-I/TO. Match exact suffix/package and pin1. U4 pin1GND/pin2VOUT/pin3VIN; mount per actual component markings, not generic transistor pinout. IC socket procurement/added height is optional and excluded. No unapproved substitutions. Reference unit prices are historical distributor observations, not factory or delivered prices.
PCB fitted component | Panel | R1, R2, R3, R4, R5, R6, R7, R8, R17, R18, R31, R40, R41, R46, R47, R48, R58, R60, R68, R70, R71, R74, R75 | 23 | Yageo | MFR-12FRF52-10K | PCBWay turnkey quotation | 13-MFR-12FRF52-10KCT-ND |  |  | AWAITING ITEMIZED FACTORY QUOTE | 0.038 | https://www.digikey.com/en/products/detail/yageo/MFR-12FRF52-10K/9133128 | THT; Top | 10k. 1%,1/6W,100ppm/K; replaces MRS16 only at ordinary logic resistors, never precision R52–R54. At5.25V the1k dissipation27.6mW is below1/6W. Final placement envelopes must use MFR12 maximum, not the smaller old MRS16 body. No unapproved substitutions. Reference unit prices are historical distributor observations, not factory or delivered prices.
PCB fitted component | Panel | R9, R10, R11, R12, R13, R14, R15, R16, R19, R20, R49, R50, R51, R55, R61, R72 | 16 | Yageo | MFR-12FRF52-1K | PCBWay turnkey quotation | 13-MFR-12FRF52-1KCT-ND |  |  | AWAITING ITEMIZED FACTORY QUOTE | 0.038 | https://www.digikey.com/en/products/detail/yageo/MFR-12FRF52-1K/9133248 | THT; Top | 1k. 1%,1/6W,100ppm/K; replaces MRS16 only at ordinary logic resistors, never precision R52–R54. At5.25V the1k dissipation27.6mW is below1/6W. Final placement envelopes must use MFR12 maximum, not the smaller old MRS16 body. No unapproved substitutions. Reference unit prices are historical distributor observations, not factory or delivered prices.
PCB fitted component | Panel | R42, R69, R76, R77, R78, R79, R80, R81 | 8 | Yageo | MFR-12FRF52-100K | PCBWay turnkey quotation | 13-MFR-12FRF52-100KCT-ND |  |  | AWAITING ITEMIZED FACTORY QUOTE | 0.038 | https://www.digikey.com/en/products/detail/yageo/MFR-12FRF52-100K/9133120 | THT; Top | 100k. 1%,1/6W,100ppm/K; replaces MRS16 only at ordinary logic resistors, never precision R52–R54. At5.25V the1k dissipation27.6mW is below1/6W. Final placement envelopes must use MFR12 maximum, not the smaller old MRS16 body. No unapproved substitutions. Reference unit prices are historical distributor observations, not factory or delivered prices.
PCB fitted component | Panel | R43 | 1 | Vishay | MRS16000C2202FCT00 | PCBWay turnkey quotation | BC4551CT-ND |  |  | AWAITING ITEMIZED FACTORY QUOTE | 0.10 | https://www.digikey.com/en/products/detail/vishay-beyschlag-draloric-bc-components/MRS16000C2202FCT00/7350457 | THT; Top | 22k. 1%,0.4W,50ppm/K. Smaller body than existing DIN0207 outline; P7.62 exceeds specified Mmin5.0. Primary does not state lead diameter maximum, so do not claim fully bounded lead tolerance. Cut tape only; groups>=10 priced at quantity10 break. Exact values unchanged. No unapproved substitutions. Reference unit prices are historical distributor observations, not factory or delivered prices.
PCB fitted component | Panel | R44, R45, R73 | 3 | Vishay | MRS16000C4701FCT00 | PCBWay turnkey quotation | BC3940CT-ND |  |  | AWAITING ITEMIZED FACTORY QUOTE | 0.21 | https://www.digikey.com/en/products/detail/vishay-beyschlag-draloric-bc-components/MRS16000C4701FCT00/5063896 | THT; Top | 4.7k. 1%,0.4W,50ppm/K. Smaller body than existing DIN0207 outline; P7.62 exceeds specified Mmin5.0. Primary does not state lead diameter maximum, so do not claim fully bounded lead tolerance. Cut tape only; groups>=10 priced at quantity10 break. Exact values unchanged. No unapproved substitutions. Reference unit prices are historical distributor observations, not factory or delivered prices.
PCB fitted component | Panel | R67 | 1 | Yageo | MFR-25FBF52-210K | PCBWay turnkey quotation | 210KXBK-ND |  |  | AWAITING ITEMIZED FACTORY QUOTE | 0.10 | https://www.digikey.com/en/products/detail/yageo/MFR-25FBF52-210K/13551 | THT; Top | 210k / 1%. 210k1% sets TPS2553-1 current limit; not a precision meter-divider resistor. No unapproved substitutions. Reference unit prices are historical distributor observations, not factory or delivered prices.
PCB fitted component | Panel | C32 | 1 | Panasonic | EEU-FR1C101 | PCBWay turnkey quotation | P14391-ND |  |  | AWAITING ITEMIZED FACTORY QUOTE | 0.41 | https://www.digikey.com/en/products/detail/panasonic-industry/EEU-FR1C101/2433525 | THT; Top | 100u / 16V. 100uF16V input bulk; polarity positive PI_5V_IN/pad1, negative GND/pad2. Supplements module ceramic input capacitor; does not establish Pi power headroom. No unapproved substitutions. Reference unit prices are historical distributor observations, not factory or delivered prices.
PCB fitted component | Panel | U5 | 1 | Texas Instruments | TPS2553DBVR-1 | PCBWay turnkey quotation | 296-39380-1-ND |  |  | AWAITING ITEMIZED FACTORY QUOTE | 1.06 | https://www.digikey.com/en/products/detail/texas-instruments/TPS2553DBVR-1/2047901 | SMT; Top | TPS2553DBVR-1 / LATCH OFF. Exact -1 suffix required for latch-off, active-high EN;1IN2GND3EN4FAULT5ILIM6OUT. One small surface-mount assembly operation. No unapproved substitutions. Reference unit prices are historical distributor observations, not factory or delivered prices.
PCB fitted component | Panel | U6 | 1 | Adafruit | 4683 | PCBWay turnkey quotation | 1528-4683-ND |  |  | AWAITING ITEMIZED FACTORY QUOTE | 5.95 | https://www.digikey.com/en/products/detail/adafruit-industries-llc/4683/12822323 | THT module/manual; Top | Adafruit 4683 3V3 BUCK. Header1GND2OUT3V3 3VIN4EN(NC) when carrier numbered physical left-to-right. Maker explicitly includes header: no separate U6 header purchase. Feed HAT BOARD_3V3 only with AP2112 U3 DNP/removed; never parallel regulators. INSTALL COMPLETE ASSEMBLED MODULE, not bare MPM3610 IC or only four-pin header. Observe pin order GND, OUT, VIN, EN. Confirm module envelope/orientation before soldering. No unapproved substitutions. Reference unit prices are historical distributor observations, not factory or delivered prices.
PCB fitted component | Panel | U8, U9, U10 | 3 | Texas Instruments | SN74LV125AN | PCBWay turnkey quotation | 296-34037-5-ND |  |  | AWAITING ITEMIZED FACTORY QUOTE | 0.95 | https://www.digikey.com/en/products/detail/texas-instruments/SN74LV125AN/1594902 | THT; Top | SN74LV125AN. Buy exact actual Value part, not the generic KiCad symbol family. Stock DIP14 geometry only. LCD-domain LV125 must use actual LCD_VIO tap; Schmitt inverter remains host-powered. Physical power-sequence and signal tests required. No unapproved substitutions. Reference unit prices are historical distributor observations, not factory or delivered prices.
PCB fitted component | Panel | U11 | 1 | Texas Instruments | SN74AHC14N | PCBWay turnkey quotation | 296-4550-5-ND |  |  | AWAITING ITEMIZED FACTORY QUOTE | 0.88 | https://www.digikey.com/en/products/detail/texas-instruments/SN74AHC14N/13490337 | THT; Top | SN74AHC14N. Buy exact actual Value part, not the generic KiCad symbol family. Stock DIP14 geometry only. LCD-domain LV125 must use actual LCD_VIO tap; Schmitt inverter remains host-powered. Physical power-sequence and signal tests required. No unapproved substitutions. Reference unit prices are historical distributor observations, not factory or delivered prices.
PCB fitted component | Panel | J3, J4, J9, J10, J11, J12, J13 | 7 | Sullins Connector Solutions | PRPC002SAAN-RC | PCBWay turnkey quotation |  |  |  | AWAITING ITEMIZED FACTORY QUOTE |  | https://mm.digikey.com/Volume0/opasdata/d220001/medias/docus/386/xRxCzzzSxxN-RC_ST_11635-B.pdf | THT; Top | 2-position 2.54mm single-row male vertical header. Factory source exact-length part or cut same PRPC040SAAN-RC stock. Quantity means fitted connector pieces, not 40-pin strips. Use cut list. No unapproved family substitution. Reference unit prices are historical distributor observations, not factory or delivered prices.
PCB fitted component | Panel | J7, J8 | 2 | Sullins Connector Solutions | PRPC003SAAN-RC | PCBWay turnkey quotation |  |  |  | AWAITING ITEMIZED FACTORY QUOTE |  | https://mm.digikey.com/Volume0/opasdata/d220001/medias/docus/386/xRxCzzzSxxN-RC_ST_11635-B.pdf | THT; Top | 3-position 2.54mm single-row male vertical header. Factory source exact-length part or cut same PRPC040SAAN-RC stock. Quantity means fitted connector pieces, not 40-pin strips. Use cut list. No unapproved family substitution. Reference unit prices are historical distributor observations, not factory or delivered prices.
PCB fitted component | Panel | J1, J5, J6 | 3 | Sullins Connector Solutions | PRPC006SAAN-RC | PCBWay turnkey quotation |  |  |  | AWAITING ITEMIZED FACTORY QUOTE |  | https://mm.digikey.com/Volume0/opasdata/d220001/medias/docus/386/xRxCzzzSxxN-RC_ST_11635-B.pdf | THT; Top | 6-position 2.54mm single-row male vertical header. Factory source exact-length part or cut same PRPC040SAAN-RC stock. Quantity means fitted connector pieces, not 40-pin strips. Use cut list. No unapproved family substitution. Reference unit prices are historical distributor observations, not factory or delivered prices.
PCB fitted component | Panel | J2 | 1 | Sullins Connector Solutions | PRPC011SAAN-RC | PCBWay turnkey quotation |  |  |  | AWAITING ITEMIZED FACTORY QUOTE |  | https://mm.digikey.com/Volume0/opasdata/d220001/medias/docus/386/xRxCzzzSxxN-RC_ST_11635-B.pdf | THT; Top | 11-position 2.54mm single-row male vertical header. Factory source exact-length part or cut same PRPC040SAAN-RC stock. Quantity means fitted connector pieces, not 40-pin strips. Use cut list. No unapproved family substitution. Reference unit prices are historical distributor observations, not factory or delivered prices.
PCB fitted component | Matching HAT | J11 | 1 | Phoenix Contact | 1715747 | PCBWay turnkey quotation | 277-1265-ND |  |  | AWAITING ITEMIZED FACTORY QUOTE | 2.28 |  | THT; Top | 4-position 5.08 mm terminal. ONE terminal on this HAT; no separate extension board in this quotation. Carried-forward exact selection; assembler must confirm land pattern, availability and orientation. No unapproved substitutions. Reference unit prices are historical distributor observations, not factory or delivered prices. Separate HAT project/order: reconcile variant before purchase.
PCB fitted component | Matching HAT | J9 | 1 | Phoenix Contact | 1715721 | PCBWay turnkey quotation | 277-1263-ND |  |  | AWAITING ITEMIZED FACTORY QUOTE | 1.16 |  | THT; Top | 2-position 5.08 mm terminal. Servo supply inlet Carried-forward exact selection; assembler must confirm land pattern, availability and orientation. No unapproved substitutions. Reference unit prices are historical distributor observations, not factory or delivered prices. Separate HAT project/order: reconcile variant before purchase.
PCB fitted component | Matching HAT | J10 | 1 | Samtec | SSW-104-01-G-S | PCBWay turnkey quotation | 612-SSW-104-01-G-S-ND |  |  | AWAITING ITEMIZED FACTORY QUOTE | 1.11 |  | THT; Top | 4-position 2.54mm female power/I2C socket. Pin1 GND, pin2 BOARD_3V3, pins3/4 reserved I2C. Panel power pair uses pins1/2. No extra OLED purchased. Carried-forward exact selection; assembler must confirm land pattern, availability and orientation. No unapproved substitutions. Reference unit prices are historical distributor observations, not factory or delivered prices. Separate HAT project/order: reconcile variant before purchase.
PCB fitted component | Matching HAT | C3 | 1 | Panasonic | EEU-FR1A471 | PCBWay turnkey quotation | P124219-ND |  |  | AWAITING ITEMIZED FACTORY QUOTE | 0.71 |  | THT; Top | 470uF 10V radial 3.50mm pitch. Polarized Carried-forward exact selection; assembler must confirm land pattern, availability and orientation. No unapproved substitutions. Reference unit prices are historical distributor observations, not factory or delivered prices. Separate HAT project/order: reconcile variant before purchase.
PCB fitted component | Matching HAT | F1 | 1 | Keystone Electronics | 3568 | PCBWay turnkey quotation | 36-3568-ND |  |  | AWAITING ITEMIZED FACTORY QUOTE | 1.31 |  | THT; Top | PCB MINI blade fuse holder. SEPARATE from F986-ND fuse. Matches PCB F1 footprint. Carried-forward exact selection; assembler must confirm land pattern, availability and orientation. No unapproved substitutions. Reference unit prices are historical distributor observations, not factory or delivered prices. Separate HAT project/order: reconcile variant before purchase.
PCB fitted component | Matching HAT | J1 | 1 | Adafruit | 1979 | PCBWay turnkey quotation | 1528-1783-ND |  |  | AWAITING ITEMIZED FACTORY QUOTE | 2.95 |  | THT; Bottom | Raspberry Pi extra-tall 40-pin stacking socket. Do not use 1979 as DigiKey SKU; check underside geometry Carried-forward exact selection; assembler must confirm land pattern, availability and orientation. No unapproved substitutions. Reference unit prices are historical distributor observations, not factory or delivered prices. Separate HAT project/order: reconcile variant before purchase.
PCB fitted component | Matching HAT | J8 | 1 | GCT | USB4105-GF-A | PCBWay turnkey quotation | 2073-USB4105-GF-ACT-ND |  |  | AWAITING ITEMIZED FACTORY QUOTE | 0.80 |  | Hybrid (SMT contacts + THT shell); Top | USB-C 16-pin right-angle connector. Custom land pattern mechanical check required SMT signal pads and plated through-hole shield tabs; solder both. Do not treat mounting holes as SMT contacts. Carried-forward exact selection; assembler must confirm land pattern, availability and orientation. No unapproved substitutions. Reference unit prices are historical distributor observations, not factory or delivered prices. Separate HAT project/order: reconcile variant before purchase.
PCB fitted component | Matching HAT | C4 | 1 | Samsung | CL31A226KPHNNNE | PCBWay turnkey quotation | 1276-1287-1-ND |  |  | AWAITING ITEMIZED FACTORY QUOTE | 0.47 |  | SMT; Top | 22uF 10V X5R 1206. Verify cut-tape suffix against DigiKey page before purchase Carried-forward exact selection; assembler must confirm land pattern, availability and orientation. No unapproved substitutions. Reference unit prices are historical distributor observations, not factory or delivered prices. Separate HAT project/order: reconcile variant before purchase.
PCB fitted component | Matching HAT | C5 | 1 | Samsung | CL21B104KBCNNNC | PCBWay turnkey quotation | 1276-1003-1-ND |  |  | AWAITING ITEMIZED FACTORY QUOTE | 0.10 |  | SMT; Top | 100nF 50V X7R 0805. Verify cut-tape suffix against DigiKey page before purchase Carried-forward exact selection; assembler must confirm land pattern, availability and orientation. No unapproved substitutions. Reference unit prices are historical distributor observations, not factory or delivered prices. Separate HAT project/order: reconcile variant before purchase.
PCB fitted component | Matching HAT | R3 | 1 | Yageo | RC0805FR-0710KL | PCBWay turnkey quotation | 311-10.0KCRCT-ND |  |  | AWAITING ITEMIZED FACTORY QUOTE | 0.10 |  | SMT; Top | 10k 1% 0805 resistors. Replace reel SKU; verify exact CT SKU Carried-forward exact selection; assembler must confirm land pattern, availability and orientation. No unapproved substitutions. Reference unit prices are historical distributor observations, not factory or delivered prices. Separate HAT project/order: reconcile variant before purchase.
PCB fitted component | Matching HAT | R4 | 1 | Yageo | RC0805FR-0710KL | PCBWay turnkey quotation | 311-10.0KCRCT-ND |  |  | AWAITING ITEMIZED FACTORY QUOTE | 0.10 |  | SMT; Top | 10k 1% 0805 resistors. Replace reel SKU; verify exact CT SKU Carried-forward exact selection; assembler must confirm land pattern, availability and orientation. No unapproved substitutions. Reference unit prices are historical distributor observations, not factory or delivered prices. Separate HAT project/order: reconcile variant before purchase.
PCB fitted component | Matching HAT | R12 | 1 | Yageo | RC0805FR-0710KL | PCBWay turnkey quotation | 311-10.0KCRCT-ND |  |  | AWAITING ITEMIZED FACTORY QUOTE | 0.10 |  | SMT; Top | 10k 1% 0805 resistors. Replace reel SKU; verify exact CT SKU Carried-forward exact selection; assembler must confirm land pattern, availability and orientation. No unapproved substitutions. Reference unit prices are historical distributor observations, not factory or delivered prices. Separate HAT project/order: reconcile variant before purchase.
PCB fitted component | Matching HAT | R13 | 1 | Yageo | RC0805FR-0710KL | PCBWay turnkey quotation | 311-10.0KCRCT-ND |  |  | AWAITING ITEMIZED FACTORY QUOTE | 0.10 |  | SMT; Top | 10k 1% 0805 resistors. Replace reel SKU; verify exact CT SKU Carried-forward exact selection; assembler must confirm land pattern, availability and orientation. No unapproved substitutions. Reference unit prices are historical distributor observations, not factory or delivered prices. Separate HAT project/order: reconcile variant before purchase.
PCB fitted component | Matching HAT | R14 | 1 | Yageo | RC0805FR-074K7L | PCBWay turnkey quotation | 311-4.70KCRCT-ND |  |  | AWAITING ITEMIZED FACTORY QUOTE | 0.10 |  | SMT; Top | 4.7k 1% 0805 resistors. Replace reel SKU; verify exact CT SKU Carried-forward exact selection; assembler must confirm land pattern, availability and orientation. No unapproved substitutions. Reference unit prices are historical distributor observations, not factory or delivered prices. Separate HAT project/order: reconcile variant before purchase.
PCB fitted component | Matching HAT | R15 | 1 | Yageo | RC0805FR-074K7L | PCBWay turnkey quotation | 311-4.70KCRCT-ND |  |  | AWAITING ITEMIZED FACTORY QUOTE | 0.10 |  | SMT; Top | 4.7k 1% 0805 resistors. Replace reel SKU; verify exact CT SKU Carried-forward exact selection; assembler must confirm land pattern, availability and orientation. No unapproved substitutions. Reference unit prices are historical distributor observations, not factory or delivered prices. Separate HAT project/order: reconcile variant before purchase.
PCB fitted component | Matching HAT | R5 | 1 | Bourns | CR0805-FX-5101ELF | PCBWay turnkey quotation | CR0805-FX-5101ELFCT-ND |  |  | AWAITING ITEMIZED FACTORY QUOTE | 0.10 |  | SMT; Top | 5.1k 1% 0805 resistors. USB-C CC pulldowns Carried-forward exact selection; assembler must confirm land pattern, availability and orientation. No unapproved substitutions. Reference unit prices are historical distributor observations, not factory or delivered prices. Separate HAT project/order: reconcile variant before purchase.
PCB fitted component | Matching HAT | R6 | 1 | Bourns | CR0805-FX-5101ELF | PCBWay turnkey quotation | CR0805-FX-5101ELFCT-ND |  |  | AWAITING ITEMIZED FACTORY QUOTE | 0.10 |  | SMT; Top | 5.1k 1% 0805 resistors. USB-C CC pulldowns Carried-forward exact selection; assembler must confirm land pattern, availability and orientation. No unapproved substitutions. Reference unit prices are historical distributor observations, not factory or delivered prices. Separate HAT project/order: reconcile variant before purchase.
PCB fitted component | Matching HAT | R7 | 1 | Yageo | RC0805FR-0722RL | PCBWay turnkey quotation | 311-22.0CRCT-ND |  |  | AWAITING ITEMIZED FACTORY QUOTE | 0.10 |  | SMT; Top | 22 ohm 1% 0805 resistors. Verify exact cut-tape DigiKey code Carried-forward exact selection; assembler must confirm land pattern, availability and orientation. No unapproved substitutions. Reference unit prices are historical distributor observations, not factory or delivered prices. Separate HAT project/order: reconcile variant before purchase.
PCB fitted component | Matching HAT | R8 | 1 | Yageo | RC0805FR-0722RL | PCBWay turnkey quotation | 311-22.0CRCT-ND |  |  | AWAITING ITEMIZED FACTORY QUOTE | 0.10 |  | SMT; Top | 22 ohm 1% 0805 resistors. Verify exact cut-tape DigiKey code Carried-forward exact selection; assembler must confirm land pattern, availability and orientation. No unapproved substitutions. Reference unit prices are historical distributor observations, not factory or delivered prices. Separate HAT project/order: reconcile variant before purchase.
PCB fitted component | Matching HAT | R9 | 1 | Yageo | RC0805FR-071KL | PCBWay turnkey quotation | 311-1.00KCRCT-ND |  |  | AWAITING ITEMIZED FACTORY QUOTE | 0.10 |  | SMT; Top | 1k 1% 0805 resistor. Verify exact cut-tape DigiKey code Carried-forward exact selection; assembler must confirm land pattern, availability and orientation. No unapproved substitutions. Reference unit prices are historical distributor observations, not factory or delivered prices. Separate HAT project/order: reconcile variant before purchase.
PCB fitted component | Matching HAT | D1 | 1 | Lite-On | LTST-C170KGKT | PCBWay turnkey quotation | 160-1414-1-ND |  |  | AWAITING ITEMIZED FACTORY QUOTE | 0.19 |  | SMT; Top | Green 0805 LED. Verify CT suffix, polarity Carried-forward exact selection; assembler must confirm land pattern, availability and orientation. No unapproved substitutions. Reference unit prices are historical distributor observations, not factory or delivered prices. Separate HAT project/order: reconcile variant before purchase.
PCB fitted component | Matching HAT | SW1 | 1 | E-Switch | TL3305AF160QG | PCBWay turnkey quotation | EG5350CT-ND |  |  | AWAITING ITEMIZED FACTORY QUOTE | 0.21 |  | SMT; Top | SMD tactile switch TL3305A. Verify exact cut-tape SKU and footprint Carried-forward exact selection; assembler must confirm land pattern, availability and orientation. No unapproved substitutions. Reference unit prices are historical distributor observations, not factory or delivered prices. Separate HAT project/order: reconcile variant before purchase.
PCB fitted component | Matching HAT | RESET1 | 1 | E-Switch | TL3305AF160QG | PCBWay turnkey quotation | EG5350CT-ND |  |  | AWAITING ITEMIZED FACTORY QUOTE | 0.21 |  | SMT; Top | SMD tactile switch TL3305A. Verify exact cut-tape SKU and footprint Carried-forward exact selection; assembler must confirm land pattern, availability and orientation. No unapproved substitutions. Reference unit prices are historical distributor observations, not factory or delivered prices. Separate HAT project/order: reconcile variant before purchase.
PCB fitted component | Matching HAT | U2 | 1 | Espressif | ESP32-S3-WROOM-1-N8R8 | PCBWay turnkey quotation | 5407-ESP32-S3-WROOM-1-N8R8CT-ND |  |  | AWAITING ITEMIZED FACTORY QUOTE | 6.28 | https://www.digikey.com/en/products/detail/espressif-systems/ESP32-S3-WROOM-1-N8R8/15295891 | SMT; Top | ESP32-S3-WROOM-1-N8R8 8MB PSRAM module. Mouser part 356-EP32S3WROOM1N8R8. https://www.mouser.com/en/ProductDetail/Espressif-Systems/ESP32-S3-WROOM-1-N8R8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 Exact ESP32-S3-WROOM-1-N8R8, 8MB flash and 8MB PSRAM, PCB antenna. Other parts remain on DigiKey purchasing list. Unit quote $6.28, shipping/tax/tariffs excluded. SMT module with exposed GND pad41 and open 0.30mm thermal vias; assembler must review stencil/paste-wicking process. Carried-forward exact selection; assembler must confirm land pattern, availability and orientation. No unapproved substitutions. Reference unit prices are historical distributor observations, not factory or delivered prices. Separate HAT project/order: reconcile variant before purchase.
PCB fitted component | Matching HAT | C2 | 1 | Samsung | CL21A105KBCLNNC | PCBWay turnkey quotation | 1276-2396-1-ND |  |  | AWAITING ITEMIZED FACTORY QUOTE | 0.18 |  | SMT; Top | 1uF 50V X5R 0805; C7 absent, do not install. Carried-forward exact selection; assembler must confirm land pattern, availability and orientation. No unapproved substitutions. Reference unit prices are historical distributor observations, not factory or delivered prices. Separate HAT project/order: reconcile variant before purchase.
PCB fitted component | Matching HAT | C8 | 1 | Samsung | CL21A105KBCLNNC | PCBWay turnkey quotation | 1276-2396-1-ND |  |  | AWAITING ITEMIZED FACTORY QUOTE | 0.18 |  | SMT; Top | 1uF 50V X5R 0805; C7 absent, do not install. Carried-forward exact selection; assembler must confirm land pattern, availability and orientation. No unapproved substitutions. Reference unit prices are historical distributor observations, not factory or delivered prices. Separate HAT project/order: reconcile variant before purchase.
PCB fitted component | Matching HAT | U3 | 1 | Texas Instruments | SN74LVC1G17DBVR | PCBWay turnkey quotation | 296-11933-1-ND |  |  | AWAITING ITEMIZED FACTORY QUOTE | 0.15 | https://www.digikey.com/en/products/detail/texas-instruments/SN74LVC1G17DBVR/389051 | SMT; Top | SN74LVC1G17DBVR. U3 is a signal buffer on this revised PCB, never AP2112. Carried-forward exact selection; assembler must confirm land pattern, availability and orientation. No unapproved substitutions. Reference unit prices are historical distributor observations, not factory or delivered prices. Separate HAT project/order: reconcile variant before purchase.
PCB fitted component | Matching HAT | U4, U5 | 2 | Texas Instruments | SN74LVC1G17DBVR | PCBWay turnkey quotation | 296-11933-1-ND |  |  | AWAITING ITEMIZED FACTORY QUOTE | 0.15 | https://www.digikey.com/en/products/detail/texas-instruments/SN74LVC1G17DBVR/389051 | SMT; Bottom | SN74LVC1G17DBVR. U3 is a signal buffer on this revised PCB, never AP2112. Carried-forward exact selection; assembler must confirm land pattern, availability and orientation. No unapproved substitutions. Reference unit prices are historical distributor observations, not factory or delivered prices. Separate HAT project/order: reconcile variant before purchase.
PCB fitted component | Matching HAT | C9 | 1 | KEMET | C0805C104K5RACTU | PCBWay turnkey quotation | 399-C0805C104K5RACTUCT-ND |  |  | AWAITING ITEMIZED FACTORY QUOTE | 0.18 | https://www.digikey.com/en/products/detail/kemet/C0805C104K5RACTU/411169 | SMT; Top | 100nF +/-10%, 50V X7R, 0805. Carried-forward exact selection; assembler must confirm land pattern, availability and orientation. No unapproved substitutions. Reference unit prices are historical distributor observations, not factory or delivered prices. Separate HAT project/order: reconcile variant before purchase.
PCB fitted component | Matching HAT | C10, C11 | 2 | KEMET | C0805C104K5RACTU | PCBWay turnkey quotation | 399-C0805C104K5RACTUCT-ND |  |  | AWAITING ITEMIZED FACTORY QUOTE | 0.18 | https://www.digikey.com/en/products/detail/kemet/C0805C104K5RACTU/411169 | SMT; Bottom | 100nF +/-10%, 50V X7R, 0805. Carried-forward exact selection; assembler must confirm land pattern, availability and orientation. No unapproved substitutions. Reference unit prices are historical distributor observations, not factory or delivered prices. Separate HAT project/order: reconcile variant before purchase.
PCB fitted component | Matching HAT | R16, R17, R20, R21, R22, R23 | 6 | Yageo | RC0805FR-07100KL | PCBWay turnkey quotation | 311-100KCRCT-ND |  |  | AWAITING ITEMIZED FACTORY QUOTE | 0.034 | https://www.digikey.com/en/products/detail/yageo/RC0805FR-07100KL/730491 | SMT; Bottom | 100kohm +/-1%, 1/8W, 0805. Carried-forward exact selection; assembler must confirm land pattern, availability and orientation. No unapproved substitutions. Reference unit prices are historical distributor observations, not factory or delivered prices. Separate HAT project/order: reconcile variant before purchase.
PCB fitted component | Matching HAT | R11 | 1 | Yageo | RC0805FR-07100KL | PCBWay turnkey quotation | 311-100KCRCT-ND |  |  | AWAITING ITEMIZED FACTORY QUOTE | 0.034 | https://www.digikey.com/en/products/detail/yageo/RC0805FR-07100KL/730491 | SMT; Top | 100kohm +/-1%, 1/8W, 0805. Carried-forward exact selection; assembler must confirm land pattern, availability and orientation. No unapproved substitutions. Reference unit prices are historical distributor observations, not factory or delivered prices. Separate HAT project/order: reconcile variant before purchase.
PCB fitted component | Matching HAT | R18, R19 | 2 | Yageo | RC0805FR-0733RL | PCBWay turnkey quotation | 311-33.0CRCT-ND |  |  | AWAITING ITEMIZED FACTORY QUOTE | 0.1 | https://www.digikey.com/en/products/detail/yageo/RC0805FR-0733RL/727862 | SMT; Bottom | 33ohm +/-1%, 1/8W, 0805. Carried-forward exact selection; assembler must confirm land pattern, availability and orientation. No unapproved substitutions. Reference unit prices are historical distributor observations, not factory or delivered prices. Separate HAT project/order: reconcile variant before purchase.
PCB fitted component | Matching HAT | J2 | 1 | Sullins Connector Solutions | PRPC003SAAN-RC | PCBWay turnkey quotation |  |  |  | AWAITING ITEMIZED FACTORY QUOTE |  | https://mm.digikey.com/Volume0/opasdata/d220001/medias/docus/386/xRxCzzzSxxN-RC_ST_11635-B.pdf | THT; Top | 3-position 2.54mm male vertical header. Cut same PRPC040SAAN-RC stock to length if necessary. Carried-forward exact selection; assembler must confirm land pattern, availability and orientation. No unapproved substitutions. Reference unit prices are historical distributor observations, not factory or delivered prices. Separate HAT project/order: reconcile variant before purchase.
PCB fitted component | Matching HAT | J3 | 1 | Sullins Connector Solutions | PRPC003SAAN-RC | PCBWay turnkey quotation |  |  |  | AWAITING ITEMIZED FACTORY QUOTE |  | https://mm.digikey.com/Volume0/opasdata/d220001/medias/docus/386/xRxCzzzSxxN-RC_ST_11635-B.pdf | THT; Top | 3-position 2.54mm male vertical header. Cut same PRPC040SAAN-RC stock to length if necessary. Carried-forward exact selection; assembler must confirm land pattern, availability and orientation. No unapproved substitutions. Reference unit prices are historical distributor observations, not factory or delivered prices. Separate HAT project/order: reconcile variant before purchase.
PCB fitted component | Matching HAT | J12 | 1 | Sullins Connector Solutions | PRPC003SAAN-RC | PCBWay turnkey quotation |  |  |  | AWAITING ITEMIZED FACTORY QUOTE |  | https://mm.digikey.com/Volume0/opasdata/d220001/medias/docus/386/xRxCzzzSxxN-RC_ST_11635-B.pdf | THT; Top | 3-position 2.54mm male vertical header. Cut same PRPC040SAAN-RC stock to length if necessary. Carried-forward exact selection; assembler must confirm land pattern, availability and orientation. No unapproved substitutions. Reference unit prices are historical distributor observations, not factory or delivered prices. Separate HAT project/order: reconcile variant before purchase.
PCB fitted component | Matching HAT | J4 | 1 | Sullins Connector Solutions | PRPC006SAAN-RC | PCBWay turnkey quotation |  |  |  | AWAITING ITEMIZED FACTORY QUOTE |  | https://mm.digikey.com/Volume0/opasdata/d220001/medias/docus/386/xRxCzzzSxxN-RC_ST_11635-B.pdf | THT; Top | 6-position 2.54mm male vertical header. Cut same PRPC040SAAN-RC stock to length if necessary. Carried-forward exact selection; assembler must confirm land pattern, availability and orientation. No unapproved substitutions. Reference unit prices are historical distributor observations, not factory or delivered prices. Separate HAT project/order: reconcile variant before purchase.
PCB fitted component | Matching HAT | J5 | 1 | Sullins Connector Solutions | PRPC006SAAN-RC | PCBWay turnkey quotation |  |  |  | AWAITING ITEMIZED FACTORY QUOTE |  | https://mm.digikey.com/Volume0/opasdata/d220001/medias/docus/386/xRxCzzzSxxN-RC_ST_11635-B.pdf | THT; Top | 6-position 2.54mm male vertical header. Cut same PRPC040SAAN-RC stock to length if necessary. Carried-forward exact selection; assembler must confirm land pattern, availability and orientation. No unapproved substitutions. Reference unit prices are historical distributor observations, not factory or delivered prices. Separate HAT project/order: reconcile variant before purchase.
PCB fitted component | Matching HAT | J6 | 1 | Sullins Connector Solutions | PRPC006SAAN-RC | PCBWay turnkey quotation |  |  |  | AWAITING ITEMIZED FACTORY QUOTE |  | https://mm.digikey.com/Volume0/opasdata/d220001/medias/docus/386/xRxCzzzSxxN-RC_ST_11635-B.pdf | THT; Top | 6-position 2.54mm male vertical header. Cut same PRPC040SAAN-RC stock to length if necessary. Carried-forward exact selection; assembler must confirm land pattern, availability and orientation. No unapproved substitutions. Reference unit prices are historical distributor observations, not factory or delivered prices. Separate HAT project/order: reconcile variant before purchase.
PCB fitted component | Matching HAT | J7 | 1 | Sullins Connector Solutions | PRPC006SAAN-RC | PCBWay turnkey quotation |  |  |  | AWAITING ITEMIZED FACTORY QUOTE |  | https://mm.digikey.com/Volume0/opasdata/d220001/medias/docus/386/xRxCzzzSxxN-RC_ST_11635-B.pdf | THT; Top | 6-position 2.54mm male vertical header. Cut same PRPC040SAAN-RC stock to length if necessary. Carried-forward exact selection; assembler must confirm land pattern, availability and orientation. No unapproved substitutions. Reference unit prices are historical distributor observations, not factory or delivered prices. Separate HAT project/order: reconcile variant before purchase.
Off-board part | External | LCD1 | 1 | Waveshare | 16446 | PCBWay turnkey quotation |  |  |  | AWAITING ITEMIZED FACTORY QUOTE |  | https://www.waveshare.com/product/displays/lcd-oled/lcd-oled-2/2.8inch-resistive-touch-lcd.htm | Mechanical/harness assembly, not pick-and-place | 2.8inch Resistive Touch LCD, SPI 320x240. Ask factory to source exact module and identify controller/revision; internal 3V3 tap needs qualification; no substitute Pi/Arduino shield
Off-board part | External | BB1 | 1 | Adafruit | 65 | PCBWay turnkey quotation |  |  |  | AWAITING ITEMIZED FACTORY QUOTE |  | https://www.adafruit.com/product/65 | Mechanical attach in reserved panel area; do not reflow | Tiny Premium Breadboard 46 x 36mm. Ask factory to source; stock not reserved
Off-board part | External | HAT-FUSE | 1 | Littelfuse | 0297002.WXNV | PCBWay turnkey quotation |  |  |  | AWAITING ITEMIZED FACTORY QUOTE |  | https://www.digikey.com/en/products/detail/littelfuse-inc/0297002-WXNV/124900 | Insert into F1 holder; no separate PCB footprint | 2A MINI blade fuse for matching-HAT F1 holder. Carried-forward provisional rating: validate servo stall current before enabling motors; not an independent stop
Conditional peripheral | External | HUB1 | 1 | Raspberry Pi | SC1636 | PCBWay turnkey quotation |  |  |  | AWAITING ITEMIZED FACTORY QUOTE |  | https://www.pishop.us/product/raspberry-pi-usb-3-hub/ | External peripheral, not on panel PCB | Raspberry Pi USB 3 Hub with external USB-C power input. Separately itemized option; do not omit without validating existing bus-powered hub load Quote separately; needed only if actual USB load requires the powered-hub replacement.
Conditional peripheral | External | HUB-PSU | 1 | Raspberry Pi | SC0218 | PCBWay turnkey quotation |  |  |  | AWAITING ITEMIZED FACTORY QUOTE |  | https://www.raspberrypi.com/products/type-c-power-supply/ | External supply, additional to existing Pi official supply | Official USB-C 15.3W 5.1V 3A US power supply for hub. Ask supplier to confirm exact US-plug part code and hub compatibility before purchase; no assumed free spare Quote separately; needed only if actual USB load requires the powered-hub replacement.
Harness / accessory | External | HARNESS-I2C | 1 six-wire cable |  |  | PCBWay turnkey quotation |  |  |  | AWAITING ITEMIZED FACTORY QUOTE |  |  | Factory cable fabrication / assembly quote | Panel J1 pins1..6 to HAT J7 pins1..6; 2.54mm female mating ends. Include mating housings/contacts, insulation and strain relief. Final length/contact specification and quote pending; do not assume supplied free.
Harness / accessory | External | HARNESS-SPI | 1 six-wire cable |  |  | PCBWay turnkey quotation |  |  |  | AWAITING ITEMIZED FACTORY QUOTE |  |  | Factory cable fabrication / assembly quote | Panel J5 pins1..6 to HAT J6 pins1..6; 2.54mm female mating ends; signal-integrity/length review required. Include mating housings/contacts, insulation and strain relief. Final length/contact specification and quote pending; do not assume supplied free.
Harness / accessory | External | HARNESS-CONTROL | 1 six-wire cable |  |  | PCBWay turnkey quotation |  |  |  | AWAITING ITEMIZED FACTORY QUOTE |  |  | Factory cable fabrication / assembly quote | Panel J6 pins1..6 to HAT J5 pins1..6; 2.54mm female mating ends. Include mating housings/contacts, insulation and strain relief. Final length/contact specification and quote pending; do not assume supplied free.
Harness / accessory | External | HARNESS-5V | 1 two-wire cable |  |  | PCBWay turnkey quotation |  |  |  | AWAITING ITEMIZED FACTORY QUOTE |  |  | Factory cable fabrication / assembly quote | Panel J7 pins1/2 to HAT J12 pins1/2; remaining pin3 unconnected. Include mating housings/contacts, insulation and strain relief. Final length/contact specification and quote pending; do not assume supplied free.
Harness / accessory | External | HARNESS-3V3 | 1 two-wire cable |  |  | PCBWay turnkey quotation |  |  |  | AWAITING ITEMIZED FACTORY QUOTE |  |  | Factory cable fabrication / assembly quote | Dedicated short22AWG pair: panel J13.1 GND/J13.2 3V3 to HAT J10.1/J10.2; female panel mating end, male HAT socket mating end. Include mating housings/contacts, insulation and strain relief. Final length/contact specification and quote pending; do not assume supplied free.
Harness / accessory | External | HARNESS-DIAGNOSTIC | 1 two-wire cable |  |  | PCBWay turnkey quotation |  |  |  | AWAITING ITEMIZED FACTORY QUOTE |  |  | Factory cable fabrication / assembly quote | Panel J12 pins1/2 to HAT J4 pins3/4; ESP GPIO6/7; common ground through power/signal harnesses. Include mating housings/contacts, insulation and strain relief. Final length/contact specification and quote pending; do not assume supplied free.
Harness / accessory | External | HARNESS-LCD | 1 eleven-wire cable |  |  | PCBWay turnkey quotation |  |  |  | AWAITING ITEMIZED FACTORY QUOTE |  |  | Factory cable fabrication / assembly quote | Panel J2 pins1..11 to matching Waveshare16446 labelled pins; verify actual display header orientation. Include mating housings/contacts, insulation and strain relief. Final length/contact specification and quote pending; do not assume supplied free.
Harness / accessory | External | HARNESS-LCD-VIO | 1 two-wire cable |  |  | PCBWay turnkey quotation |  |  |  | AWAITING ITEMIZED FACTORY QUOTE |  |  | Factory cable fabrication / assembly quote | Panel J11.1 to actual internal LCD3V3, J11.2 GND; module batch/tap point and solder attachment must be qualified. Include mating housings/contacts, insulation and strain relief. Final length/contact specification and quote pending; do not assume supplied free.
Harness / accessory | External | HARNESS-PROTO | 1 two-wire cable |  |  | PCBWay turnkey quotation |  |  |  | AWAITING ITEMIZED FACTORY QUOTE |  |  | Factory cable fabrication / assembly quote | Panel J10 protected5V/GND to mini breadboard; intended100mA usable load; insulated mating contacts. Include mating housings/contacts, insulation and strain relief. Final length/contact specification and quote pending; do not assume supplied free.
Harness / accessory | External | METER-LEADS | 1 pair |  |  | PCBWay turnkey quotation |  |  |  | AWAITING ITEMIZED FACTORY QUOTE |  |  | Factory cable fabrication / assembly quote | Panel J9 probe+/common GND to insulated voltage-probe leads; known shared-ground0-24V DC only. Include mating housings/contacts, insulation and strain relief. Final length/contact specification and quote pending; do not assume supplied free.
Harness / accessory | External | FAN-ADAPTER | 1 if required |  |  | PCBWay turnkey quotation |  |  |  | AWAITING ITEMIZED FACTORY QUOTE |  |  | Factory cable fabrication / assembly quote | Panel J8 pins1/2 5V/GND to owned5V fan; pin3 unconnected; actual fan connector/current unknown. Include mating housings/contacts, insulation and strain relief. Final length/contact specification and quote pending; do not assume supplied free.
Harness / accessory | External | USB-SERVICE-CABLE | 1 if not owned |  |  | PCBWay turnkey quotation |  |  |  | AWAITING ITEMIZED FACTORY QUOTE |  |  | Factory cable fabrication / assembly quote | USB-A to USB-C DATA cable for matching-HAT service; no panel/HAT operating power through USB. Include mating housings/contacts, insulation and strain relief. Final length/contact specification and quote pending; do not assume supplied free.
Harness / accessory | External | NC-STATUS-CABLES | 2 if fitted |  |  | PCBWay turnkey quotation |  |  |  | AWAITING ITEMIZED FACTORY QUOTE |  |  | Factory cable fabrication / assembly quote | Panel J3 and J4 dry-NC inputs to separately chosen physical contacts; these are status signals, not motor-power cables. Include mating housings/contacts, insulation and strain relief. Final length/contact specification and quote pending; do not assume supplied free.
Mounting / accessory | Mechanical | MOUNT-PI-HAT | 1 set |  |  | PCBWay turnkey quotation |  |  |  | AWAITING ITEMIZED FACTORY QUOTE |  |  | Supplier to confirm actual hardware | Pi-to-HAT mounting hardware, nominal15.5mm socket seating gap; exact standoffs and screw engagement must match installed socket. No enclosure raw material requested.
Mounting / accessory | Mechanical | MOUNT-HAT-PANEL | 1 set |  |  | PCBWay turnkey quotation |  |  |  | AWAITING ITEMIZED FACTORY QUOTE |  |  | Supplier to confirm actual hardware | Mounting stage with30mm CLEAR HAT-front to panel-rear gap; fasteners/insulation/washer clearance per native drawings. No enclosure raw material requested.
Mounting / accessory | Mechanical | MOUNT-LCD | 1 set |  |  | PCBWay turnkey quotation |  |  |  | AWAITING ITEMIZED FACTORY QUOTE |  |  | Supplier to confirm actual hardware | Four LCD mounting positions with25mm spacers; M2.5 hardware, washer/head contact diameter at most5mm; final screw lengths require engagement check. No enclosure raw material requested.
Mounting / accessory | Mechanical | PANEL-SUPPORT | 1 set if required |  |  | PCBWay turnkey quotation |  |  |  | AWAITING ITEMIZED FACTORY QUOTE |  |  | Supplier to confirm actual hardware | Panel outer-corner supports and compatible fasteners; H1-H4 contact diameter at most7mm. No enclosure raw material requested.
Mounting / accessory | Mechanical | BREADBOARD-ATTACH | 1 set if required |  |  | PCBWay turnkey quotation |  |  |  | AWAITING ITEMIZED FACTORY QUOTE |  |  | Supplier to confirm actual hardware | Insulated attachment for Adafruit65 mini breadboard in reserved46x36mm area; confirm included adhesive/support. No enclosure raw material requested.
Unresolved separate system | Arm | INDEPENDENT-STOP-AND-RETENTION | TBD |  |  | PCBWay turnkey quotation |  |  |  | UNPRICED: DESIGN NOT FINALIZED |  |  | Not implemented by screen PCB | Required independent stopping of both motor supplies plus gravity retention for sagging non-base joints. Contact ratings, reset arrangement, mechanics and exact parts remain undefined. Do not represent the software HOLD/NC inputs as this system, or this line as a complete safety design.
Optional external controls | External | NC-STATUS-CONTACTS | 2 if fitted |  |  | PCBWay turnkey quotation |  |  |  | AWAITING ITEMIZED FACTORY QUOTE |  |  | Exact physical switch model not selected | Dry normally-closed contacts for status inputs J3/J4 only. No guarantee of independent arm stopping.
Already owned | External | OWNED-PI4 | 1 |  |  | Already owned; do not repurchase |  |  |  | NO NEW PURCHASE SPECIFIED |  |  | Existing hardware | Actual Raspberry Pi4
Already owned | External | OWNED-PI-PSU | 1 |  |  | Already owned; do not repurchase |  |  |  | NO NEW PURCHASE SPECIFIED |  |  | Existing hardware | Existing official Pi USB-C power supply for Pi
Already owned | External | OWNED-FAN | 1 |  |  | Already owned; do not repurchase |  |  |  | NO NEW PURCHASE SPECIFIED |  |  | Existing hardware | Existing tiny5V fan; connector/current unconfirmed
Already owned | External | OWNED-USB-HUB | 1 |  |  | Already owned; do not repurchase |  |  |  | NO NEW PURCHASE SPECIFIED |  |  | Existing hardware | Existing7-port bus-powered USB hub; total-load adequacy unverified
Fabrication service | Panel | PANEL-BARE-PCB | 5 |  | szscreen.kicad_pcb rev23 | PCBWay turnkey quotation |  |  | 48.31 | USER SCREENSHOT PRELIMINARY CALCULATOR |  | quotes/pcbway/preliminary-calculator.png | 160x120mm,2layer,1.6mm requested | Only quantity/subtotal visible in supplied crop. Dimensions, finish and uploaded files are not verified from this screenshot.
Assembly service | Panel | PANEL-ASSEMBLY | 1 |  |  | PCBWay turnkey quotation |  | 29.00 | 29.00 | USER SCREENSHOT PRELIMINARY CALCULATOR; COMPONENTS EXCLUDED |  | quotes/pcbway/preliminary-calculator.png | Mixed THT/SMT, both sides requested | Factory still needs full BOM and manual-process review. Fee alone does not purchase components.
Fabrication service | Matching HAT | HAT-BARE-PCB | TBD factory minimum |  | matching-HAT/test1.kicad_pcb rev23 | PCBWay turnkey quotation |  |  |  | AWAITING ITEMIZED FACTORY QUOTE |  |  | Separate conditional project/order | Not priced in panel screenshot; original submitted HAT is a different revision; avoid duplicate purchase.
Assembly service | Matching HAT | HAT-ASSEMBLY | 1 |  |  | PCBWay turnkey quotation |  |  |  | AWAITING ITEMIZED FACTORY QUOTE |  |  | Separate conditional project/order | Not priced in panel screenshot; need full matching-HAT48part BOM and both-side assembly review.
Delivery | Order | SHIPPING | 1 |  |  | PCBWay turnkey quotation |  |  | 24.07 | USER SCREENSHOT PRELIMINARY CALCULATOR |  | quotes/pcbway/preliminary-calculator.png |  | Global Standard toUnited States; screenshot7-12business days. Exact delivered scope/address/taxes not verified.
Discount | Order | ORDER-DISCOUNT | 1 |  |  | PCBWay turnkey quotation |  |  | -24.07 | USER SCREENSHOT PRELIMINARY DISCOUNT; NOT GUARANTEED |  | quotes/pcbway/preliminary-calculator.png |  | Shown discount cancels displayed shipping at this stage only. Do not assume it survives final quote.
Tax / import charges | Order | TAX-AND-IMPORT | TBD |  |  | PCBWay turnkey quotation |  |  |  | AWAITING ITEMIZED FACTORY QUOTE |  |  | Supplier/final checkout confirmation required | Screenshot explicitly excludes customs duties and VAT; California sales tax and any other applicable charges are not verified. Do not enter zero.
