gmaxdragon/Seizo-Screen/matching-HAT/HAT-board-only.step

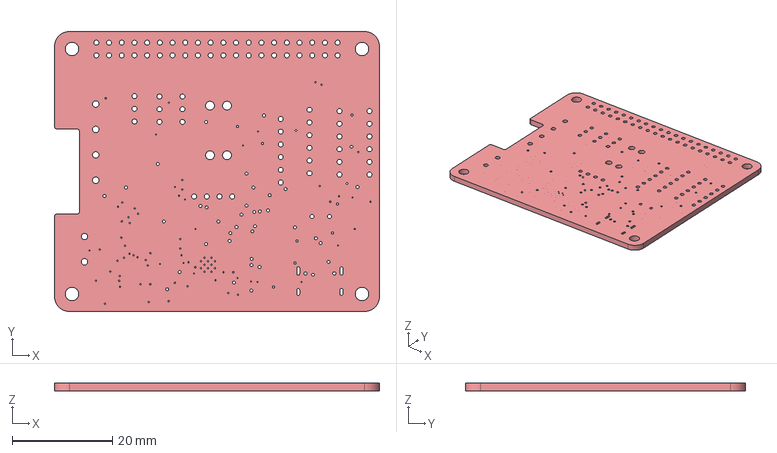
[picture p6: CAD file, 2026-10-31]
matching-HAT/HAT-board-only.step
65.0 x 56.0 x 1.51 mm
