gmaxdragon/Seizo-Screen/szscreen-board-only.step

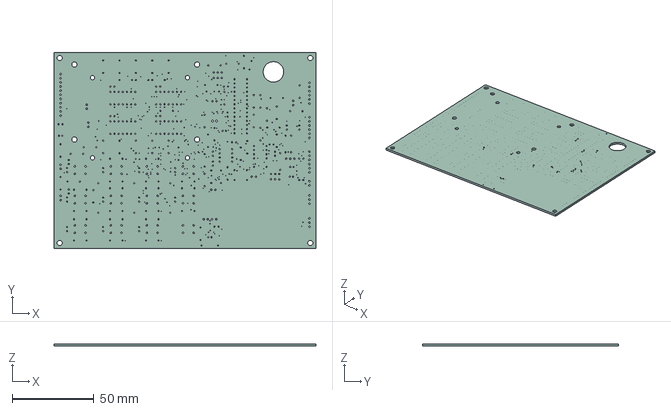
[picture p7: CAD file, 2026-10-31]
szscreen-board-only.step
160.0 x 120.0 x 1.51 mm
