gmaxdragon/Seizo-Screen/FABRICATION-STATUS.txt

SEIZO SCREEN / szscreen / REVISION 23 — 31 OCTOBER 2026
Engineering fabrication candidate for a first prototype. No submission or purchase has been made.

Completed: full panel routing, filled power/ground copper, mounting screw copper exclusions,
unused stub removal, readable silkscreen references and clipping of the user's original logo.
The matching HAT variant is also routed. Panel source SHA256: dc71ca834294d30f3ec7e10e9b64247c323a675e326a986edd0421b6df838665
Schematic SHA256: 00b0232ac88141a0f924fc1a8a86d4491a3e424eb22347c2f8611407ca18b50f

Panel native KiCad 10.0.7: 0 DRC errors, 0 unconnected, 0 schematic parity issues.
3 warnings remain: intentional stock-footprint local overrides U4, D2 and D3.
U4 has 1.0 mm holes, D2 has 1.1 mm holes; D3 has intentionally shifted local silkscreen.
ERC: 0 errors, 1 intentional Device:Polyfuse embedded-symbol mismatch warning at F1.
Saved project has no per-item DRC exclusions. Some inherited check categories are ignored;
the full machine-readable reports preserve that fact. This is not an assertion that every
optional KiCad check is enabled.

Independent checks: 425 circuit assertions; 160 firmware pin/value assertions;
12 retained source/binary identities; zero native courtyard/body intersections in the
specified component envelope review; local bypass/ground/power-feed continuity passes.
Gerber/drill checks: panel 808 passed; matching HAT 272 passed, including USB plated slots.
Matching HAT native: 0 DRC errors, 0 airwires, 0 parity; 330 schematic assertions pass.
HAT keeps 57 inherited silkscreen warnings and 33 schematic metadata/label warnings;
these are fully enumerated in matching-HAT. Original servo-power routing/widths retained.

Files: szscreen.kicad_pro opens the native panel project. Keep its same-name schematic,
PCB, rules and library tables together. The matching-HAT folder is a DIFFERENT HAT
PCB revision from the original submitted HAT. Do not mix original/variant parts or copper.
The currently reviewed original HAT is not this variant; its approval/manufacture must be
reconciled before using the panel. This package does not silently update that submission.
panel-gerbers contains exactly this panel's fabrication layers and separate PTH/NPTH drills.
Use szscreen-panel-Gerbers.zip for panel fabrication only, not the complete engineering ZIP.
STEP exports are omitted from this repository at the owner's request; native KiCad sources remain available.

PROTOTYPE VALIDATION AND COST ITEMS:
1. No assembled/powered prototype exists. Real display-rail tap, harness, fan, supply
   headroom, partial-power behavior, signal edges and mechanical mating remain untested.
2. Independent stopping of both motor supplies and output gravity retention are unfinished.
   User reports the non-base joints drop without power. Panel buttons do not implement it.
3. Generated firmware is REFERENCE ONLY. The participant supplied detailed behavior
   requirements and intends to write the actual implementation. It is not their completed
   implementation or evidence of a working motor-command adapter/hardware test.
4. Priced parts are $99.768 before all PCB fabrication, shipping/tax, unpriced harness and
   mounting, remaining HAT costs and independent stop/retention. All-in $100 is not met.
The older rev22 and 23-pcb-draft files are superseded. They are preserved as history.
No physical motor command, flashing, port opening, purchase or external submission occurred.
