gmaxdragon/Seizo-Screen/schematic.pdf

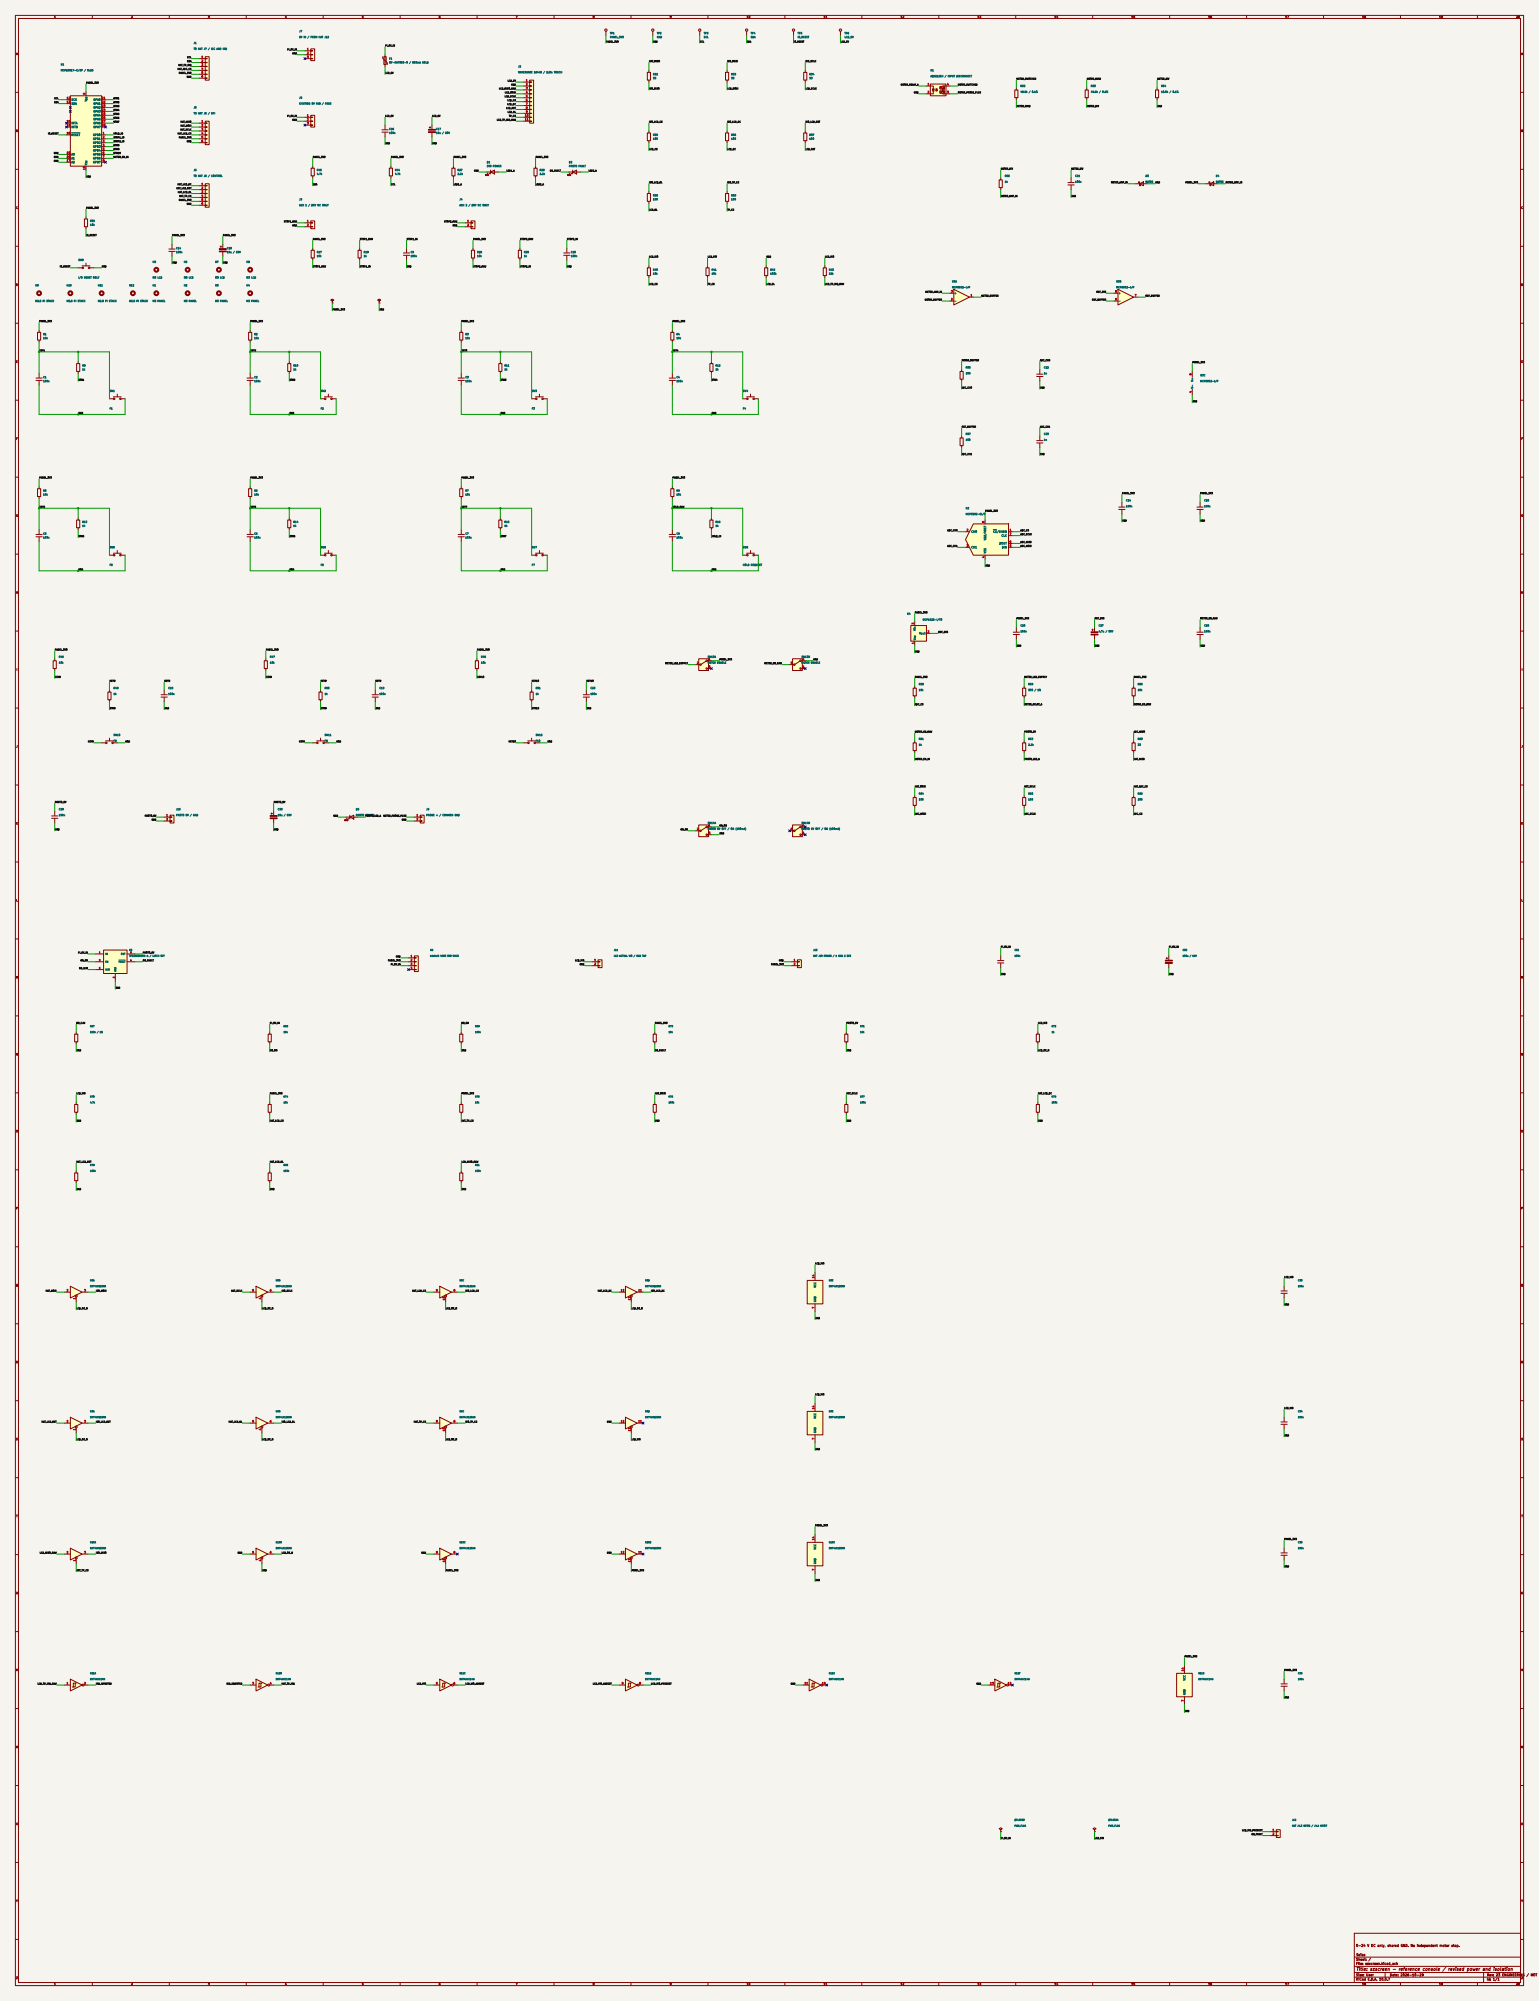
[picture p8: page 1]

TO HAT J7 / I2C AND IRQ 1

AUX 1 / DRY NC ONLY

AUX 2 / DRY NC ONLY

LCD ACTUAL VIO / GND TAP

0-24 V DC only, shared GND. No independent motor stop.

Seizo
Sheet: /
File: szscreen.kicad_sch
Title: szscreen - reference console / revised power and isolation
KiCad E.D.A. 10.0.7
