gmaxdragon/Seizo-Screen/assembly/hat-assembly-bottom.pdf

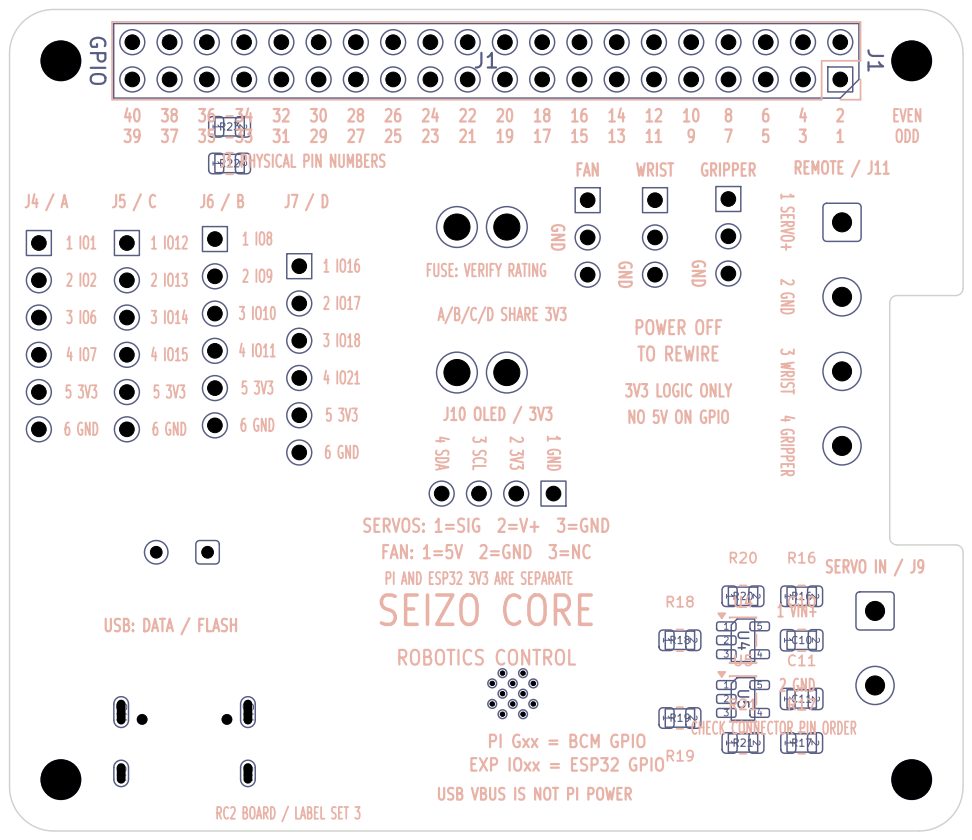
[picture p9: page 1]

2 RC2 BOARD / LABEL SET 3 CHECK CONNECTOR PIN ORDER PI AND ESP32 3V3 ARE SEPARATE 1 IO16

TO REWIRE PI Gxx = BCM GPIO

3V3 LOGIC ONLY NO 5V ON GPIO
