gmaxdragon/Seizo-Screen/matching-HAT/schematic.pdf

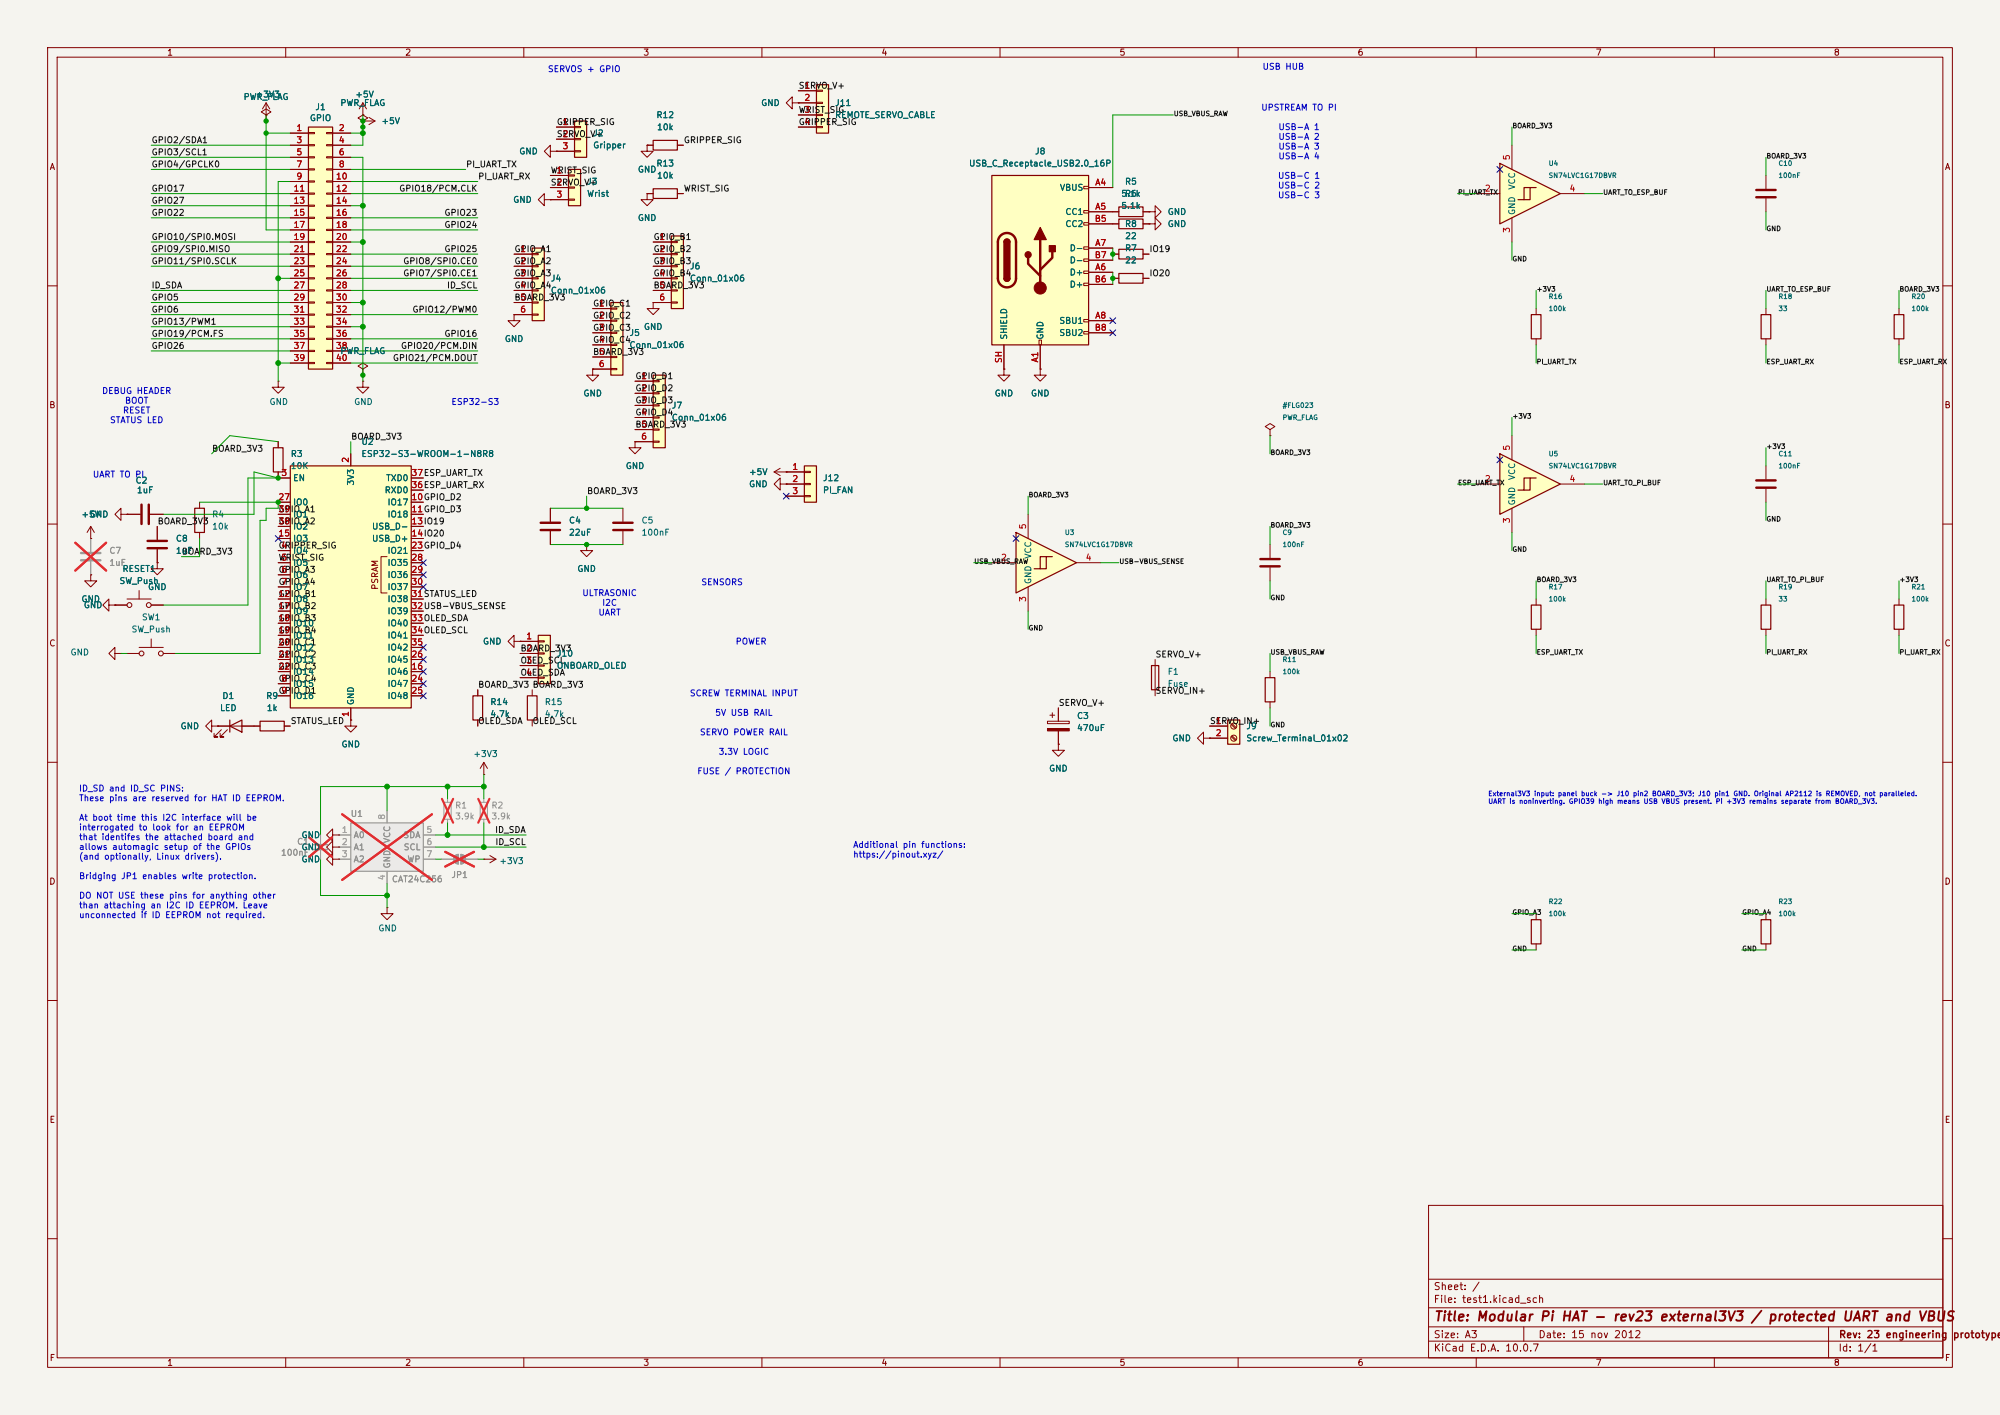
[picture p10: page 1]

3 3 | 4 4
5 5 | 6 6

11 11 | | 12 12
13 13 | | 14 14

31 31 | 32 32
33 33 | 34 34
35 35 | 36 36
37 37 | 38 38 PWR_FLAG | GPIO20/PCM.DIN
39 | 40

DEBUG HEADER
BOOT RESET STATUS LED

SCREW TERMINAL INPUT 5V USB RAIL SERVO POWER RAIL 3.3V LOGIC

ID_SD and ID_SC PINS: These pins are reserved for HAT ID EEPROM. At boot time this I2C interface will be

External3V3 input: panel buck -> J10 pin2 BOARD_3V3; J10 pin1 GND. Original AP2112 is REMOVED, not paralleled. UART is noninverting. GPIO39 high means USB VBUS present. Pi +3V3 remains separate from BOARD_3V3.

interrogated to look for an EEPROM
that identifes the attached board and
allows automagic setup of the GPIOs
(and optionally, Linux drivers).

Bridging JP1 enables write protection. DO NOT USE these pins for anything other

than attaching an I2C ID EEPROM. Leave unconnected if ID EEPROM not required.

Sheet: /
File: test1.kicad_sch
Title: Modular Pi HAT - rev23 external3V3 / protected UART and VBUS

F Date: 15 nov 2012

KiCad E.D.A. 10.0.7 | Id: 1/1
