gmaxdragon/Seizo-Screen/assembly/hat-assembly-top.pdf

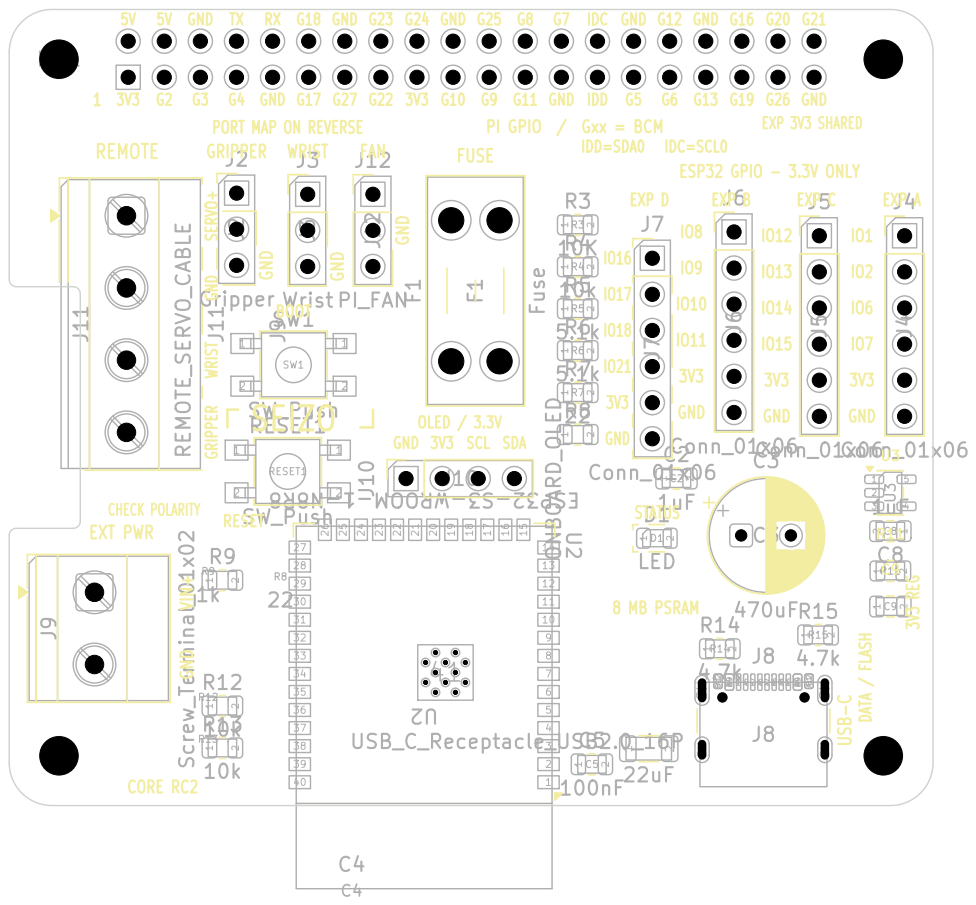
[picture p11: page 1]
