gmaxdragon/Seizo-Screen/assembly/panel-assembly-bottom.pdf

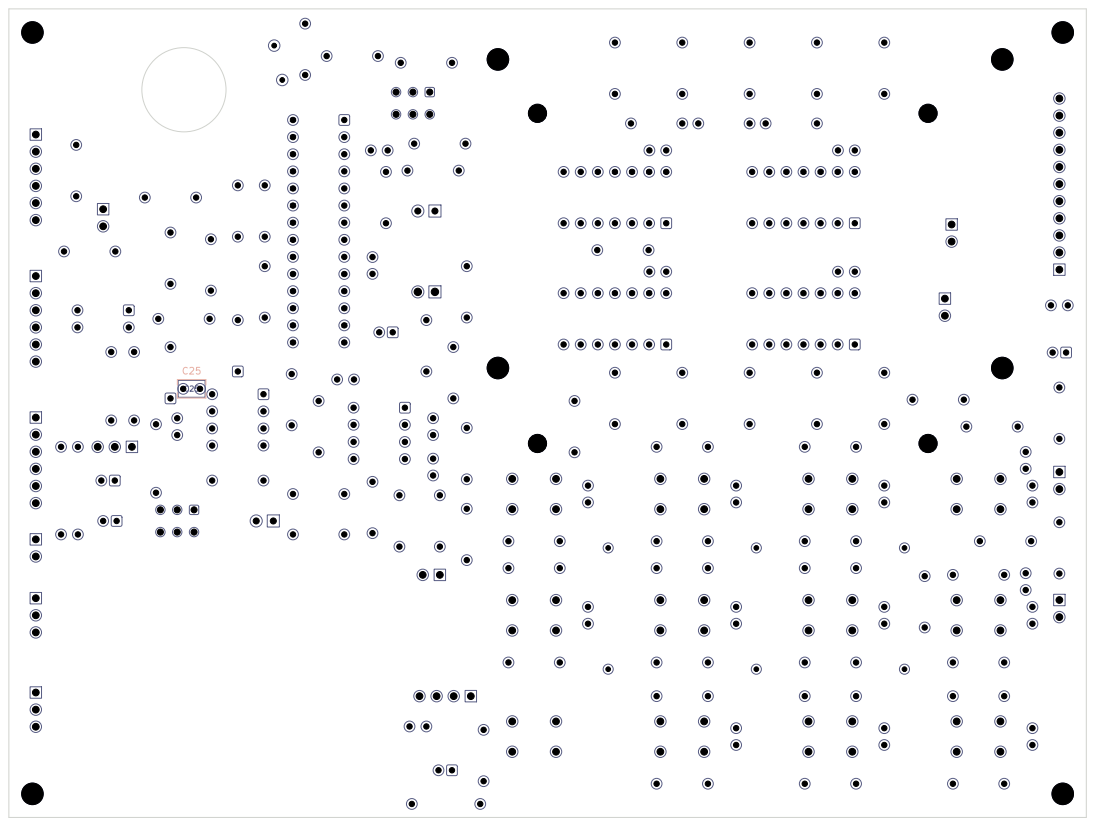
[picture p12: page 1]
