gmaxdragon/Seizo-Screen/assembly/panel-assembly-top.pdf

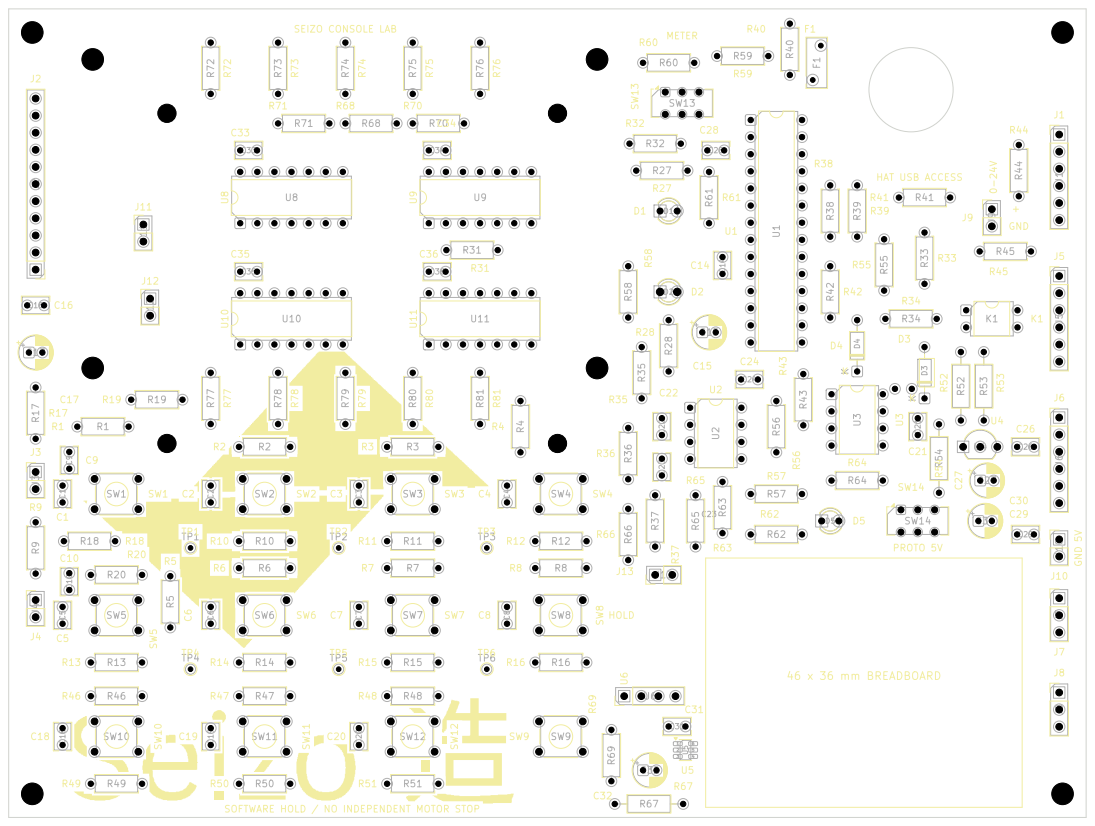
[picture p13: page 1]
