gmaxdragon/Seizo-Screen/pcb-front.pdf

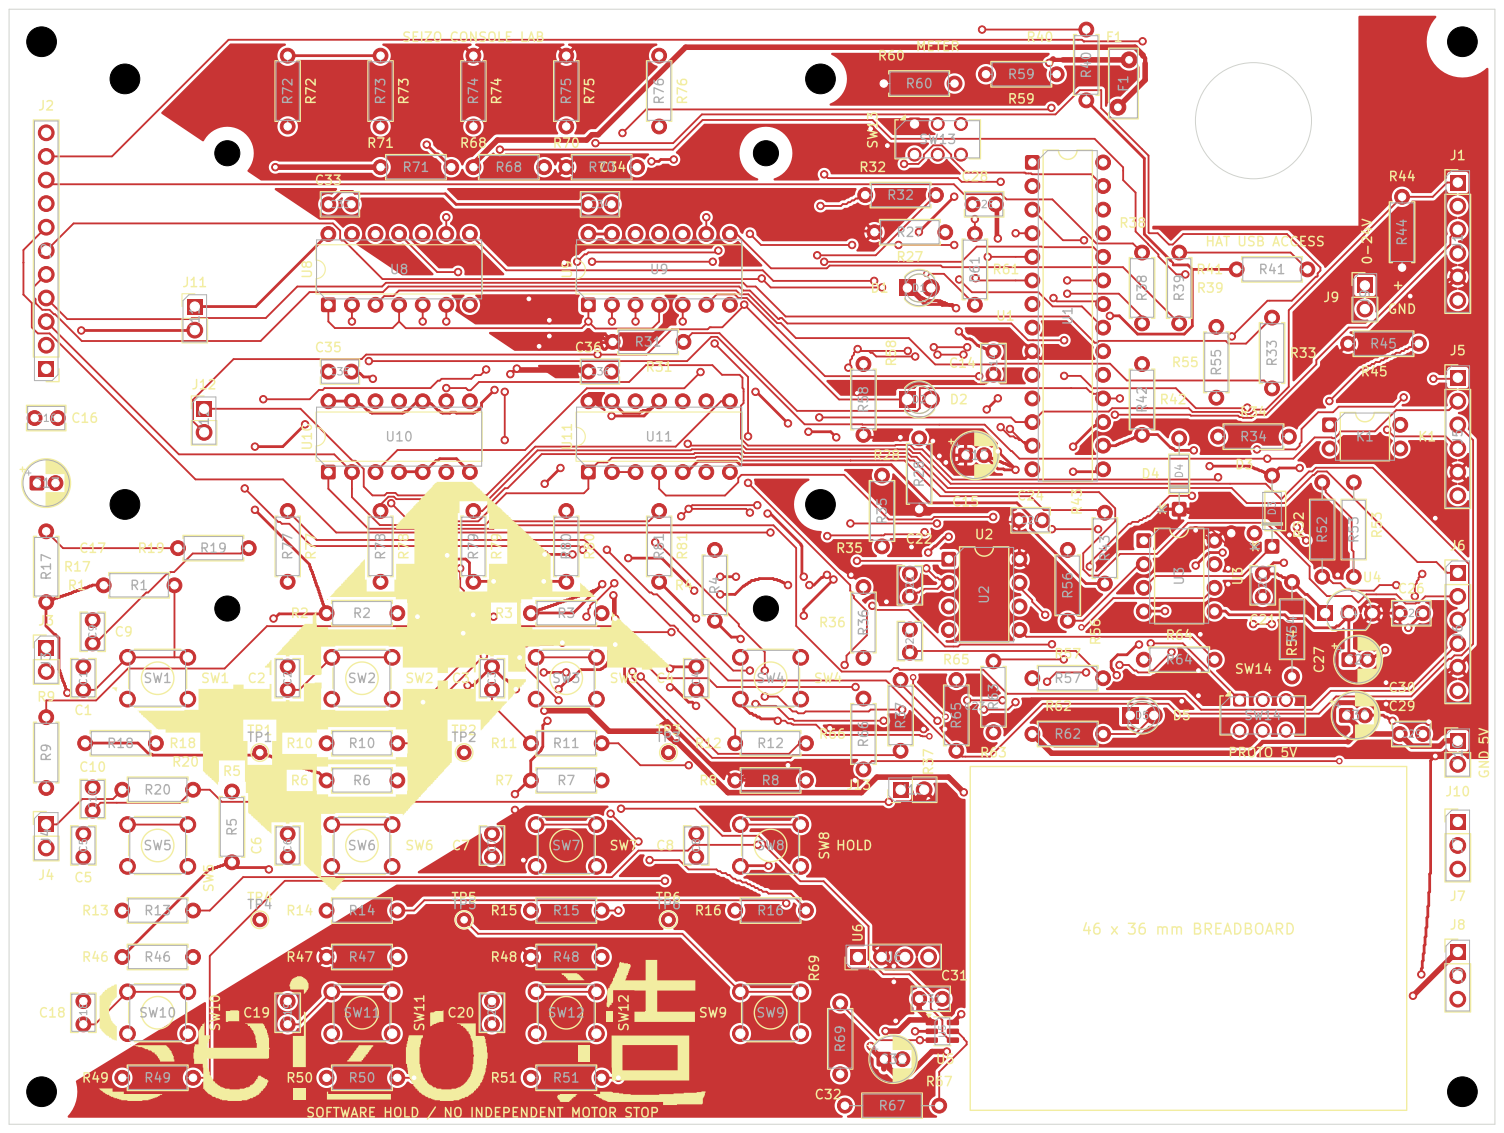
[picture p14: page 1]
