gmaxdragon/Seizo-Screen/szscreen.kicad_pcb

## KiCad design szscreen.kicad_pcb (2026-10-31)

Schematic: szscreen.kicad_sch, szscreen - reference console / revised power and isolation

Parts:
C1, C2, C3, C4, C5, C6, C7, C8, C9, C10, C14, C16, C18, C19, C20, C21, C24, C25, C26, C28, C29, C31, C33, C34, C35, C36: 100n; C_Rect_L4.0mm_W2.5mm_P2.50mm
C15, C17, C30: 10u / 50V; CP_Radial_D5.0mm_P2.00mm
C22, C23: 1n; C_Rect_L4.0mm_W2.5mm_P2.50mm
C27: 4.7u / 50V; CP_Radial_D5.0mm_P2.00mm
C32: 100u / 16V; CP_Radial_D5.0mm_P2.00mm
D1: 3V3 POWER; LED_D3.0mm
D2: PROTO FAULT; LED_D3.0mm
D3, D4: BAT85; D_DO-35_SOD27_P7.62mm_Horizontal
D5: PROTO POWER; LED_D3.0mm
F1: MF-RHT050-0 / 500mA HOLD; Fuse_Bourns_MF-RHT050
H1, H2, H3, H4: M3 PANEL; MountingHole_3.2mm_M3
H5, H6, H7, H8: M3 LCD; MountingHole_3.2mm_M3
H9, H10, H11, H12: M2.5 PI STACK; MountingHole_2.7mm_M2.5
J1: TO HAT J7 / I2C AND IRQ; PinHeader_1x06_P2.54mm_Vertical
J2: WAVESHARE 16446 / 2.8in TOUCH; PinHeader_1x11_P2.54mm_Vertical
J3: AUX 1 / DRY NC ONLY; PinHeader_1x02_P2.54mm_Vertical
J4: AUX 2 / DRY NC ONLY; PinHeader_1x02_P2.54mm_Vertical
J5: TO HAT J6 / SPI; PinHeader_1x06_P2.54mm_Vertical
J6: TO HAT J5 / CONTROL; PinHeader_1x06_P2.54mm_Vertical
J7: 5V IN / FROM HAT J12; PinHeader_1x03_P2.54mm_Vertical
J8: EXISTING 5V FAN / PASS; PinHeader_1x03_P2.54mm_Vertical
J9: PROBE + / COMMON GND; PinHeader_1x02_P2.54mm_Vertical
J10: PROTO 5V / GND; PinHeader_1x02_P2.54mm_Vertical
J11: LCD ACTUAL VIO / GND TAP; PinHeader_1x02_P2.54mm_Vertical
J12: HAT J4.3 GPIO6 / J4.4 GPIO7; PinHeader_1x02_P2.54mm_Vertical
J13: HAT J10 POWER / 1 GND 2 3V3; PinHeader_1x02_P2.54mm_Vertical
K1: AQY212EH / INPUT DISCONNECT; DIP-4_W7.62mm
R1, R2, R3, R4, R5, R6, R7, R8, R17, R18, R31, R40, R41, R46, R47, R48, R58, R60, R68, R70, R71, R74, R75: 10k; R_Axial_DIN0207_L6.3mm_D2.5mm_P7.62mm_Horizontal
R9, R10, R11, R12, R13, R14, R15, R16, R19, R20, R49, R50, R51, R55, R61, R72: 1k; R_Axial_DIN0207_L6.3mm_D2.5mm_P7.62mm_Horizontal
R27, R28, R62: 2.2k; R_Axial_DIN0207_L6.3mm_D2.5mm_P7.62mm_Horizontal
R32, R33, R34, R63: 33; R_Axial_DIN0207_L6.3mm_D2.5mm_P7.62mm_Horizontal
R35, R36, R37, R38, R39, R56, R57, R64, R65, R66: 100; R_Axial_DIN0207_L6.3mm_D2.5mm_P7.62mm_Horizontal
R42, R69, R76, R77, R78, R79, R80, R81: 100k; R_Axial_DIN0207_L6.3mm_D2.5mm_P7.62mm_Horizontal
R43: 22k; R_Axial_DIN0207_L6.3mm_D2.5mm_P7.62mm_Horizontal
R44, R45, R73: 4.7k; R_Axial_DIN0207_L6.3mm_D2.5mm_P7.62mm_Horizontal
R52, R53: 49.9k / 0.1%; R_Axial_DIN0207_L6.3mm_D2.5mm_P10.16mm_Horizontal
R54: 10.0k / 0.1%; R_Axial_DIN0207_L6.3mm_D2.5mm_P10.16mm_Horizontal
R59: 330 / 1%; R_Axial_DIN0207_L6.3mm_D2.5mm_P7.62mm_Horizontal
R67: 210k / 1%; R_Axial_DIN0207_L6.3mm_D2.5mm_P10.16mm_Horizontal
SW1: F1; SW_TH_Tactile_Omron_B3F-100x
SW2: F2; SW_TH_Tactile_Omron_B3F-100x
SW3: F3; SW_TH_Tactile_Omron_B3F-100x
SW4: F4; SW_TH_Tactile_Omron_B3F-100x
SW5: F5; SW_TH_Tactile_Omron_B3F-100x
SW6: F6; SW_TH_Tactile_Omron_B3F-100x
SW7: F7; SW_TH_Tactile_Omron_B3F-100x
SW8: HOLD REQUEST; SW_TH_Tactile_Omron_B3F-100x
SW9: I/O RESET ONLY; SW_TH_Tactile_Omron_B3F-100x
SW10: F8; SW_TH_Tactile_Omron_B3F-100x
SW11: F9; SW_TH_Tactile_Omron_B3F-100x
SW12: F10; SW_TH_Tactile_Omron_B3F-100x
SW13: METER ENABLE; SW_CK_JS202011CQN_DPDT_Straight
SW14: PROTO 5V OFF / ON (100mA); SW_CK_JS202011CQN_DPDT_Straight
TP1: PANEL_3V3; TestPoint_THTPad_D1.5mm_Drill0.7mm
TP2: GND; TestPoint_THTPad_D1.5mm_Drill0.7mm
TP3: SCL; TestPoint_THTPad_D1.5mm_Drill0.7mm
TP4: SDA; TestPoint_THTPad_D1.5mm_Drill0.7mm
TP5: IO_RESET; TestPoint_THTPad_D1.5mm_Drill0.7mm
TP6: LCD_5V; TestPoint_THTPad_D1.5mm_Drill0.7mm
U1: MCP23017-E/SP / 0x20; DIP-28_W7.62mm
U2: MCP3202-BI/P; DIP-8_W7.62mm
U3: MCP6002-I/P; DIP-8_W7.62mm
U4: MCP1525-I/TO; TO-92_Inline_Wide
U5: TPS2553DBVR-1 / LATCH OFF; SOT-23-6
U6: Adafruit 4683 3V3 BUCK; PinHeader_1x04_P2.54mm_Vertical
U8, U9, U10: SN74LV125AN; DIP-14_W7.62mm
U11: SN74AHC14N; DIP-14_W7.62mm

Connections:
/ADC_CH0: C22.1, R56.2, U2.2 (CH0)
/ADC_CH1: C23.1, R57.2, U2.3 (CH1)
/ADC_CS: R58.2, R66.2, U2.1 (~CS/SHDN)
/ADC_MISO: R63.1, U2.6 (DOUT)
/ADC_MOSI: R64.2, U2.5 (DIN)
/ADC_SCLK: R65.2, U2.7 (CLK)
/BB_EN: R69.1, SW14.2 (B), U5.3 (EN)
/BB_FAULT: D2.1 (K), J12.2, R70.2, U5.4 (~FAULT)
/BB_ILIM: R67.1, U5.5 (ILIM)
/BB_ON: R68.2, SW14.1 (A)
/BTN1: R9.2, U1.21 (GPA0)
/BTN2: R10.2, U1.22 (GPA1)
/BTN3: R11.2, U1.23 (GPA2)
/BTN4: R12.2, U1.24 (GPA3)
/BTN5: R13.2, U1.25 (GPA4)
/BTN6: R14.2, U1.26 (GPA5)
/BTN7: R15.2, U1.27 (GPA6)
/BTN8: R49.2, U1.4 (GPB3)
/BTN9: R50.2, U1.5 (GPB4)
/BTN10: R51.2, U1.6 (GPB5)
/GND: C1.2, C2.2, C3.2, C4.2, C5.2, C6.2, C7.2, C8.2, C9.2, C10.2, C14.2, C15.2, C16.2, C17.2, C18.2, C19.2, C20.2, C21.2, C22.2, C23.2, C24.2, C25.2, C26.2, C27.2, C28.2, C29.2, C30.2, C31.2, C32.2, C33.2, C34.2, C35.2, C36.2, D1.1 (K), D3.2 (A), D5.1 (K), J1.6, J2.2, J3.2, J4.2, J5.6, J6.6, J7.2, J8.2, J9.2, J10.2, J11.2, J13.1, K1.2, R42.1, R54.2, R67.2, R69.2, R71.2, R73.2, R76.2, R77.2, R78.2, R79.2, R80.2, R81.2, SW1.2, SW2.2, SW3.2, SW4.2, SW5.2, SW6.2, SW7.2, SW8.2, SW9.2, SW10.2, SW11.2, SW12.2, SW13.4 (A), SW14.3 (C), TP2.1, U1.10 (V_{SS}), U1.15 (A0), U1.16 (A1), U1.17 (A2), U2.4 (VSS), U3.4 (V-), U4.1 (Vss), U5.2 (GND), U6.1, U8.7 (GND), U9.7 (GND), U9.12, U10.4, U10.5, U10.7 (GND), U10.9, U10.12, U11.7 (GND), U11.11, U11.13
/HAT_ADC_CS: J1.4, R66.1
/HAT_LCD_BL: J6.3, R80.1, U9.5
/HAT_LCD_CS: J5.4, R74.2, U8.9
/HAT_LCD_DC: J6.1, R78.1, U8.12
/HAT_LCD_RST: J6.2, R79.1, U9.2
/HAT_MISO: J5.1, R32.1, R63.2
/HAT_MOSI: J5.2, R64.1, R76.1, U8.2
/HAT_SCLK: J5.3, R65.1, R77.1, U8.5
/HAT_TP_CS: J6.4, R75.2, U9.9, U10.1
/HAT_TP_IRQ: J1.3, U11.4
/HOLD_IN: R16.2, U1.1 (GPB0)
/HOLD_RAW: C8.1, R8.2, R16.1, SW8.1
/IO_RESET: R31.2, SW9.1, TP5.1, U1.18 (~RESET)
/IRQ_INVERTED: U11.2, U11.3
/ISO_LCD_BL: R38.1, U9.6
/ISO_LCD_CS: R35.1, U8.8
/ISO_LCD_DC: R36.1, U8.11
/ISO_LCD_RST: R37.1, U9.3
/ISO_MISO: R32.2, U10.3
/ISO_MOSI: R33.1, U8.3
/ISO_SCLK: R34.1, U8.6
/ISO_TP_CS: R39.1, U9.8
/KEY1: C1.1, R1.2, R9.1, SW1.1
/KEY2: C2.1, R2.2, R10.1, SW2.1
/KEY3: C3.1, R3.2, R11.1, SW3.1
/KEY4: C4.1, R4.2, R12.1, SW4.1
/KEY5: C5.1, R5.2, R13.1, SW5.1
/KEY6: C6.1, R6.2, R14.1, SW6.1
/KEY7: C7.1, R7.2, R15.1, SW7.1
/KEY8: C18.1, R46.2, R49.1, SW10.1
/KEY9: C19.1, R47.2, R50.1, SW11.1
/KEY10: C20.1, R48.2, R51.1, SW12.1
/LCD_5V: C16.1, C17.1, F1.2, J2.1, TP6.1
/LCD_BL: J2.9, R38.2, R42.2
/LCD_CS: J2.6, R35.2, R40.2
/LCD_DC: J2.7, R36.2
/LCD_MISO_RAW: J2.3, R81.1, U10.2
/LCD_MOSI: J2.4, R33.2
/LCD_OE_N: R72.2, U8.1, U8.4, U8.10, U8.13, U9.1, U9.4, U9.10, U10.6
/LCD_RST: J2.8, R37.2
/LCD_SCLK: J2.5, R34.2
/LCD_TP_IRQ_RAW: J2.11, R43.2, U11.1
/LCD_VIO: C33.1, C34.1, J11.1, R40.1, R41.1, R43.1, R72.1, R73.1, U8.14 (VCC), U9.13, U9.14 (VCC), U11.5
/LCD_VIO_ABSENT: U11.6, U11.9
/LCD_VIO_PRESENT: J12.1, U11.8
/LED1_A: D1.2 (A), R27.2
/LED2_A: D2.2 (A), R28.2
/METER_AMP_IN: D3.1 (K), D4.2 (A), R55.2, U3.3 (+)
/METER_BUFFER: R56.1, U3.1, U3.2 (-)
/METER_DIV: C21.1, R53.2, R54.1, R55.1
/METER_EN_IN: R61.2, U1.7 (GPB6)
/METER_EN_RAW: C28.1, R60.2, R61.1, SW13.5 (B)
/METER_LED_SUPPLY: R59.1, SW13.2 (B)
/METER_PROBE_PLUS: J9.1, K1.3
/METER_RELAY_A: K1.1, R59.2
/METER_RMID: R52.2, R53.1
/METER_SWITCHED: K1.4, R52.1
/PANEL_3V3: C14.1, C15.1, C24.1, C25.1, C26.1, C35.1, C36.1, D4.1 (K), J1.5, J5.5, J6.5, J13.2, R1.1, R2.1, R3.1, R4.1, R5.1, R6.1, R7.1, R8.1, R17.1, R18.1, R27.1, R28.1, R31.1, R44.1, R45.1, R46.1, R47.1, R48.1, R58.1, R60.1, R70.1, R74.1, R75.1, SW13.1 (A), TP1.1, U1.9 (V_{DD}), U2.8 (VDD/VREF), U3.8 (V+), U4.3 (Vin), U6.2, U10.10, U10.13, U10.14 (VCC), U11.14 (VCC)
/PI_5V_IN: C31.1, C32.1, F1.1, J7.1, J8.1, R68.1, U5.1 (IN), U6.3
/PROTO_5V: C29.1, C30.1, J10.1, R62.1, R71.1, U5.6 (OUT)
/PROTO_LED_A: D5.2 (A), R62.2
/REF_2V5: C27.1, U3.5 (+), U4.2 (Vout)
/REF_BUFFER: R57.1, U3.6 (-), U3.7
/SCL: J1.1, R44.2, TP3.1, U1.12 (SCK)
/SDA: J1.2, R45.2, TP4.1, U1.13 (SDA)
/STOP1_IN: C9.1, R19.2, U1.2 (GPB1)
/STOP1_RAW: J3.1, R17.2, R19.1
/STOP2_IN: C10.1, R20.2, U1.3 (GPB2)
/STOP2_RAW: J4.1, R18.2, R20.1
/TP_CS: J2.10, R39.2, R41.2

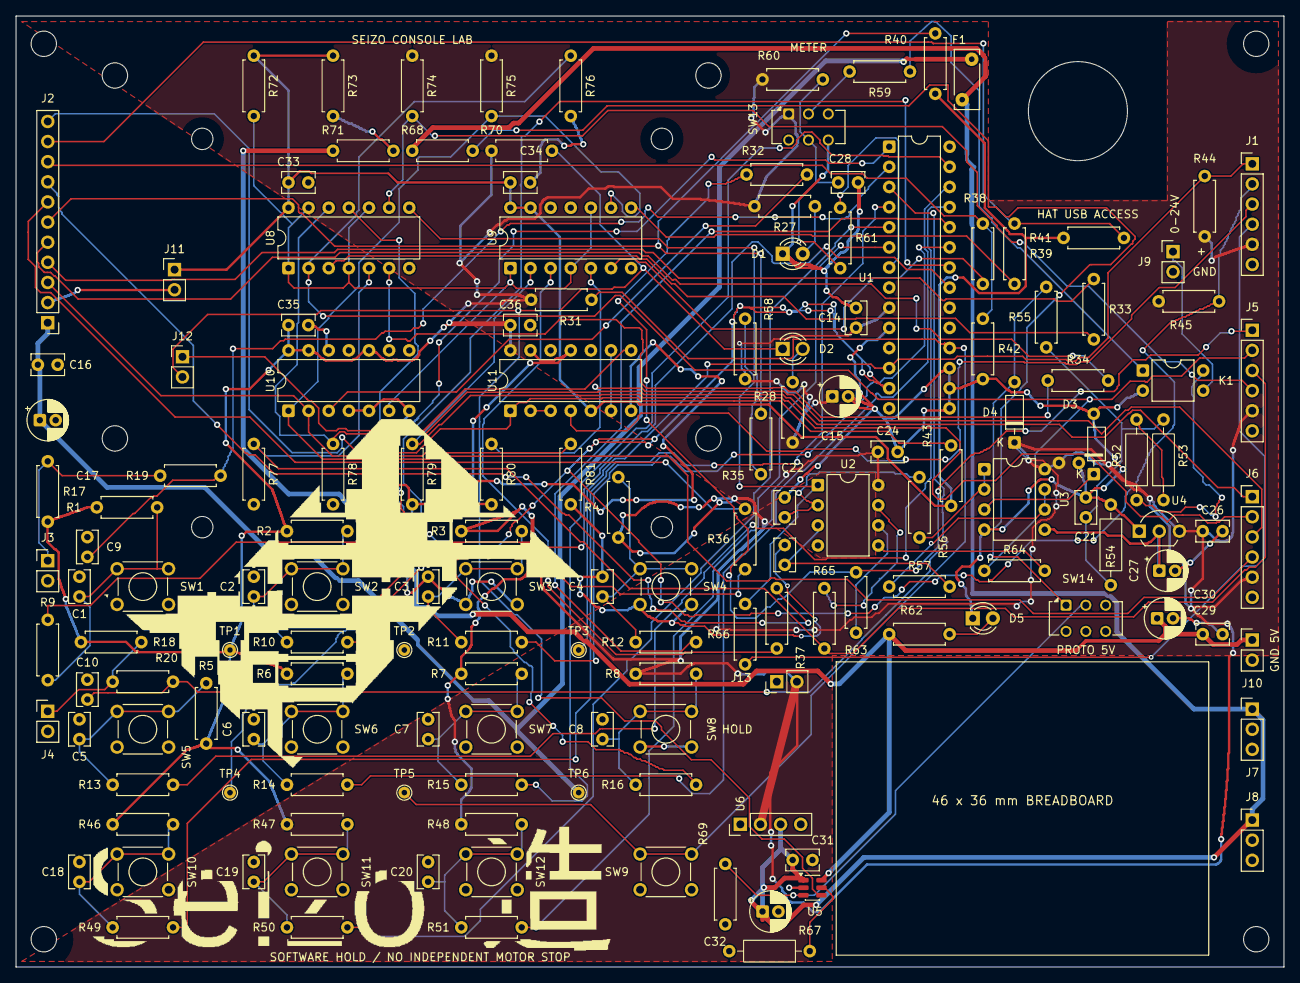
[picture p15: board szscreen.kicad_pcb from above]

Board: 2 copper layers, 160.0 x 120.0 mm, 168 parts (1 on the bottom side), 91 nets.
