gmaxdragon/Seizo-Screen/matching-HAT/test1.kicad_pcb

## KiCad design matching-HAT/test1.kicad_pcb (2026-10-31)

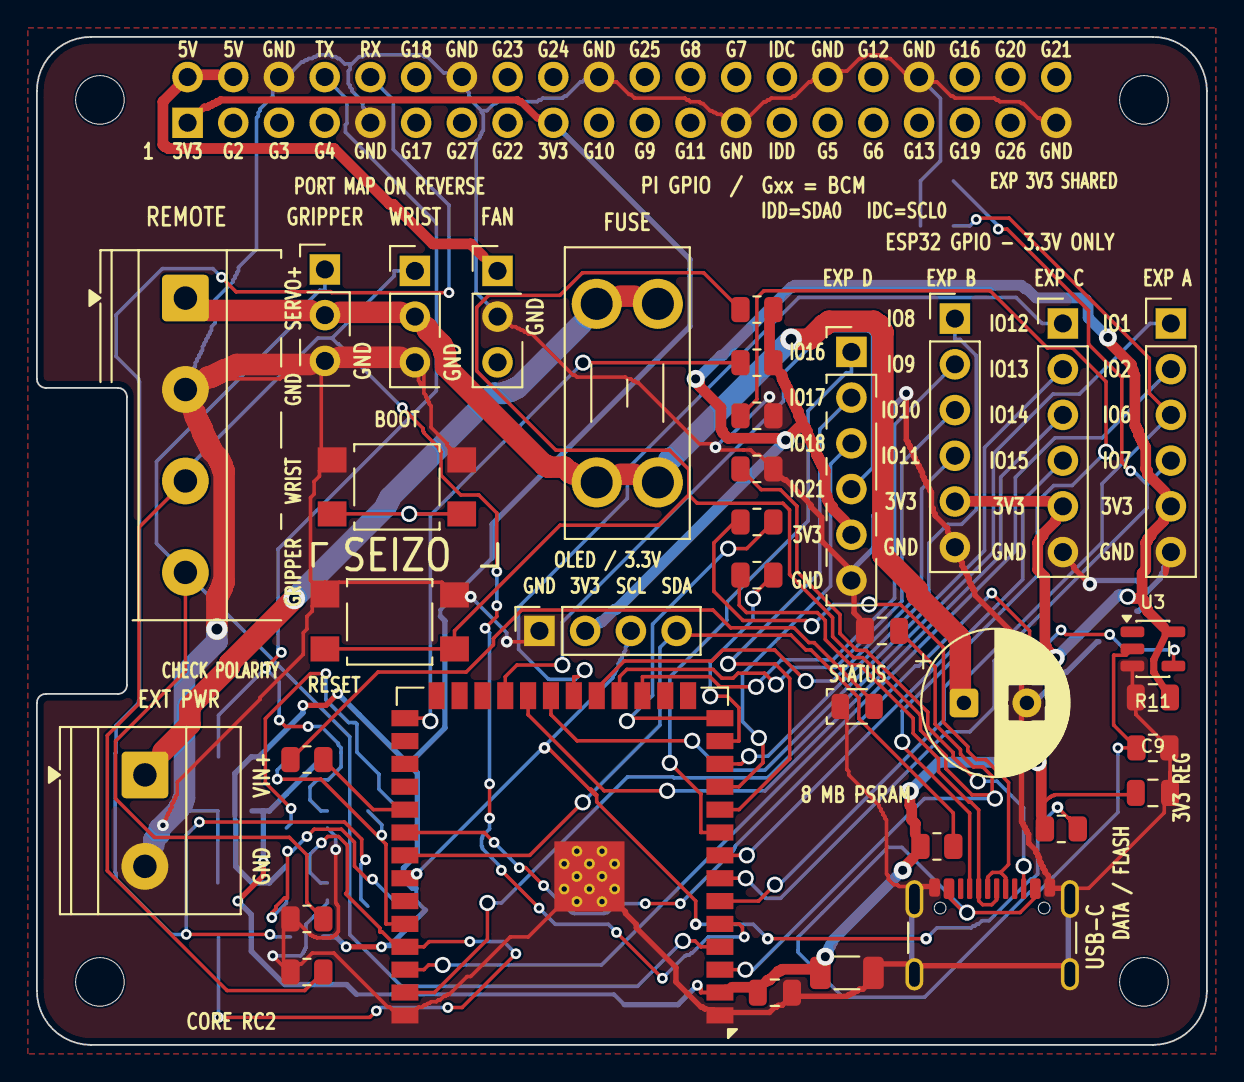
[picture p16: board test1.kicad_pcb from above]

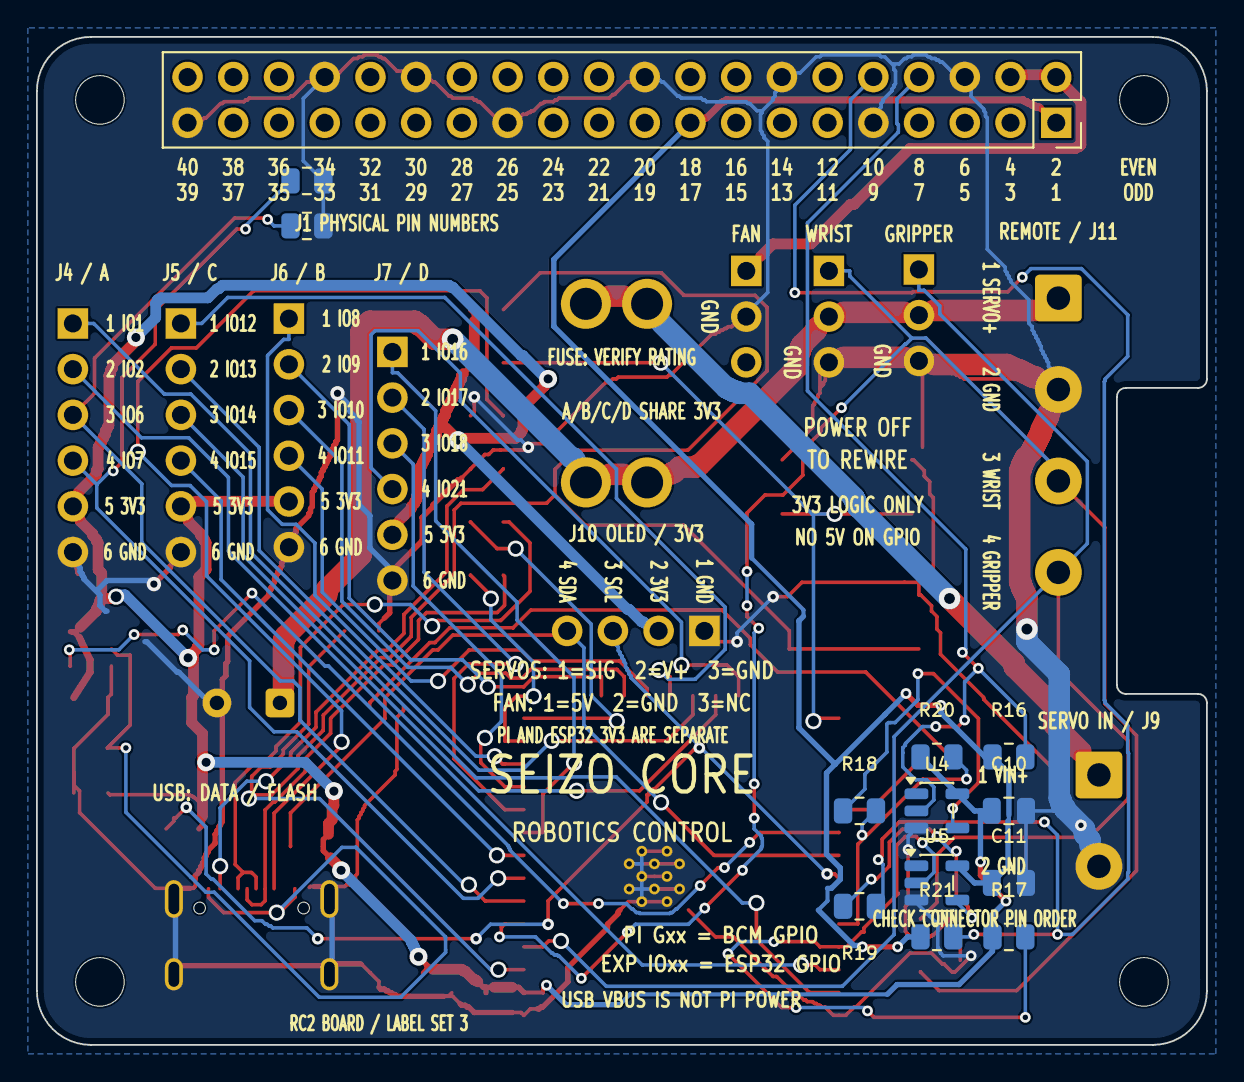
[picture p17: board test1.kicad_pcb from below]

Board: 2 copper layers, 65.0 x 56.0 mm, 52 parts (13 on the bottom side), 44 nets.

Parts:
C2: 1uF; RC2_C2_C_0805_2012Metric
C3: 470uF; RC2_C3_CP_Radial_D8_0mm_P3_50mm
C4: 22uF; RC2_C4_C_1206_3216Metric
C5: 100nF; RC2_C5_C_0805_2012Metric
C8: 1uF; RC2_C8_C_0805_2012Metric
C9, C10, C11: 100nF; C_0805_2012Metric
D1: LED; RC2_D1_LED_0805_2012Metric
F1: Fuse; RC2_F1_Fuseholder_Blade_Mini_Keystone_3568
J1: GPIO; Pi_HAT_Stacking_Socket_Checked
J2: Gripper; RC2_J2_PinHeader_1x03_P2_54mm_Vertical
J3: Wrist; RC2_J3_PinHeader_1x03_P2_54mm_Vertical
J4: Conn_01x06; RC2_J4_PinHeader_1x06_P2_54mm_Vertical
J5: Conn_01x06; RC2_J5_PinHeader_1x06_P2_54mm_Vertical
J6: Conn_01x06; RC2_J6_PinHeader_1x06_P2_54mm_Vertical
J7: Conn_01x06; RC2_J7_PinHeader_1x06_P2_54mm_Vertical
J8: USB_C_Receptacle_USB2.0_16P; RC2_J8_USB4105_GND_Heel_Clearance
J9: Screw_Terminal_01x02; RC2_J9_TerminalBlock_Phoenix_MKDS_1_5_2_5_08_1x02_P5_08mm_H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
J10: ONBOARD_OLED; RC2_J10_PinSocket_1x04_P2_54mm_Vertical
J11: REMOTE_SERVO_CABLE; RC2_J11_Servo_Terminal_Silk_Clipped
J12: PI_FAN; RC2_J12_PinHeader_1x03_P2_54mm_Vertical
MH1, MH2, MH3, MH4: MountingHole_2.7mm_M2.5
R3: 10K; RC2_R3_R_0805_2012Metric
R4: 10k; RC2_R4_R_0805_2012Metric
R5: 5.1k; RC2_R5_R_0805_2012Metric
R6: 5.1k; RC2_R6_R_0805_2012Metric
R7: 22; RC2_R7_R_0805_2012Metric
R8: 22; RC2_R8_R_0805_2012Metric
R9: 1k; RC2_R9_R_0805_2012Metric
R11, R16, R17, R20, R21, R22, R23: 100k; R_0805_2012Metric
R12: 10k; RC2_R12_R_0805_2012Metric
R13: 10k; RC2_R13_R_0805_2012Metric
R14: 4.7k; RC2_R14_R_0805_2012Metric
R15: 4.7k; RC2_R15_R_0805_2012Metric
R18, R19: 33; R_0805_2012Metric
RESET1: SW_Push; RC2_RESET1_SW_SPST_TL3305A
SW1: SW_Push; RC2_SW1_SW_SPST_TL3305A
U2: ESP32-S3-WROOM-1-N8R8; RC2_U2_ESP32_S3_WROOM_1_Thermal030
U3, U4, U5: SN74LVC1G17DBVR; SOT-23-5

Connections:
+3V3: C11.1, J1.1, J1.17, R16.1, R21.1, U5.5
+5V: J1.2, J1.4, J12.1
/BOARD_3V3: C4.1, C5.1, C8.1, C9.1, C10.1, J4.5, J5.5, J6.5, J7.5, J10.2, R3.2, R4.2, R14.1, R15.1, R17.1, R20.1, U2.2 (3V3), U3.5, U4.5
/ESP_UART_RX: R18.2, R20.2, U2.36 (RXD0)
/ESP_UART_TX: R17.2, U2.37 (TXD0), U5.2
/GPIO_A1: J4.1, U2.39 (IO1)
/GPIO_A2: J4.2, U2.38 (IO2)
/GPIO_A3: J4.3, R22.1, U2.6 (IO6)
/GPIO_A4: J4.4, R23.1, U2.7 (IO7)
/GPIO_B1: J6.1, U2.12 (IO8)
/GPIO_B2: J6.2, U2.17 (IO9)
/GPIO_B3: J6.3, U2.18 (IO10)
/GPIO_B4: J6.4, U2.19 (IO11)
/GPIO_C1: J5.1, U2.20 (IO12)
/GPIO_C2: J5.2, U2.21 (IO13)
/GPIO_C3: J5.3, U2.22 (IO14)
/GPIO_C4: J5.4, U2.8 (IO15)
/GPIO_D1: J7.1, U2.9 (IO16)
/GPIO_D2: J7.2, U2.10 (IO17)
/GPIO_D3: J7.3, U2.11 (IO18)
/GPIO_D4: J7.4, U2.23 (IO21)
/GRIPPER_SIG: J2.1, J11.4, R12.2, U2.4 (IO4)
/IO19: R8.2, U2.13 (USB_D-)
/IO20: R7.2, U2.14 (USB_D+)
/OLED_SCL: J10.3, R15.2, U2.34 (IO41)
/OLED_SDA: J10.4, R14.2, U2.33 (IO40)
/PI_UART_RX: J1.10, R19.2, R21.2
/PI_UART_TX: J1.8, R16.2, U4.2
/SERVO_IN+: F1.2, J9.1
/SERVO_V+: C3.1, F1.1, J2.2, J3.2, J11.1
/STATUS_LED: R9.2, U2.31 (IO38)
/UART_TO_ESP_BUF: R18.1, U4.4
/UART_TO_PI_BUF: R19.1, U5.4
/USB-VBUS_SENSE: U2.32 (IO39), U3.4
/USB_VBUS_RAW: J8.A4 (VBUS), J8.A9 (VBUS), J8.B4 (VBUS), J8.B9 (VBUS), R11.1, U3.2
/WRIST_SIG: J3.1, J11.3, R13.2, U2.5 (IO5)
GND: C2.1, C3.2, C4.2, C5.2, C8.2, C9.2, C10.2, C11.2, D1.1 (K), J1.6, J1.9, J1.14, J1.20, J1.25, J1.30, J1.34, J1.39, J2.3, J3.3, J4.6, J5.6, J6.6, J7.6, J8.A1 (GND), J8.A12 (GND), J8.B1 (GND), J8.B12 (GND), J8.SH (SHIELD), J9.2, J10.1, J11.2, J12.2, R5.2, R6.2, R11.2, R12.1, R13.1, R22.2, R23.2, RESET1.1, SW1.1, U2.1 (GND), U2.40 (GND), U2.41 (GND), U3.3, U4.3, U5.3
unnamed: D1.2 (A), R9.1
unnamed: J8.A5 (CC1), R5.1
unnamed: J8.B5 (CC2), R6.1
unnamed: J8.A6 (D+), J8.B6 (D+), R7.1
unnamed: J8.A7 (D-), J8.B7 (D-), R8.1
unnamed: C2.2, R3.1, RESET1.2, U2.3 (EN)
unnamed: R4.1, SW1.2, U2.27 (IO0)
