gmaxdragon/Seizo-Screen/(commit log)

2026-10-31 Add PCB images, centralize attribution and remove STEP exports
2026-10-31 Add checked turnkey assembly BOMs, placements and quote package
2026-10-31 Add full project BOM, preliminary quote evidence and soldering request
2026-10-31 Add grouped BOM compatible with Half-Life repo importer
2026-10-31 Restore preliminary PCB and assembly prices in funding import
2026-11-01 Clarify panel-only assembly quote and include polarity map
2026-11-01 Record submitted PCBWay panel quotation and pending review
